arnaumora/TFG-Plataforma-Instrumentacion-Avionica/LATEX/Annexes/Files/00_Portada.tex

\newgeometry{left=3cm, right=0.5cm, top=2cm, bottom=2cm, headheight=0pt, headsep=0pt}

\pagestyle{empty}

\begin{spacing}{1.0}

% Logo UPC
\begin{figure}[h]

\end{figure}

% Banner vertical 
\begin{wrapfigure}{r}{0.25\textwidth} 
    \centering
    
\end{wrapfigure}

\phantom{abs}

\vspace{0.8cm}

% Título del TFG

\hfuzz=30pt

\textbf{\scalebox{2.4}{\textcolor{RoyalBlue}{Diseño e implementación de }}}

\vspace{0.3cm}

\textbf{\scalebox{2.4}{\textcolor{RoyalBlue}{una plataforma experimental }}}

\vspace{0.3cm}

\textbf{\scalebox{2.4}{\textcolor{RoyalBlue}{de instrumentación aviónica}}}

\hfuzz=0pt

\vspace{1.8cm}

% Documento
\textbf{\scalebox{1.5}{Documento:}}

\vspace{0.5cm}
\scalebox{1.5}{\textcolor{RoyalBlue}{Apendices y anexos}}

\vspace{1.5cm}

% Autor
\textbf{\scalebox{1.5}{Autor:}}

\vspace{0.5cm}
\scalebox{1.5}{\textcolor{RoyalBlue}{Arnau Mora Perez}}

\vspace{1.5cm}

% Director
\textbf{\scalebox{1.5}{Director/a:}}

\vspace{0.5cm}
\scalebox{1.5}{\textcolor{RoyalBlue}{Juan Mon González}}

\vspace{0.5cm}
\scalebox{1.5}{\textcolor{RoyalBlue}{Javier Gago Barrio}}

\vspace{1.5cm}

% Titulación
\textbf{\scalebox{1.5}{Titulación:}}

\vspace{0.5cm}
\scalebox{1.5}{\textcolor{RoyalBlue}{Grado en Ingeniería en Vehículos Aeroespaciales}}

\vspace{1.5cm}

% Convocatoria
\textbf{\scalebox{1.5}{Convocatoria:}}

\vspace{0.5cm}
\scalebox{1.5}{\textcolor{RoyalBlue}{Primavera, 2026}}

\end{spacing}

\restoregeometry
