arnaumora/TFG-Plataforma-Instrumentacion-Avionica/Presentacio/Spanish/Guion_ES.docx

# Guion de la presentacion

## Diapositiva 1 - Portada (~30 s)

Buenos dias. Soy Arnau Mora Perez y presento mi Trabajo de Fin de Grado, titulado 'Diseno e implementacion de una plataforma experimental de instrumentacion avionica', dirigido por Juan Mon y Javier Gago. El objetivo es construir una plataforma educativa y de bajo coste que recorra toda la cadena de instrumentacion de vuelo, desde el sensor hasta la pantalla.

## Diapositiva 2 - Indice (~20 s)

El recorrido sera el siguiente: motivacion y objetivo, arquitectura, los tres subsistemas (hardware, firmware y software), la telemetria, la validacion frente a los requisitos, y las conclusiones.

## Diapositiva 3 - Motivacion (~1 min)

La motivacion son las tres ideas de la diapositiva. Primera: la instrumentacion real es cara y cerrada. Los sistemas comerciales son propietarios y, aunque el ecosistema de drones (Betaflight, iNav) tiene firmware muy maduro, son millones de lineas de codigo y sus pantallas no siguen la normativa aeronautica. Segunda: hay un hueco didactico. En el aula se usan simuladores de vuelo sin hardware real; falta un puente, una plataforma fisica y abierta que muestre como funciona de verdad la instrumentacion. Y tercera: hoy es viable a bajo coste. Los sensores MEMS y los microcontroladores actuales permiten replicar toda la cadena por menos de 100 euros. Esa es la motivacion.

## Diapositiva 4 - Objetivo (~45 s)

El objetivo es disenar e implementar esta plataforma completa: capturar las magnitudes de vuelo con sensores, transmitirlas de forma inalambrica con un formato aeronautico, y representarlas en un Primary Flight Display conforme a la disposicion Basic-T. Todo por debajo de 100 euros de materiales y con software abierto.

## Diapositiva 5 - Requisitos (~1 min)

Aunque la plataforma no requiere certificacion, los requisitos se han derivado de normas aeronauticas reales para que sean medibles. Hay requisitos funcionales, de rendimiento, de coste y normativos. Los de rendimiento clave: latencia extremo a extremo por debajo de 200 ms, refresco del PFD de al menos 30 FPS, actitud dentro de 3 grados y posicionamiento GNSS mejor que 2,5 m. Sobre estos numeros se hara la validacion al final.

## Diapositiva 6 - Arquitectura (~1 min)

El sistema se divide en tres bloques. Un nodo transmisor con todos los sensores y un ESP32-S3, que adquiere y fusiona las medidas. Un enlace de radio, con un transceptor NRF24 en cada nodo, que transporta la telemetria. Y un nodo receptor con un ESP32-C3 que entrega los datos al PC por USB, donde Processing dibuja el PFD. La informacion fluye en un solo sentido: del sensor a la pantalla.

## Diapositiva 7 - Decisiones de diseno (~1 min 15 s)

Antes de entrar en el hardware, justifico tres decisiones de arquitectura. Primero, por que dos nodos y no uno: porque refleja la arquitectura real de una aeronave, da movilidad al nodo de sensores frente al PC fijo, y anade un enlace inalambrico con valor docente. Segundo, el enlace: se descartaron el cable, WiFi-UDP y Bluetooth, y se eligio un transceptor RF a 2,4 GHz por baja latencia, alcance suficiente y bajo coste. Y tercero, la telemetria usa la capa logica de ARINC 429, el bus de datos mas extendido en aviacion, por trazabilidad con la practica real y por valor docente. Un detalle que cierra el diseno: el payload de 32 bytes de la radio equivale exactamente a 8 palabras ARINC de 32 bits, asi que no hace falta fragmentar.

## Diapositiva 8 - Hardware: la PCB (~1 min)

El nodo transmisor se ha disenado como PCB propia de dos capas en KiCad, fabricada por JLCPCB. Integra el ESP32-S3, la IMU MPU-9250 con magnetometro, el barometro BMP280, el GNSS NEO-6M, el sensor de distancia VL53L1X, un radar y el modulo de radio NRF24 con amplificador. La alimentacion entra por USB-C: un regulador LDO da el rail de 3,3 V, y el rail de 5 V del propio USB alimenta los modulos que lo requieren.

## Diapositiva 9 - La placa fabricada (~45 s)

Aqui esta el hardware real. A la izquierda, el nodo transmisor ya fabricado y montado; a la derecha, el nodo receptor con el ESP32-C3. La placa funciono a la primera tras el bring-up: verificacion de continuidad contra el netlist con la placa sin alimentar, y medida de los railes de 5 y 3,3 voltios, que quedaron dentro de tolerancias.

## Diapositiva 10 - Seleccion del filtro de fusion (~1 min 15 s)

Para estimar la orientacion hay que fusionar acelerometro, giroscopio y magnetometro. He comparado las opciones: el filtro complementario es muy barato pero no corrige la deriva del giroscopio; Madgwick da una precision similar pero sin ajuste independiente del transitorio; EKF y UKF tienen mas coste de computo del necesario aqui; y el filtro de particulas, aunque preciso, es inviable en tiempo real sobre un ESP32. Se eligio Mahony porque compensa activamente la deriva del giroscopio con su termino integral PI, tiene un coste de computo bajo apto para el ESP32, y permite ajustar la respuesta con dos parametros. Varios estudios sobre ESP32 avalan esta eleccion.

## Diapositiva 11 - Firmware: fusion sensorial (~1 min 15 s)

En la implementacion del Mahony, los parametros son Kp = 3,0 y Ki = 1,0, con la fusion funcionando a 100 Hz. Para evitar el retardo de convergencia al arrancar, el cuaternion se inicializa de forma analitica a partir del acelerometro y el magnetometro, en lugar de partir de cero. Asi, desde el primer instante la actitud es valida y el termino integral solo tiene que seguir la deriva lenta del giroscopio.

## Diapositiva 12 - Telemetria ARINC 429 (~1 min 15 s)

La telemetria viaja codificada en palabras ARINC 429 de 32 bits, con sus etiquetas, codificacion BNR, bit de paridad y campo de estado. Como una sola palabra no basta para todos los parametros, el paquete se organiza asi: la actitud y el rumbo ocupan tres slots fijos a 20 Hz, y un planificador de tipo EDF, por plazo mas proximo, reparte los cinco slots restantes: barometro, velocidad vertical, radar y distancia a 10 Hz, y GPS y estado a 5 Hz. Cada paquete son 8 palabras de 32 bits, justo los 32 bytes del payload de la radio, que va a 250 kbps. El alcance, del orden de 100 m en interior, se justifica por margen de diseno; lo retomo en la validacion.

## Diapositiva 13 - El PFD Basic-T (~1 min)

La visualizacion sigue la disposicion Basic-T, conforme al patron que recoge la AC 25-11B: horizonte artificial en el centro, velocidad a la izquierda, altitud a la derecha y rumbo debajo, con la velocidad vertical y la proximidad integradas. Esta distribucion aprovecha el barrido visual natural del piloto. Esta hecho en Processing y refresca a 60 FPS, por encima del minimo de 30.

## Diapositiva 14 - Navegacion: mapa (~45 s)

En una pantalla aparte, conmutable por teclado, hay una vista de mapa que dibuja la posicion GNSS sobre teselas topograficas offline del ICGC. Se mantiene separada del Basic-T para no romper la disposicion normativa. La descarga de teselas en linea queda como trabajo futuro.

## Diapositiva 15 - Validacion: cumplimiento (~1 min 15 s)

Esta es la tabla de cumplimiento, la misma que consta en la memoria. Cada requisito de rendimiento se contrasta con el resultado medido o acotado. La latencia extremo a extremo, acotada analiticamente, sale en torno a los 85 ms en el peor caso, frente a los 200 de limite. El refresco del PFD, 60 FPS, el doble del minimo. La actitud, dentro de 1,8 grados en estatico. El GNSS, con un CEP50 de 1 metro, mejor que los 2,5 exigidos. Y el alcance del enlace, del orden de 100 m por margen de diseno, muy por encima del uso real en el laboratorio. Todos los requisitos se cumplen, y los funcionales, RF01 a RF09, quedan cubiertos con el sistema integrado.

## Diapositiva 16 - Validacion: cifras de merito (~1 min)

Aqui estan las cifras de merito juntas, y quiero ser explicito con la naturaleza de cada una. La actitud, 1,8 grados de error maximo, y el GNSS, 1 metro de CEP50, son medidas en estatico. La latencia, unos 85 ms, es una cota analitica de peor caso: la suma de los retardos de transporte de la cadena. Y el alcance, del orden de 100 m, procede del margen de diseno de la hoja de datos, no de una medida de campo. Distinguir lo medido de lo acotado forma parte del rigor de la validacion.

## Diapositiva 17 - Conclusiones (~1 min)

Como conclusiones: se ha construido una plataforma completa y funcional que recorre toda la cadena, del sensor al PFD, siguiendo criterios aeronauticos reales, por debajo de 100 euros y con software abierto. Cumple todos los requisitos de rendimiento planteados, y como herramienta docente permite estudiar fusion sensorial, codificacion aeronautica y enlaces inalambricos sobre hardware real.

## Diapositiva 18 - Trabajo futuro (~45 s)

De cara al futuro, cuatro lineas. La descarga en linea de teselas de mapa. La caracterizacion real del enlace, con medidas de alcance y de tasa de perdida de paquetes. Incorporar el radar como fuente de proximidad, una vez estabilizada su lectura. Y, como linea mas ambiciosa, la integracion del sistema en un vehiculo aereo real.

## Diapositiva 19 - Gracias / demo (~30 s + demo)

Con esto termino. Gracias por su atencion. Si lo desean, puedo mostrar el sistema en funcionamiento. Quedo a su disposicion para las preguntas.
