arnaumora/TFG-Plataforma-Instrumentacion-Avionica/Entrega/Budget.pdf

# Diseño e implementación de una plataforma experimental de instrumentación aviónica

## Documento:

## Presupuesto

## Autor:

## Arnau Mora Perez

## Director/a:

## Juan Mon González Javier Gago Barrio

## Titulación:

## Grado en Ingeniería en Vehículos Aeroespaciales

## Convocatoria:

## Primavera, 2026

Intentionally left blank

# Capítulo 1

# Presupuesto

En este documento se detalla el presupuesto del proyecto, el desglose completo del coste de desarrollo de la plataforma experimental de instrumentación aviónica. El coste se desglosa en el coste de los materiales, la amortización de los equipos empleados, el coste de personal y el coste de software. Los costes de los componentes se detallan en la memoria, en el capítulo de diseño de hardware.
Salvo que se indique lo contrario, los precios son orientativos y se basan en el coste de mercado de los componentes y en tarifas de referencia.

## 1.1. Coste de materiales

El coste de los materiales corresponde a los componentes electrónicos del sistema, la placa de circuito impreso (PCB) y los componentes pasivos y conectores. El subtotal de módulos se toma del resumen de componentes de la memoria. La PCB se fabrica mediante el servicio JLCPCB,
i
en una única orden que integra tanto el nodo transmisor como el nodo receptor.
En la Tabla 1.1 se pueden ver los valores de todos los componentes.
iServicio de fabricación de PCB de bajo coste: https://jlcpcb.com/. El coste depende del número de unidades de la tirada y del envío.

1

CAPÍTULO 1. PRESUPUESTO | 2

Tabla 1.1: Coste de materiales

Concepto | Coste
Microcontrolador TX (ESP32-S3 DevKit) | 7 e
Microcontrolador RX (ESP32-C3 Super Mini) | 4 e
IMU + magnetómetro (MPU-9250) | 6 e
Barómetro (BMP280) | 3 e
Receptor GNSS (NEO-6M) | 10 e
Sensor ToF (VL53L1X) | 8 e
Sensor radar (HLK-LD2410C) | 9 e
Transceptor RF, 2 uds (nRF24L01+ PA/LNA) | 8 e
Subtotal módulos | 55 e
PCB (2 capas, JLCPCB, incl. envío) | 25 e
Componentes pasivos y conectores | 12 e
Total materiales | 92 e

El coste total de materiales se mantiene por debajo de los 100 e, cumpliendo la restricción de coste de materiales del proyecto (RC01).

## 1.2. Amortización de equipos

Para el desarrollo se han empleado diversos equipos de laboratorio cuyo coste no se imputa de forma íntegra, sino mediante amortización lineal en proporción a las horas de uso sobre su vida útil. La amortización de cada equipo se calcula como:

A =

V
Tvida

·

huso
hanual

(1.1)

donde V es el valor de adquisición, Tvida la vida útil en años, huso las horas de uso en el proyecto y hanual las horas anuales de trabajo, estimadas en 1.800 h. La Tabla 1.2 recoge la estimación para cada equipo.

Tabla 1.2: Amortización de equipos

Equipo | Valor (e) | Vida útil (años) | Uso (h) | Amort. (e)
Osciloscopio | 400 | 10 | 20 | 0,44
Multímetro | 40 | 10 | 30 | 0,07
Estación de soldadura | 80 | 10 | 15 | 0,07
Ordenador | 1.000 | 6 | 400 | 37,04
Total amortización | | | | 37,62

## 1.3. Coste de personal

El coste de personal corresponde a las horas de ingeniería dedicadas al diseño, el desarrollo, la validación y la redacción del trabajo. La dedicación se estima a partir de los créditos ECTS del TFG: la normativa de la UPC establece una carga de trabajo de 25 h por crédito ECTS,ii lo que para un TFG de 24 ECTS equivale a 600 h. Se aplica una tarifa orientativa de 18 e/h correspondiente a un ingeniero junior.iii
La Tabla 1.3 recoge la estimación.
Tabla 1.3: Coste de personal
Concepto | | Horas | Tarifa | Coste
Ingeniería (diseño, desarrollo, validación y redacción) | 600 | 18 e/h | 10.800 e
Total personal | | | | 10.800 e

## 1.4. Coste de software

Todo el software utilizado en el proyecto es de código abierto o de uso gratuito, en cumplimiento de la restricción RC02. El firmware se desarrolla en el IDE de Arduino, el software de visualiza-ción en Processing, el diseño de la PCB en KiCad y la redacción de la documentación en LaTeX. Ninguna de estas herramientas conlleva coste de licencia, por lo que el coste de software es de 0 e.
iiNormativa del Trabajo de Fin de Grado y de Máster de la UPC: la carga de trabajo equivalente es de 1 ECTS por 25 horas de trabajo del estudiantado.
iiiTarifa orientativa basada en salarios de referencia para ingenieros en España (p. ej. https://es.talent.com/salary). (https://es.talent.com/salary)

El consumo eléctrico asociado al desarrollo es despreciable, aun asi se considera que queda recogido de forma indirecta en la amortización del ordenador, por lo que no se contabiliza de forma separada.

## 1.5. Resumen del presupuesto

La Tabla 1.4 agrupa todos los costes anteriores. Sobre la suma de las partidas se aplica un 10 % correspondiente a costes indirectos y, finalmente, el impuesto sobre el valor añadido (IVA) del 21 %.
Tabla 1.4: Resumen del presupuesto
Concepto | Coste
Materiales | 92 e
Amortización de equipos | 37,62 e
Software | 0 e
Personal | 10.800 e
Subtotal | 10.929,62 e
Costes indirectos (10 %) | 1.092,96 e
Total (sin IVA) | 12.022,58 e
IVA (21 %) | 2.524,74 e
Total (con IVA) | 14.547,32 e

El coste total del proyecto asciende a 14.547,32 e (IVA incluido). Como es habitual en proyectos de esta naturaleza, el coste está dominado por el coste de personal, mientras que el coste de materiales resulta marginal, en parte gracias al uso de hardware de bajo coste y software de código abierto.
