arnaumora/TFG-Plataforma-Instrumentacion-Avionica/Entrega/Compressed/Anexos.pdf

# Diseño e implementación de una plataforma experimental de instrumentación aviónica

# Documento:

# Apendices y anexos

# Autor:

# Arnau Mora Perez

# Director/a:

# Juan Mon González Javier Gago Barrio

# Titulación:

# Grado en Ingeniería en Vehículos Aeroespaciales

# Convocatoria:

# Primavera, 2026

Intentionally left blank

# Índice general

1. ANEXO I. Código Arduino | 1
2. ANEXO II. Código Processing | 51
3. ANEXO III. Figuras de apoyo | 88

I

# Índice de figuras

II

# Índice de tablas

III

# Capítulo 1

# ANEXO I. Código Arduino

1 // FlightInstruments.ino - Sketch principal (transmisor)
2 //
3 // TFG: Diseno e implementacion de una plataforma experimental de 4 // instrumentacion avionica.

5
6 #include <Wire.h>
7 #include "Config.h"
8 #include "SensorData.h"

9
10 // Estructuras de datos 11 RawIMU rawIMU;
12 FlightData flightData;
13 BaroData baroData;
14 GPSData gpsData;
15 RadarData radarData;
16 ToFData tofData;

17
18 // Timers para scheduling cooperativo. Cada subsistema corre a su 19 // frecuencia natural sin bloquear a los demas. El loop principal 20 // solo dispara la tarea que toca segun el reloj.
21 unsigned long lastSensorRead | = 0;
22 unsigned long lastBaroRead | = 0;
23 unsigned long lastSerialPrint = 0;
24 unsigned long lastTelemetrySend = 0;

25
26 bool radioAvailable = false;

27
28 // Contadores de transmision, definidos en Telemetry.ino 29 extern uint32_t txCount;

1

CAPÍTULO 1. ANEXO I. CÓDIGO ARDUINO | 2

30 extern uint32_t txFailCount;

32 void setup() {
Serial.begin(115200);
delay(2000);

Serial.println(" Flight Instruments");
Serial.println(" ESP32-S3 + MPU-9250 + BMP280 + VL53L1X"); Serial.println(" + NEO-6M + LD2410C + NRF24L01+PA+LNA"); Serial.println(" Filtro: Mahony MARG (9 ejes)");

neopixelWrite(PIN_LED_RGB, 30, 0, 0); // rojo = booting

// XSHUT del ToF en alto para que el sensor arranque pinMode(TOF_SHUT_PIN, OUTPUT);
digitalWrite(TOF_SHUT_PIN, HIGH);
delay(10);

// Interrupciones (no usadas, solo se dejan los pines configurados) pinMode(TOF_IRQ_PIN, INPUT);
pinMode(RADAR_IRQ_PIN, INPUT);
pinMode(MPU_IRQ_PIN, INPUT);

// Bus I2C compartido
Wire.begin(PIN_SDA, PIN_SCL);
Wire.setClock(I2C_CLOCK);
Serial.println("I2C OK (400 kHz)");

// IMU. Es el unico sensor critico: si falla se bloquea el arranque if (!initIMU()) {
Serial.println("FATAL: fallo al inicializar el IMU");
while (true) { // parpadeo rojo perpetuo neopixelWrite(PIN_LED_RGB, 30, 0, 0); delay(300); neopixelWrite(PIN_LED_RGB, 0, 0, 0); delay(300);

}

}

// Calibracion del giroscopio
calibrateGyro();

initFusion(flightData);

// Semilla del cuaternion con una muestra accel+mag para que el // filtro Mahony arranque mas cerca de la orientacion real

delay(20);
readIMU(rawIMU);
seedQuaternionFromIMU(rawIMU);

// Sensores no criticos: si alguno falla el sistema sigue, solo // queda marcado con ok=false y la palabra ARINC correspondiente
// se transmite con SSM=NO_DATA
baroData.ok = initBarometer();
if (!baroData.ok) Serial.println("AVISO: barometro offline, sin altitud barometrica");

tofData.ok = initToF();
if (!tofData.ok) Serial.println("AVISO: ToF offline, sin distancia al suelo") ;

initGPS(); // el flag ok se activa en el primer readGPS() valido radarData.ok = initRadar();

radioAvailable = initTelemetry();
if (!radioAvailable) Serial.println("AVISO: radio offline, sigue sin telemetria");

93 #ifdef CALIBRATE_MAG
runMagCalOperational(); // solo la LLAMADA; captura y luego halt 95 #endif

neopixelWrite(PIN_LED_RGB, 0, 30, 0); // verde = listo Serial.println("\nSistema listo. Streaming...\n");

99 }

101 void loop() {
unsigned long nowUs = micros();
unsigned long nowMs = millis();

// Alimentamos buffers de UART cada iteracion (no bloqueante).
// Si se descuida aunque sea un ciclo, la UART se satura y se pierden frames. feedGPS();
feedRadar();

// IMU + fusion a 100 Hz
if (nowUs - lastSensorRead >= SENSOR_INTERVAL_US) { lastSensorRead = nowUs;
readIMU(rawIMU);
updateFusion(rawIMU, flightData);

}

// Barometro a 10 Hz
if (baroData.ok && (nowMs - lastBaroRead >= BARO_INTERVAL_MS)) { lastBaroRead = nowMs;
readBarometer(baroData);

}

// ToF (no bloqueante, solo actualiza si hay muestra nueva) readToF(tofData);

// GPS
readGPS(gpsData);

// Radar (recibe la velocidad GPS para filtrar detecciones estaticas o en movimiento)
float platformSpeed = gpsData.fix ? gpsData.speed_kmh : 0.0f; readRadar(radarData, platformSpeed);

// Telemetria a 20 Hz
if (radioAvailable && (nowMs - lastTelemetrySend >= TELEMETRY_INTERVAL_MS)) { lastTelemetrySend = nowMs;
sendTelemetry(flightData, baroData, gpsData, radarData, tofData);

}

// Debug por serial a 10 Hz. Solo se compila si DEBUG_SERIAL esta // definido (ver Config.h) ya que el transmisor normalmente no esta // conectado por USB, asi se ahorra computacion.
143 #ifdef DEBUG_SERIAL
if (nowMs - lastSerialPrint >= SERIAL_PRINT_INTERVAL) { lastSerialPrint = nowMs;

// Magnitud del campo magnetico para diagnostico float magMag = sqrtf(rawIMU.mx * rawIMU.mx
+ rawIMU.my * rawIMU.my
+ rawIMU.mz * rawIMU.mz);

float lossPct = (txCount > 0) ? (txFailCount * 100.0f / txCount) : 0.0f; Serial.printf(
"P: %.1f R: %.1f H: %.1f |Mag: %.1fuT| Alt: %.1f VS: %.1f | Sat: %d %s"
" | Rdr: %ucm ToF: %umm | TX: %lu L: %.1f % %\n",
flightData.pitch, flightData.roll, flightData.heading, magMag, baroData.altitude_m, baroData.vspeed_mps, gpsData.satellites, gpsData.fix ? "Fix" : "NoFix", radarData.bestDist_cm, tofData.distance_mm, txCount, lossPct

);

}
163 #endif

164 }

168 // Calibracion del magnetometro
169 // Calibracion hard/soft iron con el sistema completo en operacion.

171 #ifdef CALIBRATE_MAG
172 extern float magCalX, magCalY, magCalZ; // ASA de fabrica, definidos en IMU. ino

174 void runMagCalOperational() {
Serial.println("\nCAL MAG: Esperando fix GPS con el sistema en operacion...") ;
unsigned long tStart = millis(), tWarmTx = 0, tWarmPrint = 0;

// Bucle que no termina hasta que el GPS obtenga un Fix válido
while (!gpsData.fix) {
// Reproduce el loop normal para mantener el sistema vivo feedGPS(); feedRadar();
readIMU(rawIMU);
updateFusion(rawIMU, flightData); readBarometer(baroData);
readToF(tofData);
readGPS(gpsData);
readRadar(radarData, gpsData.fix ? gpsData.speed_kmh : 0.0f);

// Comprobamos radioAvailable antes de transmitir
if (radioAvailable && (millis() - tWarmTx >= TELEMETRY_INTERVAL_MS)) { tWarmTx = millis();
sendTelemetry(flightData, baroData, gpsData, radarData, tofData);

}

// Imprimir el estado cada segundo para ver el progreso
if (millis() - tWarmPrint > 1000) {
tWarmPrint = millis();
Serial.print("WARMUP: Esperando GPS... Tiempo transcurrido: "); Serial.print((millis() - tStart) / 1000UL);

Serial.print("s GPS: NoFix"); Serial.print(" Sat: ");
Serial.println(gpsData.satellites);

}

}

Serial.println("\nGPS Fix conseguido. Dando 5 segundos de estabilizacion final...");
delay(5000);

Serial.println("\nCAL MAG: rotar LENTO en los 3 ejes durante 30 s");
for (int i = 5; i > 0; i--) { Serial.print(i); Serial.print("... "); delay (1000); }
Serial.println("\n>>> ROTAR AHORA <<<\n");

float minX=1e6f, minY=1e6f, minZ=1e6f;
float maxX=-1e6f, maxY=-1e6f, maxZ=-1e6f; unsigned long t0 = millis(), tTx = 0, tPrint = 0;
uint32_t n = 0;

while (millis() - t0 < 30000UL) {
// Reproduce el loop normal: radio TX a 20 Hz + todos los sensores activos // Asi la calibracion se hace con los sensores en funcionamiento feedGPS(); feedRadar();
readIMU(rawIMU);
updateFusion(rawIMU, flightData);
readBarometer(baroData);
readToF(tofData);
readGPS(gpsData);
readRadar(radarData, gpsData.fix ? gpsData.speed_kmh : 0.0f);

// Comprobamos radioAvailable antes de transmitir
if (radioAvailable && (millis() - tTx >= TELEMETRY_INTERVAL_MS)) { tTx = millis();
sendTelemetry(flightData, baroData, gpsData, radarData, tofData);

}

// Mag SOLO con ASA (sin offset/scale) Wire.beginTransmission(AK8963_ADDR); Wire.write(0x03); Wire.endTransmission (false);
Wire.requestFrom(AK8963_ADDR, (byte)7);
if (Wire.available() >= 7) {
int16_t xr = Wire.read() | (Wire.read() << 8);
int16_t yr = Wire.read() | (Wire.read() << 8);

241 | int16_t zr = Wire.read() | (Wire.read() << 8);
242 | (void)Wire.read(); // ST2, obligatorio leerlo
243 | float mx = xr * MAG_SCALE * magCalX;
244 | float my = yr * MAG_SCALE * magCalY;
245 | float mz = zr * MAG_SCALE * magCalZ;
246 | if (mx<minX) minX=mx; if (mx>maxX) maxX=mx;
247 | if (my<minY) minY=my; if (my>maxY) maxY=my;
248 | if (mz<minZ) minZ=mz; if (mz>maxZ) maxZ=mz;
249 | n++;
250 | }

251
252 | if (millis() - tPrint > 1000) {
253 | tPrint = millis();
254 | Serial.print("CAL t-"); Serial.print((30000UL - (millis()-t0)) / 1000UL);
255 | Serial.print("s N="); Serial.println(n);
256 | }
257 | }

258
259 | // Offset = centro del elipsoide. escala = correccion soft iron por eje
260 | float offX=(maxX+minX)*0.5f, offY=(maxY+minY)*0.5f, offZ=(maxZ+minZ)*0.5f;
261 | float rX=(maxX-minX)*0.5f, rY=(maxY-minY)*0.5f, rZ=(maxZ-minZ)*0.5f;
262 | float avg=(rX+rY+rZ)/3.0f;
263 | float scX=(rX>0.1f)?avg/rX:1.0f, scY=(rY>0.1f)?avg/rY:1.0f, scZ=(rZ>0.1f)?avg
| /rZ:1.0f;

264
265 | Serial.println("\nCALIBRACION COMPLETADA");
266 | Serial.print("Muestras: "); Serial.println(n);
267 | Serial.print("Magnitud media: "); Serial.print(avg,1);
268 | Serial.println(" uT (esperado ~46 uT, WMM2025 Terrassa)");
269 | Serial.println("\nPEGAR EN Config.h (sustituir las 6 lineas existentes):\n");
270 | Serial.print("#define MAG_OFFSET_X | "); Serial.print(offX,4); Serial.
| println("f");
271 | Serial.print("#define MAG_OFFSET_Y | "); Serial.print(offY,4); Serial.
| println("f");
272 | Serial.print("#define MAG_OFFSET_Z | "); Serial.print(offZ,4); Serial.
| println("f");
273 | Serial.print("#define MAG_SCALE_X | "); Serial.print(scX,4); Serial.
| println("f");
274 | Serial.print("#define MAG_SCALE_Y | "); Serial.print(scY,4); Serial.
| println("f");
275 | Serial.print("#define MAG_SCALE_Z | "); Serial.print(scZ,4); Serial.
| println("f");

276
277 while (true) { // halt: no seguir al loop normal. Reflashear sin

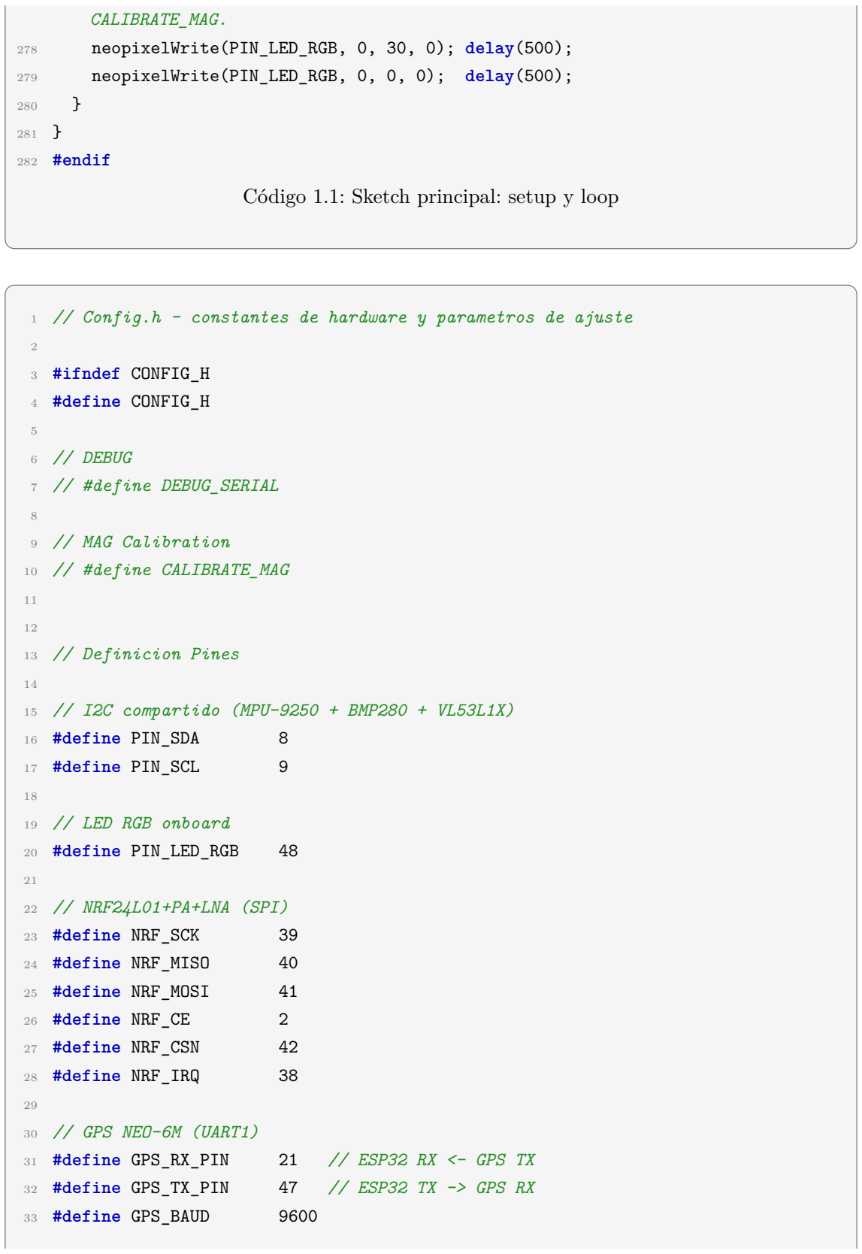
[picture p34: figure]
CALIBRATE_MAG.; neopixelWrite(PIN_LED_RGB, 0, 30, 0); delay(500);; neopixelWrite(PIN_LED_RGB, 0, 0, 0); delay(500);; 281 } 282 #endif; 2 3 #ifndef CONFIG_H 4 #define CONFIG_H; 5 6 // DEBUG 7 // #define DEBUG_SERIAL; 8 9 // MAG Calibration 10 // #define CALIBRATE_MAG; 12 13 // Definicion Pines; 16 #define PIN_SDA; 17 #define PIN_SCL; 18 19 // LED RGB onboard; 20 #define PIN_LED_RGB; 21 22 // NRF24L01+PA+LNA (SPI); 23 #define NRF_SCK; 24 #define NRF_MISO; 25 #define NRF_MOSI; 26 #define NRF_CE; 27 #define NRF_CSN; 28 #define NRF_IRQ; 29 30 // GPS NEO-6M (UART1); 33 #define GPS_BAUD

Código 1.1: Sketch principal: setup y loop

1 // Config.h - constantes de hardware y parametros de ajuste

15 // I2C compartido (MPU-9250 + BMP280 + VL53L1X)

31 #define GPS_RX_PIN | 21 // ESP32 RX <- GPS TX
32 #define GPS_TX_PIN | 47 // ESP32 TX -> GPS RX

34
35 // HLK-LD2410C radar (UART2) 36 #define RADAR_RX_PIN 17 37 #define RADAR_TX_PIN 18
38 #define RADAR_BAUD 256000

39
40 // Interrupciones / control (no usadas en el codigo, pero asignadas) 41 #define TOF_SHUT_PIN 11 // XSHUT del TOF400C
42 #define TOF_IRQ_PIN 10 // INT del TOF400C
43 #define RADAR_IRQ_PIN 16
44 #define MPU_IRQ_PIN 4

45
46 // Direcciones I2C
47 #define MPU9250_ADDR 0x68 // AD0 a GND
48 #define AK8963_ADDR | 0x0C // magnetometro en el MPU-9250
49 #define BMP280_ADDR | 0x76 // SDO a GND
50 #define VL53L1X_ADDR 0x29 // direccion por defecto del TOF400C 51 #define I2C_CLOCK 400000 // 400 kHz (Fast Mode)

52
53 // Rangos del MPU-9250
54 // Factores sacados del datasheet PS-MPU-9250A-01 Rev 1.1
55 #define ACCEL_SCALE | 8192.0 // LSB/g | a +/-4g
56 #define GYRO_SCALE | 65.5 | // LSB/(deg/s) a +/-500deg/s
57 #define MAG_SCALE | 0.15 | // uT/LSB | en 16 bits

58
59 // BMP280
60 #define SEA_LEVEL_HPA | 1013.25f // presion de referencia ISA
61 #define VSPEED_ALPHA | 0.2f | // suavizado EMA de la velocidad vertical

62
63 // VL53L1X / TOF400C
64 #define TOF_TIMING_BUDGET_US 50000 // 50 ms modo Long permite hasta 4 m
65 #define TOF_CONTINUOUS_MS | 50 | // 20 Hz
66 #define TOF_DEAD_ZONE_MM | 40 | // por debajo de aqui la medida no es
fiable

67
68 // HLK-LD2410C

69
70 // Resolucion del gate.
71 #define RADAR_GATE_WIDTH_CM 20

72
73 // Thresholds por gate (downward-facing)
74 #define RADAR_SENS_GATE_0 | 80 // 0.00 - 0.20 m
75 #define RADAR_SENS_GATE_1 | 70 | // 0.20 - 0.40 m
76 #define RADAR_SENS_GATE_2 | 60 | // 0.40 - 0.60 m

77 #define RADAR_SENS_GATE_3 | 50 | // 0.60 - 0.80 m
78 #define RADAR_SENS_GATE_FAR | 35 | // 0.80 - 1.80 m (gates 4-8)

79
80 // Peak-finder (modo enhanced)
81 #define RADAR_NOISE_FLOOR 40

82
83 // Suavizado EMA de la distancia derivada por gate
84 #define RADAR_DIST_ALPHA 0.40f

85
86 #define RADAR_HOVER_SPEED_KMH 2.0f // por debajo de esta velocidad se considera hover
87 #define RADAR_ALERT_ENERGY_MIN 30 // energia minima para disparar alerta

88
89 // Zona de proximidad en funcion de la distancia
90 #define RADAR_ZONE_NONE | 0
91 #define RADAR_ZONE_DANGER | 1 | // 0.00 - 0.60 m (gates 0-2)
92 #define RADAR_ZONE_CAUTION | 2 | // 0.60 - 1.20 m (gates 3-5)
93 #define RADAR_ZONE_CLEAR | 3 | // 1.20 - 1.80 m (gates 6-8)

94
95 // Tasas de muestreo
96 #define SENSOR_RATE_HZ | 100 | // IMU + fusion
97 #define SENSOR_INTERVAL_US (1000000 / SENSOR_RATE_HZ)

98
99 #define BARO_RATE_HZ | 10
100 #define BARO_INTERVAL_MS | (1000 / BARO_RATE_HZ)

101
102 #define RADAR_PRINT_HZ 2
103 #define RADAR_PRINT_INTERVAL (1000 / RADAR_PRINT_HZ)

104
105 #define SERIAL_PRINT_HZ 10
106 #define SERIAL_PRINT_INTERVAL (1000 / SERIAL_PRINT_HZ)

107
108 // Calibracion del giroscopio
109 #define CALIBRATION_SAMPLES | | 500
110 #define CALIBRATION_VARIANCE_THRESHOLD 2.0

111
112 // Mahony
113 #define MAHONY_KP | 3.0f
114 #define MAHONY_KI | 1.0f

115

116
117 // CALIBRACION DEL MAGNETOMETRO (Hard iron / Soft iron)

118
119 // Hard iron offsets (uT)

120 #define MAG_OFFSET_X | 10.6264f
121 #define MAG_OFFSET_Y | -2.6479f
122 #define MAG_OFFSET_Z | -30.1492f

123
124 // Soft iron scales (adimensional)
125 #define MAG_SCALE_X | 1.0157f
126 #define MAG_SCALE_Y | 0.9977f
127 #define MAG_SCALE_Z | 0.9884f

128
129 // CORRECCIONES DE HEADING

130 //
131 // Declinacion magnetica
132 // Diferencia entre el norte magnetico (lo que mide el sensor) y el
133 // norte geografico verdadero. Para obtener el valor real visitar la web 134 // (https://www.ncei.noaa.gov/products/world-magnetic-model)

135
136 #define MAG_DECLINATION_DEG 1.95f

137
138 // Offset entre el "forward" del IMU y el "forward" de la PCB 139 // Si la IMU esta rotada respecto a la placa, el heading
140 // tendra un offset constante respecto al norte real.
141 // Tambien se puede usar para corregir errores constantes 142 // que no provienen de la orientacion de la PCB

143
144 #define HEADING_BODY_OFFSET_DEG -5.0f

145
146 // Calibracion actitud
147 #define PITCH_MOUNT_OFFSET_DEG | 0.6f
148 #define ROLL_MOUNT_OFFSET_DEG | 0.2f

149

150
151 // NRF24L01
152 #define NRF_CHANNEL | 108
153 #define NRF_DATA_RATE | RF24_250KBPS
154 #define NRF_PA_LEVEL | RF24_PA_HIGH
155 #define NRF_RETRY_DELAY | 5
156 #define NRF_RETRY_COUNT | 15

157
158 #define NRF_ADDR_TX | "SENSR"
159 #define NRF_ADDR_RX | "CNTRL"

160
161 #define TELEMETRY_RATE_HZ 20
162 #define TELEMETRY_INTERVAL_MS (1000 / TELEMETRY_RATE_HZ)

163

164 #endif
Código 1.2: Constantes de hardware y parámetros de ajuste

1 // SensorData.h - estructuras de datos compartidas entre los archivos.

2
3 #ifndef SENSORDATA_H
4 #define SENSORDATA_H

5
6 // IMU sin procesar (MPU-9250 + AK8963)
7 struct RawIMU {
8 | float ax, ay, az; // acelerometro (g)
9 | float gx, gy, gz; // giroscopio (deg/s), ya con bias restado
10 | float mx, my, mz; // magnetometro (uT), ya con ASA aplicado

11 };

12
13 // AHRS ya fusionado
14 struct FlightData {
15 | float pitch; | // -90 a +90deg (nariz arriba positivo)
16 | float roll; | // -180 a +180deg (ala derecha abajo positivo)
17 | float heading; | // 0 a 360deg (norte magnetico = 0)
18 | float q0, q1, q2, q3; // cuaternion
19 | unsigned long lastUpdate;

20 };

21
22 // Barometro (BMP280)
23 struct BaroData {
24 | float pressure_hPa;
25 | float temperature_C;
26 | float altitude_m; | // altitud barometrica MSL
27 | float vspeed_mps; | // velocidad vertical filtrada con EMA
28 | bool ok;

29 };

30
31 // GPS (NEO-6M)
32 struct GPSData {
33 | double lat;
34 | double lon;
35 | float altitude_m;
36 | float speed_kmh;
37 | float course_deg;
38 | uint8_t satellites;

39 | bool fix; | // posicion valida
40 | bool ok; | // UART recibiendo datos

41 };

42
43 // Radar (HLK-LD2410C)
44 struct RadarData {
45 | bool | presence;
46 | bool | movingDetected;
47 | uint16_t movingDist_cm;
48 | uint8_t movingEnergy;
49 | bool | stationaryDetected;
50 | uint16_t stationaryDist_cm;
51 | uint8_t stationaryEnergy;
52 | bool | ok;
53 | bool | platformStationary;
54 | uint16_t bestDist_cm;
55 | uint8_t maxEnergy;
56 | uint8_t proximityZone;
57 | bool | movingTargetAlert;

58 };

59
60 // Time-of-Flight (VL53L1X / TOF400C) 61 struct ToFData {
62 | uint16_t distance_mm;
63 | bool | valid;
64 | bool | ok;

65 };

66
67 // Paquete de telemetria ARINC 429 sobre NRF24L01

68 //
69 // El paquete ocupa 32 bytes (8 palabras x 32 bits = payload maximo del 70 // NRF24L01) y se envia a 20 Hz.
71 struct ARINC429Packet {
72 uint32_t words[8];

73 };

74
75 // Slot vacio: una palabra con label 0 y SSM = NO_DATA, asi el receptor
76 // la ignora limpiamente. Lo usa el planificador cuando no hay nada que
77 // mandar en un slot
78 #define A429_EMPTY_WORD | 0x20000000UL // SSM=01 (no data), todo cero

79
80 // Layout del campo discrete de la palabra de status (19 bits utiles)
81 #define A429_STATUS_SATS_MASK | 0x0000F
82 #define A429_STATUS_FIX | 0x00010

83 #define A429_STATUS_IMU_OK | 0x00020
84 #define A429_STATUS_BARO_OK | 0x00040
85 #define A429_STATUS_RADAR_OK | 0x00080
86 #define A429_STATUS_TOF_OK | 0x00100
87 #define A429_STATUS_RADAR_ZONE_SH 9
88 #define A429_STATUS_RADAR_ZONE_MASK 0x00600
89 #define A429_STATUS_RADAR_ALERT | 0x00800
90 #define A429_STATUS_PLAT_MOVING | 0x01000
91 #define A429_STATUS_SEQ_SH | 13
92 #define A429_STATUS_SEQ_MASK | 0x7E000

93
94 // Codificacion de la posicion GNSS en ARINC 429 BNR
95 // Valor de referencia para mejorar la medida
96 #define GPS_LAT_REF_DEG | 41.0 | // referencia de latitud
97 #define GPS_LON_REF_DEG | 1.0 | // referencia de longitud
98 #define A429_LSB_LATLON_DEG (1.0f / 262144.0f) | // ~3.81e-6 deg/LSB (~0.42
m)

99
100 #endif
Código 1.3: Estructuras de datos compartidas

1 // Calibration.ino - calibracion del bias del giroscopio al arranque.

2
3 // Bias del giroscopio
4 float gyroBiasX = 0, gyroBiasY = 0, gyroBiasZ = 0;

5
6 void calibrateGyro() {
7 | Serial.println("CAL: Calibrando gyro NO MOVER EL SENSOR...");
8 | neopixelWrite(PIN_LED_RGB, 30, 15, 0); // ambar mientras se calibra

9
10 | float sumX = 0, sumY = 0, sumZ = 0;
11 | float sumSqX = 0, sumSqY = 0, sumSqZ = 0;

12
13 | for (int i = 0; i < CALIBRATION_SAMPLES; i++) {
14 | float gx = readWord(MPU9250_ADDR, 0x43) / GYRO_SCALE;
15 | float gy = readWord(MPU9250_ADDR, 0x45) / GYRO_SCALE;
16 | float gz = readWord(MPU9250_ADDR, 0x47) / GYRO_SCALE;

17
18 | sumX += gx; sumY += gy; sumZ += gz;
19 | sumSqX += gx * gx;
20 | sumSqY += gy * gy;

sumSqZ += gz * gz;

delay(10);

}

float meanX = sumX / CALIBRATION_SAMPLES; float meanY = sumY / CALIBRATION_SAMPLES;
float meanZ = sumZ / CALIBRATION_SAMPLES;

// Varianza: Var = E[X^2] - E[X]^2
float varX = (sumSqX / CALIBRATION_SAMPLES) - (meanX * meanX); float varY = (sumSqY / CALIBRATION_SAMPLES) - (meanY * meanY); float varZ = (sumSqZ / CALIBRATION_SAMPLES) - (meanZ * meanZ); float maxVariance = max(varX, max(varY, varZ));

Serial.print("CAL: Varianza X="); Serial.print(varX, 4);
Serial.print(" Y="); Serial.print(varY, 4);
Serial.print(" Z="); Serial.print(varZ, 4);
Serial.print(" (umbral="); Serial.print(CALIBRATION_VARIANCE_THRESHOLD, 1); Serial.println(")");

if (maxVariance < CALIBRATION_VARIANCE_THRESHOLD) {
// Sensor en reposo durante toda la captura: la media es un bias fiable gyroBiasX = meanX;
gyroBiasY = meanY;
gyroBiasZ = meanZ;

Serial.print("CAL: [LIVE] Bias X="); Serial.print(gyroBiasX, 4); Serial.print(" Y="); Serial.print(gyroBiasY, 4);
Serial.print(" Z="); Serial.println(gyroBiasZ, 4);
} else {
// Movimiento detectado durante la calibracion. Como fallback se usan // valores tipicos obtenidos previamente en prueba controlada, y el // filtro mahony convergera al valor real mas rapido.
gyroBiasX = -0.2359;
gyroBiasY = 0.3017;
gyroBiasZ = -0.5030;
Serial.println("CAL: AVISO: movimiento detectado, usando bias por defecto") ;

}

Serial.println("CAL: Calibracion del gyro completada.");

62 }
Código 1.4: Calibración del bias del giroscopio

1 // IMU.ino - lectura cruda del MPU-9250 (accel + gyro) y del AK8963 (mag). 2 // La fusion a Euler/quaternion se hace en SensorFusion.ino.

3

4
5 // Ajuste de sensibilidad de fabrica (ASA) del magnetometro 6 float magCalX = 1.0f, magCalY = 1.0f, magCalZ = 1.0f;

7
8 // Helpers I2C
9 void writeRegister(byte addr, byte reg, byte val) {
10 | Wire.beginTransmission(addr);
11 | Wire.write(reg);
12 | Wire.write(val);
13 | Wire.endTransmission();

14 }

15
16 int16_t readWord(byte addr, byte reg) {
17 | Wire.beginTransmission(addr);
18 | Wire.write(reg);
19 | Wire.endTransmission(false);
20 | Wire.requestFrom(addr, (byte)2);
21 | uint8_t msb = Wire.read();
22 | uint8_t lsb = Wire.read();
23 | return (msb << 8) | lsb;

24 }

25
26 // Inicializacion
27 bool initIMU() {
28 | // Sale del modo sleep
29 | writeRegister(MPU9250_ADDR, 0x6B, 0x00);
30 | delay(100);

31
32 | // Comprueba WHO_AM_I - debe ser 0x71
33 | Wire.beginTransmission(MPU9250_ADDR);
34 | Wire.write(0x75);
35 | Wire.endTransmission(false);
36 | Wire.requestFrom(MPU9250_ADDR, (byte)1);
37 | byte whoAmI = Wire.read();

38

if (whoAmI != 0x71) {
Serial.print("IMU ERROR: WHO_AM_I = 0x"); Serial.println(whoAmI, HEX);
return false;

}

writeRegister(MPU9250_ADDR, 0x1C, 0x08); // Accel +/-4g writeRegister(MPU9250_ADDR, 0x1B, 0x08); // Gyro +/-500deg/s writeRegister(MPU9250_ADDR, 0x1A, 0x03); // DLPF ~42 Hz writeRegister(MPU9250_ADDR, 0x37, 0x02); // bypass I2C para poder hablar con el AK8963
delay(100);

// Comprueba la ID del magnetometro (WIA = 0x48) Wire.beginTransmission(AK8963_ADDR); Wire.write(0x00);
Wire.endTransmission(false); Wire.requestFrom(AK8963_ADDR, (byte)1); byte magId = Wire.read();

if (magId != 0x48) {
Serial.print("MAG ERROR: WIA = 0x"); Serial.println(magId, HEX);
return false;

}

// Lee el ASA desde la Fuse ROM del AK8963 para corregir la sensibilidad // de cada eje. Formula del datasheet MS1356-E-02 sec.8.3.11. writeRegister(AK8963_ADDR, 0x0A, 0x00); // power down
delay(10);
writeRegister(AK8963_ADDR, 0x0A, 0x0F); // modo Fuse ROM delay(10);

Wire.beginTransmission(AK8963_ADDR);
72 | Wire.write(0x10); | // registro ASAX
| Wire.endTransmission(false);
| Wire.requestFrom(AK8963_ADDR, (byte)3);
| uint8_t asaX = Wire.read();
| uint8_t asaY = Wire.read();
| uint8_t asaZ = Wire.read();

magCalX = ((float)(asaX - 128) / 256.0f) + 1.0f; magCalY = ((float)(asaY - 128) / 256.0f) + 1.0f;

magCalZ = ((float)(asaZ - 128) / 256.0f) + 1.0f;

Serial.print("MAG ASA: X="); Serial.print(asaX); Serial.print(" Y="); Serial.print(asaY); Serial.print(" Z="); Serial.println(asaZ); Serial.print("MAG Cal: X="); Serial.print(magCalX, 4); Serial.print(" Y="); Serial.print(magCalY, 4);
Serial.print(" Z="); Serial.println(magCalZ, 4);

writeRegister(AK8963_ADDR, 0x0A, 0x00); // power down otra vez para reconfigurar
delay(10);
writeRegister(AK8963_ADDR, 0x0A, 0x16); // 16-bit, continuo a 100 Hz delay(100);

Serial.println("IMU: MPU-9250 + AK8963 OK");

return true;

99 }

101 // Lectura de los 9 ejes
102 void readIMU(RawIMU &imu) {
// Burst de 14 bytes desde 0x3B: accel (6) + temp (2) + gyro (6) Wire.beginTransmission(MPU9250_ADDR);
Wire.write(0x3B);
Wire.endTransmission(false);
Wire.requestFrom(MPU9250_ADDR, (byte)14);

// MPU-9250 es big-endian (MSB primero, LSB despues) uint8_t msb, lsb;
msb = Wire.read(); lsb = Wire.read();
int16_t axRaw = (msb << 8) | lsb;
msb = Wire.read(); lsb = Wire.read();
int16_t ayRaw = (msb << 8) | lsb;
msb = Wire.read(); lsb = Wire.read();
int16_t azRaw = (msb << 8) | lsb;

// La temperatura queda entre accel y gyro. No se usa pero hay que // leerla igual porque va en el mismo paquete
msb = Wire.read(); lsb = Wire.read();
int16_t tempRaw = (msb << 8) | lsb;
(void)tempRaw;

msb = Wire.read(); lsb = Wire.read();

int16_t gxRaw = (msb << 8) | lsb;
msb = Wire.read(); lsb = Wire.read();
int16_t gyRaw = (msb << 8) | lsb;
msb = Wire.read(); lsb = Wire.read();
int16_t gzRaw = (msb << 8) | lsb;

imu.ax = axRaw / ACCEL_SCALE;
imu.ay = ayRaw / ACCEL_SCALE;
imu.az = azRaw / ACCEL_SCALE;

imu.gx = (gxRaw / GYRO_SCALE) - gyroBiasX;
imu.gy = (gyRaw / GYRO_SCALE) - gyroBiasY;
imu.gz = (gzRaw / GYRO_SCALE) - gyroBiasZ;

// AK8963: 7 bytes desde 0x03 (6 de datos + ST2). El ST2 hay que leerlo // siempre para que el mag prepare la siguiente muestra Wire.beginTransmission(AK8963_ADDR);
Wire.write(0x03);
Wire.endTransmission(false); Wire.requestFrom(AK8963_ADDR, (byte)7);

// El AK8963 es little-endian (LSB primero, MSB despues) uint8_t l, h;
l = Wire.read(); h = Wire.read();
int16_t mxRaw = l | (h << 8);
l = Wire.read(); h = Wire.read();
int16_t myRaw = l | (h << 8);
l = Wire.read(); h = Wire.read();
int16_t mzRaw = l | (h << 8);
uint8_t st2 = Wire.read(); // ST2, obligatorio leerlo (void)st2;

157 // Aplicacion correcciones
float mxUT = mxRaw * MAG_SCALE * magCalX;
float myUT = myRaw * MAG_SCALE * magCalY; float mzUT = mzRaw * MAG_SCALE * magCalZ;

imu.mx = (mxUT - MAG_OFFSET_X) * MAG_SCALE_X; imu.my = (myUT - MAG_OFFSET_Y) * MAG_SCALE_Y; imu.mz = (mzUT - MAG_OFFSET_Z) * MAG_SCALE_Z;

165 }
Código 1.5: Driver del MPU-9250 y AK8963

1 // Barometer.ino - driver del BMP280 (presion + temperatura + altitud MSL)

2
3 #include <Adafruit_BMP280.h>

4
5 Adafruit_BMP280 bmp;

6
7 // Estado para calcular la velocidad vertical por diferencias finitas 8 static float prevAltitude = 0.0f;
9 static unsigned long prevBaroTime = 0;

10
11 bool initBarometer() {
12 | if (!bmp.begin(BMP280_ADDR)) {
13 | Serial.println("BARO ERROR: BMP280 no encontrado en 0x76");
14 | Serial.println(" Revisar: VCC=3.3V, SDA=GPIO8, SCL=GPIO9, SDO=GND");
15 | return false;
16 | }

17
18 | // Configuracion para 10 Hz de lectura (BARO_INTERVAL_MS)
19 | // Parametros segun BMP280 datasheet Bosch BST-BMP280-DS001-19 sec.3.5.
20 | bmp.setSampling(
21 | Adafruit_BMP280::MODE_NORMAL,
22 | Adafruit_BMP280::SAMPLING_X2,
23 | Adafruit_BMP280::SAMPLING_X16,
24 | Adafruit_BMP280::FILTER_X16,
25 | Adafruit_BMP280::STANDBY_MS_63
26 | );

27
28 | // Base para el calculo de velocidad vertical
29 | prevAltitude = bmp.readAltitude(SEA_LEVEL_HPA);
30 | prevBaroTime = millis();

31
32 | Serial.println("BARO: BMP280 OK");
33 | Serial.print(" Altitud inicial: ");
34 | Serial.print(prevAltitude, 1);
35 | Serial.println(" m MSL");

36
37 return true;

38 }

39
40 void readBarometer(BaroData &baro) {
41 | baro.pressure_hPa = bmp.readPressure() / 100.0f; // Pa -> hPa
42 | baro.temperature_C = bmp.readTemperature();
43 | baro.altitude_m = bmp.readAltitude(SEA_LEVEL_HPA);

// Velocidad vertical por diferencia finita, suavizada con EMA. // El IIR interno del BMP280 reduce el ruido de presion pero queda // la discretizacion del LSB (~0.16 Pa). Sin el EMA el VSI se ve // saltar en pasos discretos al derivar.
unsigned long now = millis();
float dt = (now - prevBaroTime) / 1000.0f;

if (dt > 0.05f && dt < 2.0f) { // protege contra div/0 y dt anomalos float rawVS = (baro.altitude_m - prevAltitude) / dt; baro.vspeed_mps = baro.vspeed_mps * (1.0f - VSPEED_ALPHA)
+ rawVS * VSPEED_ALPHA;

}

prevAltitude = baro.altitude_m;
prevBaroTime = now;

60 }
Código 1.6: Driver del barómetro BMP280

1 // GPS.ino - driver del NEO-6M (UART1) con TinyGPSPlus

3 #include <TinyGPSPlus.h>

5 TinyGPSPlus gps;
6 HardwareSerial GPS_Serial(1); // UART1

8 void initGPS() {
GPS_Serial.begin(GPS_BAUD, SERIAL_8N1, GPS_RX_PIN, GPS_TX_PIN);

Serial.print("GPS: UART1 en RX=GPIO"); Serial.print(GPS_RX_PIN);
Serial.print(", TX=GPIO");
Serial.print(GPS_TX_PIN);
Serial.print(", Baud=");
Serial.println(GPS_BAUD);

// Chequeo rapido: esta llegando algo por el puerto? unsigned long start = millis();
bool dataReceived = false;
while (millis() - start < 1500) {
if (GPS_Serial.available()) {

dataReceived = true;
break;

}

}

if (dataReceived) {
Serial.println("GPS: NMEA detectada -- OK");
} else {
Serial.println("GPS: AVISO -- aun no llega NMEA (suele necesitar cielo abierto)");

}

34 }

36 // TinyGPSPlus necesita recibir los bytes en cuanto llegan. Esta funcion se 37 // llama cada iteracion del loop para que no se pierda nada en el buffer 38 // de la UART.
39 void feedGPS() {
while (GPS_Serial.available() > 0) {
gps.encode(GPS_Serial.read());

}

43 }

45 void readGPS(GPSData &data) {
feedGPS();

// "ok" = UART recibe datos (aunque no haya fix) data.ok = (gps.charsProcessed() > 10);

// Posicion
if (gps.location.isValid()) {
data.lat = gps.location.lat(); data.lon = gps.location.lng(); data.fix = true;
} else {
data.fix = false;

}

// Solo se actualiza el resto de campos si hay dato valido, asi los // ultimos valores conocidos se mantienen si hay algun problema
if (gps.altitude.isValid()) data.altitude_m = gps.altitude.meters();
63 | if (gps.speed.isValid()) | data.speed_kmh = gps.speed.kmph();
64 | if (gps.course.isValid()) | data.course_deg = gps.course.deg();
if (gps.satellites.isValid()) data.satellites = gps.satellites.value();

66 }
Código 1.7: Driver del GPS NEO-6M

1 // ToF.ino - driver del VL53L1X (TOF400C)

2
3 #include <VL53L1X.h>

4
5 VL53L1X tofSensor;

6
7 bool initToF() {
8 tofSensor.setTimeout(500);

9
10 | if (!tofSensor.init()) {
11 | Serial.println("TOF ERROR: VL53L1X no encontrado");
12 | Serial.println(" Revisar: VCC=3.3V, SDA=GPIO8, SCL=GPIO9, XSHUT en alto");
13 | return false;
14 | }

15
16 | tofSensor.setDistanceMode(VL53L1X::Long); | // hasta 4 m
17 | tofSensor.setMeasurementTimingBudget(TOF_TIMING_BUDGET_US);
18 | tofSensor.startContinuous(TOF_CONTINUOUS_MS);

19
20 | Serial.println("TOF: VL53L1X OK");
21 | return true;

22 }

23
24 // Lectura no bloqueante. Si no hay muestra nueva, no se toca data. 25 void readToF(ToFData &data) {
26 if (!data.ok) return;

27
28 if (!tofSensor.dataReady()) return;

29
30 uint16_t dist = tofSensor.read(false); // false = no bloquear

31
32 | if (tofSensor.timeoutOccurred()) {
33 | data.valid = false;
34 | return;
35 | }

36
37 | data.distance_mm = dist;
38 | data.valid = (dist >= TOF_DEAD_ZONE_MM);

39 }
Código 1.8: Driver del VL53L1X (Time-of-Flight)

1 // Radar.ino - driver del HLK-LD2410C (radar 24 GHz FMCW) en UART2.

3 #include <MyLD2410.h>

5 HardwareSerial RadarSerial(2); // UART2
6 MyLD2410 radar(RadarSerial);

8 // Suavizado EMA de la distancia
9 static float smoothedDist_cm = 0.0f;
10 static bool hasSmoothedDist = false;

12 bool initRadar() {
RadarSerial.begin(RADAR_BAUD, SERIAL_8N1, RADAR_RX_PIN, RADAR_TX_PIN);

Serial.print("RADAR: UART2 en RX=GPIO");
Serial.print(RADAR_RX_PIN);
Serial.print(", TX=GPIO");
Serial.print(RADAR_TX_PIN); Serial.print(", Baud=");
Serial.println(RADAR_BAUD);

if (!radar.begin()) {
Serial.println("RADAR: AVISO -- handshake LD2410C fallo"); Serial.println(" Se reintentara en check() desde el loop principal"); return false;

}

Serial.println("RADAR: LD2410C OK");

// Firmware
if (radar.requestFirmware()) { Serial.print(" Firmware: "); Serial.println(radar.getFirmware());

}

// Configuracion
// Las setters requieren el radar en modo configuracion. enhancedMode() // y resetParameters() lo gestionan ellos solos, pero

// setGateParameters() necesita configMode(true) explicito. if (!radar.configMode(true)) {
Serial.println(" AVISO: no se pudo entrar en modo config");

}

// Resolucion del gate
// Modo fino (20 cm/gate, 8 gates, max 1.8 m). La libreria usa // true = 0.20 m/gate, false = 0.75 m/gate (segun datasheet // LD2410C v1.05 sec.2.2). Para esta aplicacion el rango util // es el aterrizaje, donde 1.8 m es suficiente y la resolucion // fina es prioritaria sobre el alcance.
if (radar.requestResolution()) {
if (radar.getResolution() != RADAR_GATE_WIDTH_CM) { Serial.println(" Resolucion: cambiando a 20 cm/gate"); radar.setResolution(true); // true = 20 cm, false = 75 cm radar.requestReboot();
55 | delay(1500); | // espera al reboot del radar
| radar.begin();
| radar.configMode(true);
| } else {
Serial.print(" Resolucion: "); Serial.print(radar.getResolution()); Serial.println(" cm/gate (max 1.8 m)");

}

}

// Thresholds por gate ajustadas a downward-facing.
// Gates cercanos: thresholds ALTAS para no saturar con clutter del // chasis y vibracion. Gates lejanos: thresholds BAJAS para detectar // el suelo sin perderlo a mas distancia. radar.setGateParameters(0, RADAR_SENS_GATE_0, RADAR_SENS_GATE_0); radar.setGateParameters(1, RADAR_SENS_GATE_1, RADAR_SENS_GATE_1); radar.setGateParameters(2, RADAR_SENS_GATE_2, RADAR_SENS_GATE_2); radar.setGateParameters(3, RADAR_SENS_GATE_3, RADAR_SENS_GATE_3);
for (uint8_t g = 4; g <= 8; g++) {
radar.setGateParameters(g, RADAR_SENS_GATE_FAR, RADAR_SENS_GATE_FAR);

}
Serial.println(" Thresholds por gate: configuradas");
| radar.configMode(false);
| // Modo enhanced
| if (radar.enhancedMode(true)) {
Serial.println(" Modo enhanced: ON (per-gate signals disponibles)");

} else {
Serial.println(" Modo enhanced: OFF (solo basic mode)");

}

return true;

88 }

90 // Procesa los bytes que hayan llegado por UART. Llamar cada iteracion 91 // del loop para no perder paquetes
92 void feedRadar() {
radar.check();

94 }

96 // Lee datos y calcula las senales derivadas
97 // platformSpeed_kmh: velocidad GPS actual, necesaria para decidir si 98 // se puede confiar en la clasificacion movil/estacionario.
99 void readRadar(RadarData &data, float platformSpeed_kmh) { feedRadar();

// ok = el radar envia frames
data.ok = (radar.getFrameCount() > 0);
if (!data.ok) return;

// Datos del algoritmo interno del radar data.presence = (radar.getStatus() != 0);

if (radar.movingTargetDetected()) {
data.movingDetected = true;
data.movingDist_cm = (uint16_t)radar.movingTargetDistance(); data.movingEnergy = radar.movingTargetSignal();
} else {
data.movingDetected = false;
data.movingDist_cm = 0;
data.movingEnergy = 0;

}

if (radar.stationaryTargetDetected()) {
data.stationaryDetected = true;
data.stationaryDist_cm = (uint16_t)radar.stationaryTargetDistance(); data.stationaryEnergy = radar.stationaryTargetSignal();
} else {
data.stationaryDetected = false;
data.stationaryDist_cm = 0;
data.stationaryEnergy = 0;

}

// La clasificacion Doppler solo es fiable con la plataforma parada data.platformStationary = (platformSpeed_kmh < RADAR_HOVER_SPEED_KMH);

// Mejor estimacion de distancia
// Tomamos el target con mayor signal (el reflector dominante).
// Cuando el drone esta parado, lo normal es que el suelo sea
// stationary; cuando se mueve, el suelo aparece como moving por el // Doppler shift. Asi que mirar a ambos cubre los dos casos. uint16_t dist_cm = 0;
uint8_t energy = 0;
139 | bool | valid = false;

if (data.stationaryDetected && data.movingDetected) { // Los dos a la vez: gana el de mas energia
if (data.stationaryEnergy >= data.movingEnergy) { dist_cm = data.stationaryDist_cm;
energy = data.stationaryEnergy;
} else {
dist_cm = data.movingDist_cm; energy = data.movingEnergy;
| }
} else if (data.stationaryDetected) { dist_cm = data.stationaryDist_cm; energy = data.stationaryEnergy; } else if (data.movingDetected) { dist_cm = data.movingDist_cm;
energy = data.movingEnergy;
| }

// Filtro adicional sobre la energia: el algoritmo del chip ya rechaza // mucho ruido, pero a veces declara un target valido con signal bajo // (en torno a 20-30) que es solo eco residual. Con RADAR_NOISE_FLOOR // descartamos esos casos para que la salida sea estable.
valid = (dist_cm > 0) && (energy >= RADAR_NOISE_FLOOR);

if (valid) {
// Suavizado EMA. Reduce el flicker frame-a-frame que aparece // cuando el chip alterna entre dos gates adyacentes
if (!hasSmoothedDist) {
smoothedDist_cm = (float)dist_cm;
hasSmoothedDist = true;
} else {

smoothedDist_cm = smoothedDist_cm * (1.0f - RADAR_DIST_ALPHA) + (float)dist_cm * RADAR_DIST_ALPHA;

}
data.bestDist_cm = (uint16_t)(smoothedDist_cm + 0.5f); data.maxEnergy = energy;
} else {
// Sin target valido: se resetea el filtro para que el siguiente // eco arranque limpio
data.bestDist_cm = 0;
data.maxEnergy = 0;
hasSmoothedDist = false;

}

// Zona de proximidad en base a la distancia con histeresis implicita // por el suavizado EMA
data.proximityZone = RADAR_ZONE_NONE;
if (data.bestDist_cm > 0 && data.maxEnergy >= RADAR_ALERT_ENERGY_MIN) {
188 | if (data.bestDist_cm <= 60) | data.proximityZone = RADAR_ZONE_DANGER;
else if (data.bestDist_cm <= 120) data.proximityZone = RADAR_ZONE_CAUTION;
190 | else | data.proximityZone = RADAR_ZONE_CLEAR;

}

// Target movil en zona de aterrizaje. Solo se evalua con la
// plataforma parada; en movimiento la clasificacion Doppler del
// chip ve el suelo como "movil" y dispararia falsos positivos.
| data.movingTargetAlert = false;
if (data.platformStationary && data.movingDetected) {
if (data.movingDist_cm <= 120 && data.movingEnergy >=
| RADAR_ALERT_ENERGY_MIN) { data.movingTargetAlert = true; }

}

202 }
Código 1.9: Driver del radar HLK-LD2410C

1 // SensorFusion.ino - Filtro MARG de Mahony (9 ejes).

4 // Estado del filtro
5 static float q0 = 1.0f, q1 = 0.0f, q2 = 0.0f, q3 = 0.0f; | //
cuaternion

6 static float integralFBx = 0.0f, integralFBy = 0.0f, integralFBz = 0.0f; // acumulador Ki

8 void initFusion(FlightData &data) {
q0 = 1.0f; q1 = 0.0f; q2 = 0.0f; q3 = 0.0f;
integralFBx = 0.0f; integralFBy = 0.0f; integralFBz = 0.0f;

data.pitch = 0; data.roll = 0; data.heading = 0;
data.q0 = q0; data.q1 = q1; data.q2 = q2; data.q3 = q3; data.lastUpdate = micros();

Serial.println("FUSION: filtro Mahony MARG inicializado"); Serial.print("FUSION: Kp="); Serial.print(MAHONY_KP, 2);
Serial.print(" Ki="); Serial.println(MAHONY_KI, 2); Serial.print("FUSION: declinacion="); Serial.print(MAG_DECLINATION_DEG, 2); Serial.print(" body offset="); Serial.println(HEADING_BODY_OFFSET_DEG, 2);

21 }

23 static float invSqrt(float x) {
return 1.0f / sqrtf(x);

25 }

27 void updateFusion(RawIMU &imu, FlightData &data) { unsigned long now = micros();
float dt = (now - data.lastUpdate) / 1000000.0f;
data.lastUpdate = now;
// Proteccion: dt negativo (overflow) o enorme (sleep) -> se salta un ciclo if (dt <= 0.0f || dt > 0.5f) return;

// Gyro a rad/s
float gx = imu.gx * 0.0174533f;
float gy = imu.gy * 0.0174533f;
float gz = imu.gz * 0.0174533f;

// Remap del magnetometro al frame del MPU (accel/gyro).
// El AK8963 tiene los ejes orientados diferente respecto al accel/gyro // del MPU (los dos chips estan rotados internamente). Remap segun
// PS-MPU-9250A-01 sec.9.1, validado por la libreria de referencia
// de Kris Winer.
float mx = imu.my;
float my = imu.mx;
float mz = -imu.mz;

// Normaliza el accel float ax = imu.ax, ay = imu.ay, az = imu.az;
float recipNorm = invSqrt(ax * ax + ay * ay + az * az);
bool useAccel = (recipNorm < 10.0f); // si la norma es ~0 lo ignoramos if (useAccel) {
ax *= recipNorm;
ay *= recipNorm;
az *= recipNorm;

}

// Normaliza el mag. Si la norma no es logica (desconectado o saturado), // se ignora al mag en este ciclo y el filtro utiliza solo gyro+accel. bool useMag = true;
recipNorm = invSqrt(mx * mx + my * my + mz * mz);
if (recipNorm > 100.0f || recipNorm < 0.001f) {
useMag = false;
} else {
mx *= recipNorm;
my *= recipNorm;
mz *= recipNorm;

}

// Nucleo de Mahony

// Productos precalculados del cuaternion
float q0q0 = q0 * q0, q0q1 = q0 * q1, q0q2 = q0 * q2, q0q3 = q0 * q3; float q1q1 = q1 * q1, q1q2 = q1 * q2, q1q3 = q1 * q3;
float q2q2 = q2 * q2, q2q3 = q2 * q3;
float q3q3 = q3 * q3;

float ex = 0.0f, ey = 0.0f, ez = 0.0f; // error acumulado

// Correccion con el magnetometro
if (useMag) {
// Rota el mag medido al frame Earth
float hx = 2.0f * (mx * (0.5f - q2q2 - q3q3) + my * (q1q2 - q0q3) + mz * ( q1q3 + q0q2));
float hy = 2.0f * (mx * (q1q2 + q0q3) + my * (0.5f - q1q1 - q3q3) + mz * ( q2q3 - q0q1));
float hz = 2.0f * (mx * (q1q3 - q0q2) + my * (q2q3 + q0q1) + mz * (0.5f -q1q1 - q2q2));

// Referencia [bx, 0, bz]: se elimina la componente Y para que el
// heading no influya en el error, solo la inclinacion
float bx = sqrtf(hx * hx + hy * hy);

float bz = hz;

// Mag esperado en body frame: w = q* (x) [0,bx,0,bz] (x) q
float wx = 2.0f * (bx * (0.5f - q2q2 - q3q3) + bz * (q1q3 - q0q2)); float wy = 2.0f * (bx * (q1q2 - q0q3) + bz * (q0q1 + q2q3)); float wz = 2.0f * (bx * (q0q2 + q1q3) + bz * (0.5f - q1q1 - q2q2));

// Error = producto vectorial del mag medido vs esperado
ex += (my * wz - mz * wy);
ey += (mz * wx - mx * wz);
ez += (mx * wy - my * wx);

}

// Correccion con el accel
if (useAccel) {
// Direccion de la gravedad esperada en body frame (segun el cuaternion) float vx = 2.0f * (q1q3 - q0q2);
float vy = 2.0f * (q0q1 + q2q3);
float vz = q0q0 - q1q1 - q2q2 + q3q3;

// Error = producto vectorial gravedad medida vs esperada ex += (ay * vz - az * vy);
ey += (az * vx - ax * vz);
ez += (ax * vy - ay * vx);

}

// Controlador PI
// Ki integra el error y estima online el bias residual del gyro if (MAHONY_KI > 0.0f) {
integralFBx += MAHONY_KI * ex * dt;
integralFBy += MAHONY_KI * ey * dt;
integralFBz += MAHONY_KI * ez * dt; gx += integralFBx;
gy += integralFBy;
gz += integralFBz;

}

// Termino proporcional
gx += MAHONY_KP * ex;
gy += MAHONY_KP * ey;
gz += MAHONY_KP * ez;

// Integracion del cuaternion
// Se guarda el estado completo antes de integrar para no mezclar

// componentes ya actualizados con los que aun no lo estan. float qa = q0, qb = q1, qc = q2, qd = q3;

q0 += (-qb * gx - qc * gy - qd * gz) * (0.5f * dt);
q1 += ( qa * gx + qc * gz - qd * gy) * (0.5f * dt);
q2 += ( qa * gy - qb * gz + qd * gx) * (0.5f * dt);
q3 += ( qa * gz + qb * gy - qc * gx) * (0.5f * dt);

// Renormalizacion, evita que el cuaternion se aleje del manifold unitario recipNorm = invSqrt(q0 * q0 + q1 * q1 + q2 * q2 + q3 * q3);
q0 *= recipNorm; q1 *= recipNorm; q2 *= recipNorm; q3 *= recipNorm;

// Cuaternion -> angulos de Euler (convencion ZYX, frame MPU nativo) float sinPitch = 2.0f * (q0 * q2 - q3 * q1);
sinPitch = constrain(sinPitch, -1.0f, 1.0f); // evita NaN si hay ruido numerico

// Conversion a frame aeronautico NED (X forward, Y right, Z down).
// - Pitch (sobre Y): se niega
// - Roll (sobre X): no cambia
// - Yaw (sobre Z): se niega
data.pitch = -(asinf(sinPitch) * 57.2958f) - PITCH_MOUNT_OFFSET_DEG; data.roll = atan2f(2.0f * (q0 * q1 + q2 * q3),
1.0f - 2.0f * (q1 * q1 + q2 * q2)) * 57.2958f -ROLL_MOUNT_OFFSET_DEG;

float yaw = -(atan2f(2.0f * (q0 * q3 + q1 * q2),
1.0f - 2.0f * (q2 * q2 + q3 * q3)) * 57.2958f);

// Yaw [-180, +180] -> heading [0, 360], con dos correcciones: // 1. MAG_DECLINATION_DEG
// 2. HEADING_BODY_OFFSET_DEG
yaw += MAG_DECLINATION_DEG;
yaw += HEADING_BODY_OFFSET_DEG; if (yaw < 0.0f) yaw += 360.0f;
if (yaw >= 360.0f) yaw -= 360.0f;
data.heading = yaw;

data.q0 = q0; data.q1 = q1; data.q2 = q2; data.q3 = q3;

171 }

174 // Inicializa el cuaternion a partir de una sola muestra de accel + mag 175 // Sin este valor el filtro Mahony arranca con

176 // cuaternion identidad y necesita varios segundos para converger 177 void seedQuaternionFromIMU(RawIMU &imu) {
// Pitch/roll desde el accel asumiendo gravedad pura
float ax = imu.ax, ay = imu.ay, az = imu.az;
float roll = atan2f(ay, az);
float pitch = atan2f(-ax, sqrtf(ay*ay + az*az));

// Mismo remap del magnetometro que en updateFusion() float mx = imu.my;
float my = imu.mx;
float mz = -imu.mz;

// Heading compensado por inclinacion: proyecta el vector magnetico // al plano horizontal antes de extraer el angulo
float cr = cosf(roll), sr = sinf(roll);
float cp = cosf(pitch), sp = sinf(pitch);
float mxh = mx * cp + my * sr * sp + mz * cr * sp;
float myh = my * cr - mz * sr;
float yaw = atan2f(-myh, mxh); // signo segun la convencion NED del filtro

// Conversion Euler ZYX -> cuaternion
float cy = cosf(yaw * 0.5f), sy = sinf(yaw * 0.5f);
float cp2 = cosf(pitch * 0.5f), sp2 = sinf(pitch * 0.5f);
float cr2 = cosf(roll * 0.5f), sr2 = sinf(roll * 0.5f);

q0 = cr2*cp2*cy + sr2*sp2*sy;
q1 = sr2*cp2*cy - cr2*sp2*sy;
q2 = cr2*sp2*cy + sr2*cp2*sy;
q3 = cr2*cp2*sy - sr2*sp2*cy;

205 }
Código 1.10: Filtro Mahony MARG de 9 ejes

1 // Telemetry.ino - transmisor NRF24L01+PA+LNA con payload ARINC 429 y 2 // planificador de tasas por etiqueta.

4 #include <SPI.h>
5 #include <RF24.h>
6 #include <ARINC429.h>

8 RF24 radio(NRF_CE, NRF_CSN);
9 const byte addrTX[6] = NRF_ADDR_TX;

10
11 uint32_t txCount = 0;
12 uint32_t txFailCount = 0;
13 static uint8_t txSeqNumber = 0;

14
15 // Slots del planificador. Los slots 0-2 (pitch, roll, heading) son 16 // fijos y van en cada paquete (20 Hz). Los slots 3-7 multiplexan los 17 // parametros listados aqui segun su periodo nominal
18 enum SchedSlot {
19 | SCH_PRES_ALT = 0,
20 | SCH_VSPEED,
21 | SCH_RADAR_DIST,
22 | SCH_RADIO_ALT,
23 | SCH_GPS_ALT,
24 | SCH_LATITUDE,
25 | SCH_LONGITUDE,
26 | SCH_STATUS,
27 | SCH_COUNT

28 };

29
30 // Periodo nominal en ms entre dos transmisiones del mismo parametro 31 static const uint16_t schedPeriodMs[SCH_COUNT] = {
32 | 100, // PRES_ALT (10 Hz)
33 | 100, // VSPEED | (10 Hz)
34 | 100, // RADAR | (10 Hz)
35 | 100, // RADIO_ALT (10 Hz)
36 | 200, // GPS_ALT | (5 Hz)
37 | 200, // LATITUDE (5 Hz)
38 | 200, // LONGITUDE (5 Hz)
39 | 200, // STATUS | (5 Hz)

40 };

41
42 static unsigned long schedLastSent[SCH_COUNT] = {0};

43
44 bool initTelemetry() {
45 | SPI.begin(NRF_SCK, NRF_MISO, NRF_MOSI, -1);
46 | if (!radio.begin(&SPI)) {
47 | Serial.println("RADIO ERROR: NRF24L01 no detectado");
48 | return false;
49 | }

50
51 | radio.setPALevel(NRF_PA_LEVEL);
52 | radio.setDataRate(NRF_DATA_RATE);
53 | radio.setChannel(NRF_CHANNEL);

54 | radio.setRetries(NRF_RETRY_DELAY, NRF_RETRY_COUNT);
55 | radio.setPayloadSize(sizeof(ARINC429Packet));

56
57 | radio.openWritingPipe(addrTX);
58 | radio.stopListening();

59
60 | Serial.println("RADIO: NRF24L01+PA+LNA OK (payload ARINC 429)");
61 | Serial.print(" Canal: "); Serial.print(radio.getChannel());
62 | Serial.print(" Payload: "); Serial.print(sizeof(ARINC429Packet));
63 | Serial.print("B (8 palabras x 32 bits) Rate: ");
64 | Serial.print(TELEMETRY_RATE_HZ);
65 | Serial.println(" Hz");
66 | Serial.println(" Planificador:");
67 | Serial.println(" | pitch/roll/hdg=20Hz baro/radar/tof=10Hz");
68 | Serial.println(" | gps/status=5Hz");

69
70 return true;

71 }

72
73 // Construye el campo discrete del status word
74 static uint32_t buildStatusDiscrete(GPSData &gps, BaroData &baro, RadarData & radarData, ToFData &tofData, uint8_t seq) {
75 | uint32_t d = 0;
76 | uint8_t sats = (gps.satellites > 15) ? 15 : gps.satellites;
77 | d |= (sats & A429_STATUS_SATS_MASK);
78 | if (gps.fix) | d |= A429_STATUS_FIX;
79 | if (baro.ok) | d |= A429_STATUS_BARO_OK;
80 | if (radarData.ok) | d |= A429_STATUS_RADAR_OK;
81 | if (tofData.ok) | d |= A429_STATUS_TOF_OK;

82
83 d |= ((uint32_t)(radarData.proximityZone & 0x3) << A429_STATUS_RADAR_ZONE_SH) ;
84 | if (radarData.movingTargetAlert) | d |= A429_STATUS_RADAR_ALERT;
85 | if (!radarData.platformStationary) d |= A429_STATUS_PLAT_MOVING;

86
87 | d |= ((uint32_t)(seq & 0x3F) << A429_STATUS_SEQ_SH);
88 | return d;

89 }

90
91 // Construye la palabra ARINC 429 para un parametro multiplexado
92 static uint32_t buildScheduledWord(uint8_t schSlot, FlightData &flight, BaroData &baro, GPSData &gpsData, RadarData &radarData, ToFData &tofData, uint8_t seq) {
93 switch (schSlot) {

case SCH_PRES_ALT: {
uint8_t ssm = baro.ok ? A429_SSM_BNR_NORMAL : A429_SSM_BNR_NO_DATA; float altFt = baro.ok ? baro.altitude_m * 3.28084f : 0.0f;
return ARINC429::buildBNR(A429_LABEL_PRES_ALT, 0, altFt, A429_LSB_PRES_ALT_FT, ssm);

}
case SCH_VSPEED: {
uint8_t ssm = baro.ok ? A429_SSM_BNR_NORMAL : A429_SSM_BNR_NO_DATA; float vsFpm = baro.ok ? baro.vspeed_mps * 196.85f : 0.0f;
return ARINC429::buildBNR(A429_LABEL_VERT_SPEED, 0, vsFpm, A429_LSB_VSPEED_FPM, ssm);

}
case SCH_RADAR_DIST: {
uint8_t ssm = (radarData.ok && radarData.bestDist_cm > 0) ? A429_SSM_BNR_NORMAL : A429_SSM_BNR_NO_DATA;
float dist_m = radarData.bestDist_cm / 100.0f;
return ARINC429::buildBNR(A429_LABEL_RADAR_DIST, 0, dist_m, A429_LSB_RADAR_DIST_M, ssm);

}
case SCH_RADIO_ALT: {
uint8_t ssm = (tofData.ok && tofData.valid) ? A429_SSM_BNR_NORMAL : A429_SSM_BNR_NO_DATA;
float ft = tofData.distance_mm * 0.00328084f; // mm -> ft
return ARINC429::buildBNR(A429_LABEL_RADIO_ALT, 0, ft, A429_LSB_RADIO_ALT_FT, ssm);

}
case SCH_GPS_ALT: {
uint8_t ssm = gpsData.fix ? A429_SSM_BNR_NORMAL : A429_SSM_BNR_NO_DATA; float ft = gpsData.fix ? gpsData.altitude_m * 3.28084f : 0.0f;
return ARINC429::buildBNR(A429_LABEL_GPS_ALT, 0, ft, A429_LSB_GPS_ALT_FT, ssm);

}
case SCH_LATITUDE: {
uint8_t ssm = gpsData.fix ? A429_SSM_BNR_NORMAL : A429_SSM_BNR_NO_DATA; // Se transmite el desplazamiento respecto a la referencia local con
// LSB fino para tener resolucion metrica (ver SensorData.h)
float latOff = gpsData.fix ? (float)(gpsData.lat - GPS_LAT_REF_DEG) : 0.0 f;
return ARINC429::buildBNR(A429_LABEL_LATITUDE, 0, latOff, A429_LSB_LATLON_DEG, ssm);

}
case SCH_LONGITUDE: {
uint8_t ssm = gpsData.fix ? A429_SSM_BNR_NORMAL : A429_SSM_BNR_NO_DATA; float lonOff = gpsData.fix ? (float)(gpsData.lon - GPS_LON_REF_DEG) : 0.0

f;
return ARINC429::buildBNR(A429_LABEL_LONGITUDE, 0, lonOff, A429_LSB_LATLON_DEG, ssm);

}
case SCH_STATUS: {
uint32_t bits = buildStatusDiscrete(gpsData, baro, radarData, tofData, seq);
return ARINC429::buildDiscrete(A429_LABEL_STATUS, 0, bits, A429_SSM_BNR_NORMAL);

}
default:
return A429_EMPTY_WORD;

}

138 }

140 // Empaqueta el estado actual y lo transmite.
141 bool sendTelemetry(FlightData &flight, BaroData &baro, GPSData &gpsData, RadarData &radarData, ToFData &tofData) {
ARINC429Packet pkt;
unsigned long now = millis();

// Slots fijos 0-2: actitud a 20 Hz (cada paquete los lleva)
// Convertimos heading a rango [-180, +180] para que la codificacion // BNR signed sea simetrica.
float hdg = flight.heading;
if (hdg > 180.0f) hdg -= 360.0f;
pkt.words[0] = ARINC429::buildBNR(A429_LABEL_PITCH, 0, flight.pitch, A429_LSB_ANGLE_DEG, A429_SSM_BNR_NORMAL);
pkt.words[1] = ARINC429::buildBNR(A429_LABEL_ROLL, 0, flight.roll, A429_LSB_ANGLE_DEG, A429_SSM_BNR_NORMAL);
pkt.words[2] = ARINC429::buildBNR(A429_LABEL_HDG_MAG, 0, hdg, A429_LSB_ANGLE_DEG, A429_SSM_BNR_NORMAL);

// Slots multiplexados 3-7: planificador tipo "earliest deadline first". // Para cada parametro se calcula cuanto tarde llega respecto a su
// periodo nominal, en cada slot se elige el mas atrasado de entre
// los que ya tocaba enviar
long lateness[SCH_COUNT];
bool ready[SCH_COUNT];

for (uint8_t i = 0; i < SCH_COUNT; i++) {
long elapsed = (long)(now - schedLastSent[i]); lateness[i] = elapsed - schedPeriodMs[i]; ready[i] = (lateness[i] >= 0);

}

for (uint8_t slot = 3; slot < 8; slot++) { int8_t bestIdx = -1;
long bestLate = -1;
for (uint8_t i = 0; i < SCH_COUNT; i++) { if (ready[i] && lateness[i] > bestLate) { bestLate = lateness[i];
bestIdx = (int8_t)i;

}

}

if (bestIdx < 0) {
// SI ningun parametro tocaba todavia se rellena con palabra vacia // (label 0, SSM=NO_DATA) que el receptor ignora
pkt.words[slot] = A429_EMPTY_WORD;
} else {
// El status word se construye con el txSeqNumber actual
// El incremento se hace justo despues, solo cuando el slot elegido es el // status, asi el receptor detecta status words perdidos por el salto de // secuencia. El orden build-antes-de-incremento es lo que mantiene la // numeracion: el paquete lleva N, el siguiente status llevara N+1. pkt.words[slot] = buildScheduledWord((uint8_t)bestIdx, flight, baro, gpsData, radarData, tofData, txSeqNumber);
schedLastSent[bestIdx] = now;
ready[bestIdx] = false;
if (bestIdx == SCH_STATUS) txSeqNumber++;

}

}

bool success = radio.write(&pkt, sizeof(pkt)); txCount++;
if (!success) txFailCount++;
return success;

198 }
Código 1.11: Transmisor NRF24L01 con payload ARINC 429

1 // ARINC429.h - codificacion/decodificacion de palabras ARINC 429. 2 //
3 // Implementa la capa de palabra (formato, etiquetas, BNR, SSM, 4 // paridad) del estandar ARINC 429 / Mark 33 DITS. La capa fisica

5 // diferencial bipolar NO sera implementada. Las palabras son de
6 // 32 bits y se pueden enviar por el transporte que se quiera (NRF24, 7 // UART, SPI, transceiver real como HI-3593...).
8 //
9 // Formato de palabra (32 bits):
10 // bits 0-7 label (etiqueta, 8 bits, octal)
11 // bits 8-9 SDI (Source/Destination Identifier) 12 // bits 10-28 data (19 bits utiles)
13 // bits 29-30 SSM | (Sign/Status Matrix)
14 // bit 31 | parity (paridad impar)

15 //
16 // Uso basico:
17 // #include <ARINC429.h>

18 //
19 // uint32_t w = ARINC429::buildBNR(A429_LABEL_PITCH, 0, 30.0f,
20 // | A429_LSB_ANGLE_DEG,
21 // | A429_SSM_BNR_NORMAL);
22 // ...
23 // uint8_t label, ssm;
24 // bool valid;
25 // float pitch = ARINC429::parseBNR(w, A429_LSB_ANGLE_DEG,
26 // | label, ssm, valid);

27 //
28 // Referencias:
29 // ARINC Specification 429 Part 1-17 -- Functional Description, 30 // Electrical Interface, Label Assignments and Word Formats 31 // AIM "ARINC 429 Tutorial" v2.2, 2019 (BNR, SSM, parity)
32 // ARINC 429 Part 1, Attachment 2 -- tabla de parametros con sus 33 // escalas, ranges y tasas de refresco

34
35 #ifndef ARINC429_H
36 #define ARINC429_H

37
38 #include <Arduino.h>

39
40 // Etiquetas estandar (en octal). Lista parcial -- las que usa el TFG.
41 // La spec completa esta en ARINC 429 Part 1, Attachment 2.
42 #define A429_LABEL_PITCH | 0324 // Pitch Angle | - BNR +/-180 deg
43 #define A429_LABEL_ROLL | 0325 // Roll Angle | - BNR +/-180 deg
44 #define A429_LABEL_HDG_MAG | 0320 // Magnetic Heading - BNR +/-180 deg
45 #define A429_LABEL_PRES_ALT | 0204 // Pressure Altitude - BNR ft
46 #define A429_LABEL_VERT_SPEED | 0365 // Vertical Speed - BNR ft/min
47 #define A429_LABEL_LATITUDE | 0310 // Present Position Lat - BNR deg
48 #define A429_LABEL_LONGITUDE | 0311 // Present Position Lon - BNR deg

49 #define A429_LABEL_GPS_ALT | 0076 // GPS Altitude (MSL) - BNR ft
50 #define A429_LABEL_RADIO_ALT | 0164 // Radio Altitude - BNR ft
51 #define A429_LABEL_RADAR_DIST | 0166 // No estandar (libre). Distancia radar.
52 #define A429_LABEL_STATUS | 0270 // No estandar. Status discrete custom.

53
54 // SSM para BNR (bits 29-30)
55 #define A429_SSM_BNR_FAILURE | 0x0 // Failure Warning
56 #define A429_SSM_BNR_NO_DATA | 0x1 // No Computed Data
57 #define A429_SSM_BNR_TEST | 0x2 // Functional Test
58 #define A429_SSM_BNR_NORMAL | 0x3 // Normal Operation

59
60 // Escalas BNR (unidades por LSB).
61 // Calculadas como rango_completo / 2^18 para 18 bits utiles + 1 de signo.
62 #define A429_LSB_ANGLE_DEG | (180.0f / 262144.0f) // 6.866e-4 deg/LSB
63 #define A429_LSB_PRES_ALT_FT | 0.5f | // +/- 131072 ft
64 #define A429_LSB_GPS_ALT_FT | 0.5f | // igual que pres alt
65 #define A429_LSB_VSPEED_FPM | 0.125f | // +/- 32768 fpm
66 #define A429_LSB_RADIO_ALT_FT | 0.0625f | // +/- 16384 ft
67 #define A429_LSB_RADAR_DIST_M | 0.01f | // +/- 2621 m

68
69 // Palabra "vacia": label = 0, SSM = NO_DATA. Sirve como relleno de 70 // slots cuando el transmisor no tiene nada que mandar. El receptor la 71 // reconoce por label = 0 y la descarta.
72 #define A429_EMPTY_WORD | 0x20000000UL

73
74 // Constructor / parser de palabras ARINC 429
75 class ARINC429 {
76 public:
77 | // Construye una palabra BNR de 32 bits con paridad impar.
78 | static uint32_t buildBNR(uint8_t label, uint8_t sdi,
79 | float value, float lsb, uint8_t ssm);

80
81 | // Construye una palabra discrete (sin escala, 19 bits crudos).
82 | static uint32_t buildDiscrete(uint8_t label, uint8_t sdi,
83 | uint32_t data19, uint8_t ssm);

84
85 | // Decodifica una palabra BNR. valid = paridad OK y SSM = NORMAL.
86 | static float parseBNR(uint32_t word, float lsb,
87 | uint8_t &label_out, uint8_t &ssm_out, bool &valid);

88
89 | // Decodifica una palabra discrete.
90 | static uint32_t parseDiscrete(uint32_t word,
91 | uint8_t &label_out, uint8_t &ssm_out,
92 | bool &valid);

93
94 | // Comprueba paridad impar (32 bits).
95 | static bool checkParity(uint32_t word);

96
97 private:
98 | static uint32_t pack(uint8_t label, uint8_t sdi,
99 | uint32_t data19, uint8_t ssm);
100 | static uint8_t oddParityBit(uint32_t w);

101 };

102
103 #endif
Código 1.12: Biblioteca ARINC 429 (código propio): cabecera

1 // ARINC429.cpp - implementacion del builder/parser ARINC 429.

2
3 #include "ARINC429.h"

4
5 // Trunca un float al rango representable por un entero de 19 bits con 6 // signo (-2^18 .. 2^18 - 1) y devuelve la representacion en
7 // complemento a dos sobre 19 bits. Si esta fuera de rango se satura. 8 static uint32_t toData19Signed(long scaled) {
9 | if (scaled > 262143) scaled = 262143; // 2^18 - 1
10 | if (scaled < -262144) scaled = -262144; // -2^18
11 | return ((uint32_t)scaled) & 0x7FFFF; | // mascara 19 bits

12 }

13
14 uint32_t ARINC429::pack(uint8_t label, uint8_t sdi,
15 | uint32_t data19, uint8_t ssm) {
16 | uint32_t w = 0;
17 | w |= (uint32_t)label; | // bits 0-7
18 | w |= (uint32_t)(sdi & 0x03) << 8; | // bits 8-9
19 | w |= (uint32_t)(data19 & 0x7FFFF) << 10; // bits 10-28
20 | w |= (uint32_t)(ssm & 0x03) << 29; | // bits 29-30
21 | return w;

22 }

23
24 // Paridad impar sobre los 32 bits via XOR-fold + lookup en mascara 25 // 0x6996. El lookup (0x6996 >> nibble) & 1 devuelve 1
26 // si el popcount del valor original (antes del fold) es IMPAR. Asi
27 // que para un dato cuyos bits de paridad acumulada (despues del fold) 28 // dan 0 (popcount par), hay que devolver 1 para que el total sea impar.

29 uint8_t ARINC429::oddParityBit(uint32_t w) {
30 | uint32_t x = w;
31 | x ^= x >> 16;
32 | x ^= x >> 8;
33 | x ^= x >> 4;
34 | x &= 0xF;
35 | uint8_t inputIsOdd = (0x6996 >> x) & 1;
36 | // Si el dato ya tiene popcount impar, parity=0 deja el total impar.
37 | // Si el dato tiene popcount par, parity=1 lo hace impar.
38 | return (inputIsOdd == 1) ? 0 : 1;

39 }

40
41 uint32_t ARINC429::buildBNR(uint8_t label, uint8_t sdi,
42 | float value, float lsb, uint8_t ssm) {
43 | // Escala a LSBs y redondea al entero mas cercano
44 | long scaled = lroundf(value / lsb);
45 | uint32_t data19 = toData19Signed(scaled);

46
47 | uint32_t w = pack(label, sdi, data19, ssm);
48 | uint8_t parity = oddParityBit(w);
49 | return w | ((uint32_t)parity << 31);

50 }

51
52 uint32_t ARINC429::buildDiscrete(uint8_t label, uint8_t sdi,
53 | uint32_t data19, uint8_t ssm) {
54 | uint32_t w = pack(label, sdi, data19 & 0x7FFFF, ssm);
55 | uint8_t parity = oddParityBit(w);
56 | return w | ((uint32_t)parity << 31);

57 }

58
59 bool ARINC429::checkParity(uint32_t word) {
60 | // La palabra ya incluye su bit de paridad. Si la paridad es correcta,
61 | // el numero total de unos en los 32 bits sera impar (paridad impar).
62 | // El truco 0x6996 con xor-fold devuelve 1 si el popcount es IMPAR,
63 | // que es exactamente lo que queremos verificar.
64 | uint32_t x = word;
65 | x ^= x >> 16;
66 | x ^= x >> 8;
67 | x ^= x >> 4;
68 | x &= 0xF;
69 | uint8_t totalIsOdd = (0x6996 >> x) & 1;
70 | return totalIsOdd == 1;

71 }

72

73 float ARINC429::parseBNR(uint32_t word, float lsb,
74 | | uint8_t &label_out, uint8_t &ssm_out, bool &valid) {
75 | label_out = (uint8_t)(word & 0xFF);
76 | ssm_out = (uint8_t)((word >> 29) & 0x03);
77 | valid | = checkParity(word) && (ssm_out == A429_SSM_BNR_NORMAL);

78
79 | // Extrae los 19 bits del campo de datos como entero con signo
80 | uint32_t data19 = (word >> 10) & 0x7FFFF;
81 | // Sign-extend a 32 bits: si el bit 18 esta a 1 el numero es negativo
82 | int32_t signed19;
83 | if (data19 & 0x40000) {
84 | signed19 = (int32_t)(data19 | 0xFFF80000); // rellena con 1s
85 | } else {
86 | signed19 = (int32_t)data19;
87 | }
88 | return signed19 * lsb;

89 }

90
91 uint32_t ARINC429::parseDiscrete(uint32_t word,
92 | | uint8_t &label_out, uint8_t &ssm_out,
93 | | bool &valid) {
94 | label_out = (uint8_t)(word & 0xFF);
95 | ssm_out = (uint8_t)((word >> 29) & 0x03);
96 | valid | = checkParity(word) && (ssm_out == A429_SSM_BNR_NORMAL);
97 | return (word >> 10) & 0x7FFFF;

98 }
Código 1.13: Biblioteca ARINC 429 (código propio): implementación

1 // FlightInstruments_Receiver.ino - Receptor de telemetria y puente WiFi

2
3 #include <SPI.h>
4 #include <nRF24L01.h>
5 #include <RF24.h>
6 #include <ARINC429.h>
7 #include "SensorData.h"
8 #include <WiFi.h>
9 #include <WiFiUdp.h>

10
11 // SPI del NRF24L01 sobre el ESP32-C3 Super Mini 12 #define NRF_SCK 4
13 #define NRF_MISO 5

14 #define NRF_MOSI 6
15 #define CE_PIN | 3
16 #define CSN_PIN | 7

17
18 // Radio. El canal y data rate tienen que coincidir con el transmisor 19 #define NRF_CHANNEL 108
20 #define NRF_DATA_RATE RF24_250KBPS
21 #define NRF_PA_LEVEL RF24_PA_HIGH
22 const byte addressRX[6] = "SENSR";

23
24 // Punto de acceso WiFi del receptor, para uso en android
25 // El movil con la apk se conecta a esta red y escucha el UDP broadcast 26 const char *ssid = "FlightData_Network";
27 const char *password = "12345678";
28 WiFiUDP udp;
29 const int udpPort = 12345;
30 IPAddress broadcastIP(192, 168, 4, 255);

31
32 #define PRINT_RATE_HZ 20
33 #define PRINT_INTERVAL_MS (1000 / PRINT_RATE_HZ)

34
35 // Estado decodificado de la telemetria. Funciona como cache de
36 // hold-last-good: cada label refresca su campo cuando llega una palabra 37 struct DecodedState {
38 | float | pitch_deg;
39 | float | roll_deg;
40 | float | heading_deg;
41 | float | pres_alt_ft;
42 | float | vspeed_fpm;
43 | double lat_deg;
44 | double lon_deg;
45 | float | gps_alt_ft;
46 | float | radio_alt_ft;
47 | float | radar_dist_m;
48 | uint8_t satellites;
49 | uint8_t status_flags; | // byte de sensores OK que va en $TEL
50 | uint8_t radar_status; | // byte empaquetado: zona + alerta + plataforma
51 | uint8_t last_seq;

52 };

53
54 DecodedState st = {0};

55
56 // Bits del byte de status que va en el campo 10 del paquete $TEL. 57 #define STATUS_IMU_OK 0x01

58 #define STATUS_BARO_OK | 0x02
59 #define STATUS_GPS_FIX | 0x04
60 #define STATUS_RADIO_OK 0x08 61 #define STATUS_RADAR_OK 0x10 62 #define STATUS_TOF_OK 0x20

63
64 RF24 radio(CE_PIN, CSN_PIN); 65 ARINC429Packet rxPkt;

66
67 uint32_t rxCount = 0;
68 uint32_t lostCount = 0;
69 uint32_t statusRxCount = 0; // Se mantiene la inicialización aquí 70 int32_t lastSeqRx = -1;
71 unsigned long lastRxTime = 0;
72 unsigned long lastPrintTime = 0;
73 unsigned long lastStatsTime = 0;

74
75 void setup() {
76 | Serial.begin(115200);
77 | delay(2000);

78
79 Serial.println("Flight Instruments Receiver & WiFi Bridge");

80
81 | // WiFi en modo AP (Access Point)
82 | WiFi.softAP(ssid, password);
83 | udp.begin(udpPort);
84 | Serial.print("WiFi AP OK. IP: ");
85 | Serial.println(WiFi.softAPIP());

86
87 | // NRF24L01: si falla aqui no hay nada que recibir, asi que se bloquea
88 | // el arranque
89 | SPI.begin(NRF_SCK, NRF_MISO, NRF_MOSI, -1);
90 | if (!radio.begin(&SPI)) {
91 | Serial.println("Error NRF24L01");
92 | while (true) { delay(1000); }
93 | }

94
95 | radio.setPALevel(NRF_PA_LEVEL);
96 | radio.setDataRate(NRF_DATA_RATE);
97 | radio.setChannel(NRF_CHANNEL);
98 | radio.setPayloadSize(sizeof(ARINC429Packet));
99 | radio.openReadingPipe(1, addressRX);
100 | radio.startListening();

101

Serial.println("Escuchando telemetria...");

103 }

105 // Decodifica una palabra ARINC 429 y actualiza el campo correspondiente 106 // de DecodedState
107 static void processWord(uint32_t word) {
uint8_t label = (uint8_t)(word & 0xFF);
uint8_t ssm = (uint8_t)((word >> 29) & 0x03);

// Palabras vacias (label 0) y palabras corruptas se descartan if (label == 0) return;
if (!ARINC429::checkParity(word)) return;

bool dataOk = (ssm == A429_SSM_BNR_NORMAL);
uint8_t lblOut, ssmOut;
bool valid;

switch (label) {
case A429_LABEL_PITCH:
if (dataOk) st.pitch_deg = ARINC429::parseBNR(word, A429_LSB_ANGLE_DEG, lblOut, ssmOut, valid);
break;
case A429_LABEL_ROLL:
if (dataOk) st.roll_deg = ARINC429::parseBNR(word, A429_LSB_ANGLE_DEG, lblOut, ssmOut, valid);
break;
case A429_LABEL_HDG_MAG:
if (dataOk) {
// Heading codificado como signed [-180, +180]; el display espera [0, 360]
float h = ARINC429::parseBNR(word, A429_LSB_ANGLE_DEG, lblOut, ssmOut, valid);
if (h < 0.0f) h += 360.0f;
st.heading_deg = h;

}
break;
case A429_LABEL_PRES_ALT:
if (dataOk) st.pres_alt_ft = ARINC429::parseBNR(word, A429_LSB_PRES_ALT_FT, lblOut, ssmOut, valid);
break;
case A429_LABEL_VERT_SPEED:
if (dataOk) st.vspeed_fpm = ARINC429::parseBNR(word, A429_LSB_VSPEED_FPM, lblOut, ssmOut, valid);
break;

140 | case A429_LABEL_LATITUDE:
141 | if (dataOk) st.lat_deg = GPS_LAT_REF_DEG + ARINC429::parseBNR(word,
A429_LSB_LATLON_DEG, lblOut, ssmOut, valid);
142 | break;
143 | case A429_LABEL_LONGITUDE:
144 | if (dataOk) st.lon_deg = GPS_LON_REF_DEG + ARINC429::parseBNR(word,
A429_LSB_LATLON_DEG, lblOut, ssmOut, valid);
145 | break;
146 | case A429_LABEL_GPS_ALT:
147 | if (dataOk) st.gps_alt_ft = ARINC429::parseBNR(word, A429_LSB_GPS_ALT_FT,
lblOut, ssmOut, valid);
148 | break;
149 | case A429_LABEL_RADIO_ALT:
150 | // Reset explicito a 0 si no hay datos nuevos
151 | if (dataOk) st.radio_alt_ft = ARINC429::parseBNR(word,
A429_LSB_RADIO_ALT_FT, lblOut, ssmOut, valid);
152 | else | st.radio_alt_ft = 0;
153 | break;
154 | case A429_LABEL_RADAR_DIST:
155 | if (dataOk) st.radar_dist_m = ARINC429::parseBNR(word,
A429_LSB_RADAR_DIST_M, lblOut, ssmOut, valid);
156 | else | st.radar_dist_m = 0;
157 | break;
158 | case A429_LABEL_STATUS: {
159 | // Discrete: 19 bits utiles con flags, contador de satelites,
160 | // zona del radar, alerta y numero de secuencia.
161 | uint32_t bits = ARINC429::parseDiscrete(word, lblOut, ssmOut, valid);
162 | if (!valid) break;

163
164 statusRxCount++; // Incremento tras parseo válido

165
166 st.satellites = (uint8_t)(bits & A429_STATUS_SATS_MASK);

167
168 | // Traduce los bits del status word ARINC al layout del byte de
169 | // status del $TEL. IMU y RADIO se ponen incondicionalmente
170 | uint8_t flags = STATUS_IMU_OK | STATUS_RADIO_OK;
171 | if (bits & A429_STATUS_FIX) | flags |= STATUS_GPS_FIX;
172 | if (bits & A429_STATUS_BARO_OK) flags |= STATUS_BARO_OK;
173 | if (bits & A429_STATUS_RADAR_OK) flags |= STATUS_RADAR_OK;
174 | if (bits & A429_STATUS_TOF_OK) flags |= STATUS_TOF_OK;
175 | st.status_flags = flags;

176
177 | // Empaqueta zona del radar (bits 0-1), alerta de target movil
178 | // (bit 2) y plataforma en movimiento (bit 3) en un solo byte

// para el campo 14 del $TEL.
uint8_t a = (uint8_t)((bits & A429_STATUS_RADAR_ZONE_MASK) >> A429_STATUS_RADAR_ZONE_SH);
if (bits & A429_STATUS_RADAR_ALERT) a |= 0x04;
if (bits & A429_STATUS_PLAT_MOVING) a |= 0x08;
st.radar_status = a;

// Deteccion de perdidas por gap en el numero de secuencia. uint8_t curSeq = (uint8_t)((bits >> A429_STATUS_SEQ_SH) & 0x3F); if (lastSeqRx >= 0) {
uint8_t expected = (uint8_t)((lastSeqRx + 1) & 0x3F);
if (curSeq != expected) {
uint8_t gap = (uint8_t)((curSeq - expected) & 0x3F); if (gap < 32) lostCount += gap;

}

}
lastSeqRx = curSeq;
break;

}

}

198 }

200 void loop() {
unsigned long now = millis();

// Recepcion: cada paquete entra como 8 palabras ARINC y se procesan // todas, aunque alguna sea EMPTY_WORD
if (radio.available()) {
radio.read(&rxPkt, sizeof(rxPkt));
rxCount++;
lastRxTime = now;

for (uint8_t i = 0; i < 8; i++) { processWord(rxPkt.words[i]);

}

}

// Salida a 20 Hz: serializa el estado actual como sentencia CSV // "$TEL,..." que el display Processing parsea como entrada.
if (now - lastPrintTime >= PRINT_INTERVAL_MS) {
lastPrintTime = now;
if (rxCount > 0) {
// Conversiones de unidades para el display
221 | float alt_m | = st.pres_alt_ft / 3.28084f;

222 | float vs_mps | = st.vspeed_fpm / 196.85f;
float gps_alt_m = st.gps_alt_ft / 3.28084f;

String telPacket = "$TEL," +
| | String(st.pitch_deg, 1) + "," + String(st.roll_deg, 1) + "," + String(st.heading_deg, 1) + "," + String(alt_m, 1) + "," + String(vs_mps, 2) + "," + String(st.lat_deg, 6) + "," + String(st.lon_deg, 6) + "," + String((int)gps_alt_m) + "," + String(st.satellites) + "," + String(st.status_flags) + "," + String((int)(st.radar_dist_m * 100)) + "," + String((int)(st.radio_alt_ft * 304.8)) + ",0," + String(st.radar_status) + "*";

// Doble emision: serial USB para conexion local y UDP broadcast Serial.println(telPacket);

udp.beginPacket(broadcastIP, udpPort);
udp.print(telPacket);
udp.endPacket();

}

}

// Telemetria del enlace a 1 Hz
if (now - lastStatsTime >= 1000) {
static uint32_t prevRxCount = 0;
static uint32_t prevLostCount = 0;

uint32_t rxThisSec = rxCount - prevRxCount;
uint32_t lostThisSec = lostCount - prevLostCount;

// Nueva lógica de cálculo para porcentaje de pérdidas basándose en
| paquetes de status
uint32_t statusTotal = statusRxCount + lostCount;
float lossPercent = (statusTotal > 0) ? (lostCount * 100.0f / statusTotal)
| : 0.0f;

Serial.print("$STATS,");
Serial.print(rxThisSec); Serial.print(",");
Serial.print(lostThisSec); Serial.print(",");

264 | Serial.print(lossPercent, 1); Serial.print(",");
265 | Serial.print(rxCount);
266 | Serial.println("*");

267
268 | prevRxCount = rxCount;
269 | prevLostCount = lostCount;
270 | lastStatsTime = now;

271
272 | // Aviso de enlace caido: 3 s sin recibir nada
273 | if (lastRxTime > 0 && (now - lastRxTime > 3000)) {
274 | Serial.println("$WARN,LINK_LOST*");
275 | }
276 | }

277 }
Código 1.14: Receptor NRF24L01 y puente WiFi UDP (ESP32-C3)

# Capítulo 2

# ANEXO II. Código Processing

1 // Flight Instruments Display - archivo principal del PFD
2 // Lee la telemetria por puerto serie en formato "$TEL,...*" y pinta los 3 // instrumentos en layout Basic-T conforme a la guia FAA AC 25-11B. El 4 // archivo GPSMap.pde anade la vista de mapa, accesible con la tecla M

5
6 import processing.serial.*;

7
8 Serial myPort;

9
10 // Valores que se pintan en pantalla
11 float pitch = 0; | // grados (nariz arriba +)
12 float roll = 0; | // grados (ala derecha abajo +)
13 float heading = 0; | // 0-360 deg, magnetico
14 float slip = 0; | // deflexion de la bola de slip/skid
15 float altitude = 0; | // ft MSL
16 float verticalSpeed = 0; // ft/min
17 float groundSpeed = 0; // knots (desde GPS)

18
19 // Valores objetivo (ultimo paquete recibido) 20 float targetPitch = 0;
21 float targetRoll = 0;
22 float targetHeading = 0;
23 float targetAltitude = 0;
24 float targetVerticalSpeed = 0; 25 float targetGroundSpeed = 0; 26 float targetRadarDist = 0;
27 float targetTofDist = 0;
28 float radarDist = 0;
29 float tofDist = 0;

51

CAPÍTULO 2. ANEXO II. CÓDIGO PROCESSING | 52

30
31 // Referencias que ajusta el piloto
32 float targetHdgBug = 0; // heading bug (deg)
33 float baroSetting = 29.92; // inHg (ajuste Kollsman)

34
35 // Input
36 boolean keyLeft = false, keyRight = false;

37
38 // Flags y timers de UI
39 boolean showHelp = false;
40 long lastDataTime = 0;
41 boolean linkActive = false;

42
43 // Escalado
44 float baseWidth = 1280;
45 float baseHeight = 800;

46
47 // Timing
48 float dt = 1.0 / 60.0;

49
50 void settings() {
51 | size(1280, 800, P2D); // Engine cambiado para mejor render
52 | smooth(8);
53 | pixelDensity(1);

54 }

55
56 void setup() {
57 | surface.setResizable(true);
58 | frameRate(60);

59
60 initGPSMap();

61
62 // Apertura del puerto serie
63 | try {
64 | String portName = "COM6";

65
66 | myPort = new Serial(this, portName, 115200);
67 | myPort.bufferUntil('\n'); // dispara serialEvent() una vez por linea
68 | println("Escuchando telemetria en: " + portName);

69
70 | } catch (Exception e) {
71 | println(e.getMessage());
72 | println("Puertos disponibles:");
73 | for (String p : Serial.list()) {

CAPÍTULO 2. ANEXO II. CÓDIGO PROCESSING | 53

println("-" + p);

}

}

77 }

79 void draw() {
background(30);

dt = 1.0 / frameRate;
if (dt > 0.05) dt = 0.05;

// El enlace se considera perdido tras 2 s sin recibir paquetes if (millis() - lastDataTime > 2000) {
linkActive = false;

}

updateGPSData();

// gpsSpeed se actualiza en updateGPSData() a partir de la traza GPS targetGroundSpeed = gpsSpeed / 1.852; // km/h -> knots

// Heading bug
float hdgBugRate = 45; // deg/s cuando se mantiene la tecla
if (keyLeft) targetHdgBug -= hdgBugRate * dt;
if (keyRight) targetHdgBug += hdgBugRate * dt;
if (targetHdgBug < 0) targetHdgBug += 360;
if (targetHdgBug >= 360) targetHdgBug -= 360;

// Suavizado por interpolacion lineal
// El valor 0.4 un buen balance entre respuesta y suavidad // para la cadencia de 20 Hz del paquete.
if (linkActive) {
float smoothFactor = 0.4;
float diffpitch = targetPitch - pitch;
float diffroll = targetRoll - roll;

if (abs(diffpitch)>0.1){
pitch = lerp(pitch, targetPitch, smoothFactor);

}
if (abs(diffroll)>0.1){
roll = lerp(roll, targetRoll, smoothFactor);

}
altitude = lerp(altitude, targetAltitude, smoothFactor); verticalSpeed = lerp(verticalSpeed,targetVerticalSpeed,smoothFactor);

CAPÍTULO 2. ANEXO II. CÓDIGO PROCESSING | 54

radarDist = targetRadarDist;
tofDist = targetTofDist;
groundSpeed = lerp(groundSpeed, targetGroundSpeed, smoothFactor);

// El heading requiere aritmetica circular para no atravesar el rango // largo al cruzar la discontinuidad 0/360
float diff = targetHeading - heading;
if (diff > 180) diff -= 360;
if (diff < -180) diff += 360;
if (abs(diff) > 0.3) {
heading += diff * smoothFactor;

}
if (heading >= 360) heading -= 360; if (heading < 0) heading += 360;

}

// Escalado del canvas
float scaleFactor = height / baseHeight; pushMatrix();
scale(scaleFactor);

float virtualWidth = width / scaleFactor;
float centeringOffset = (virtualWidth - baseWidth) / 2; translate(centeringOffset, 0);

// Render
if (showMap) {
drawGPSMap();
} else {
float cx = baseWidth / 2;
float cy = baseHeight / 2 - 50;

// Basic-T
drawAttitudeIndicator(cx, cy, 400); drawGroundSpeedIndicator(cx - 250, cy, 80, 400); drawAltimeter(cx + 250, cy, 80, 400, altitude); drawVSI(cx + 330, cy, 50, 400); drawHeadingIndicator(cx, 630, 550, 50); drawProximityIndicator(cx + 345, 630, 110, 60);

drawStatusBar();
if (showHelp) drawHelpOverlay();

}

CAPÍTULO 2. ANEXO II. CÓDIGO PROCESSING | 55

popMatrix();

163 }

165 // Parser del paquete "$TEL,...*"
166 // Formato de 15 campos:
167 // $TEL,pitch,roll,hdg,alt,vspeed,lat,lon,gpsAlt,sats,flags,
168 // | radarDist,tofDist,radarEnergy,radarAlert*
169 void serialEvent(Serial p) {
try {
| String inString = p.readStringUntil('\n');
| if (inString != null) { inString = trim(inString);
| if (inString.startsWith("$TEL,")) {
| // Eliminacion del asterisco terminador if (inString.endsWith("*")) {

inString = inString.substring(0, inString.length() - 1);

}

| String[] data = split(inString, ',');
| if (data.length >= 15) {
// Se actualizan los valores objetivo, no los de display
| targetPitch = float(data[1]); targetRoll = float(data[2]); targetHeading = float(data[3]);
191 | targetAltitude = float(data[4]) * 3.28084; | // m -> ft
targetVerticalSpeed = float(data[5]) * 196.8504; // m/s -> ft/min

// targetGroundSpeed se calcula en draw() a partir de gpsSpeed

| gpsLat = float(data[6]); gpsLon = float(data[7]); gpsSats = int(data[9]); int statusFlags = int(data[10]); gpsFix = (statusFlags & 0x04) != 0;
| targetRadarDist = float(data[11]); targetTofDist = float(data[12]);
| linkActive = true;

CAPÍTULO 2. ANEXO II. CÓDIGO PROCESSING | 56

lastDataTime = millis();

}

}

}
} catch (Exception e) {
// Paquete corrupto: causado por posibles interferencias RF en el // enlace inalambrico o por bytes perdidos en el puerto USB println("Paquete corrupto, ignorado: " + e.getMessage());

}

215 }

217 // Teclado
218 void keyPressed() {
if (key == 'm' || key == 'M') {
showMap = !showMap;

}
// En vista de mapa, las teclas de zoom se gestionan en GPSMap.pde if (showMap) {
handleMapKeys();
return;

}
if (key == 'h' || key == 'H') showHelp = !showHelp;

// Ajuste de la presion de referencia del barometro
if (key == ']') baroSetting = constrain(baroSetting + 0.01, 28.00, 31.50); if (key == '[') baroSetting = constrain(baroSetting - 0.01, 28.00, 31.50);

if (key == CODED) {
if (keyCode == LEFT) keyLeft = true;
if (keyCode == RIGHT) keyRight = true;

}

237 }

239 void keyReleased() {
if (key == CODED) {
if (keyCode == LEFT) keyLeft = false; if (keyCode == RIGHT) keyRight = false;

}

244 }

246 // Barra de estado arriba a la izquierda 247 void drawStatusBar() {
float y = 18;
textSize(13);

CAPÍTULO 2. ANEXO II. CÓDIGO PROCESSING | 57
250 | textAlign(LEFT, BASELINE);

251
252 | if (linkActive) {
253 | fill(100, 255, 100);
254 | text("LIVE TELEMETRY (20Hz)", 15, y);
255 | } else {
256 | fill(255, 50, 50);
257 | text("NO DATA / LINK LOST", 15, y);
258 | }

259
260 | y += 18;
261 | fill(150);
262 | text("P:" + nf(pitch, 0, 1) + "\u00B0 R:" + nf(roll, 0, 1) + "\u00B0 H:" +
nf(heading, 0, 0) + "\u00B0", 15, y);
263 | y += 16;
264 | text("GS:" + int(groundSpeed) + "kt ALT:" + int(altitude) + "ft VS:" + int(
verticalSpeed) + "fpm", 15, y);
265 | y += 16;
266 | fill(130);
267 | text("BUG:" + nf(int(targetHdgBug), 3) + "\u00B0 BARO:" + nf(baroSetting, 2,
2), 15, y);

268 }

269
270 // Panel de ayuda arriba a la derecha 271 void drawHelpOverlay() {
272 | float ox = baseWidth - 260;
273 | float oy = 15;
274 | float lh = 16;

275
276 | float panelH = 130;
277 | fill(0, 160);
278 | noStroke();
279 | rectMode(CORNER);
280 | rect(ox - 10, oy - 5, 255, panelH, 6);

281
282 | fill(220);
283 | textSize(12);
284 | textAlign(LEFT, TOP);
285 | text("[ H ] | Muestra/oculta esta ayuda", ox, oy); oy += lh;
286 | text("[ M ] | Vista de mapa GPS", ox, oy); oy += lh;
287 | text("[ [ / ] ] | Baro -/+", ox, oy); oy += lh;
288 | text("[ \u2190 / \u2192 ] | Heading bug izq/der", ox, oy); oy += lh * 1.5;

289
290 fill(100, 255, 100);

CAPÍTULO 2. ANEXO II. CÓDIGO PROCESSING | 58

text("DATA STREAM", ox, oy); oy += lh;
fill(180);
text("Esperando paquetes NRF24L01...", ox, oy);

294 }
Código 2.1: Código principal del visualizador de vuelo (Flight Display)

1 // Altimetro (altitud MSL en pies)
2 // Cinta vertical analoga a la del ASI con su propia escala y una ventana
3 // Kohlsman (ajuste barometrico) debajo, controlada por las teclas [ y ].
4 // El rango visible esta reducido respecto al estandar aeronautico para
5 // adaptar el instrumento a la operacion en banco de pruebas (que se pueda ver movimiento)

7 void drawAltimeter(float centerX, float centerY, float tapeWidth, float tapeHeight, float altitude) {
float halfH = tapeHeight / 2;
float halfW = tapeWidth / 2;
10 | float rangeVisible = 100; | // ft visibles en la cinta
| float pxPerFt = tapeHeight / rangeVisible;
| // Fondo
| fill(40);
| stroke(80);
| strokeWeight(2);
| rectMode(CENTER);
rect(centerX, centerY, tapeWidth, tapeHeight);

// Marcas: cada 5 ft tick pequeno, cada 25 ft tick grande etiquetado float minAlt = altitude - (rangeVisible / 2) - 10;
float maxAlt = altitude + (rangeVisible / 2) + 10;
| int startTick = ceil(minAlt / 5.0) * 5;

for (int altVal = startTick; altVal <= maxAlt; altVal += 5) {
| float delta = altVal - altitude;
| float y = centerY - (delta * pxPerFt);

if (y < centerY - halfH + 2 || y > centerY + halfH - 2) continue;

| float xLeft = centerX - halfW;
float tickLen = (altVal % 25 == 0) ? 15 : 8;
float weight = (altVal % 25 == 0) ? 2 : 1;

CAPÍTULO 2. ANEXO II. CÓDIGO PROCESSING | 59

boolean showText = (altVal % 25 == 0);

stroke(255);
strokeWeight(weight);
line(xLeft, y, xLeft + tickLen, y);

if (showText) {
fill(255);
textAlign(LEFT, CENTER);
textSize(15);
text(str(altVal), xLeft + tickLen + 4, y - 1);

}

}

// Marca central (flecha apuntando a la izquierda) float boxW = 60;
float boxH = 16;
float boxX = centerX - halfW + 15;

fill(0);
stroke(255);
strokeWeight(2);
beginShape();
vertex(boxX, centerY - boxH); vertex(boxX + boxW, centerY - boxH); vertex(boxX + boxW, centerY + boxH);
vertex(boxX, centerY + boxH);
vertex(boxX, centerY + 6);
62 | vertex(boxX - 6, centerY); | // flecha hacia la izquierda
| vertex(boxX, centerY - 6);
| endShape(CLOSE);
| fill(0, 255, 0);
| textAlign(CENTER, CENTER);
| textSize(18);
text(int(altitude), boxX + boxW / 2, centerY - 1);
| // Etiqueta "ALT"
| fill(180);
| textAlign(CENTER, TOP);
| textSize(11);
text("ALT", centerX, centerY - halfH + 4);

// Ventana Kohlsman: muestra el ajuste barometrico actual en inHg.

CAPÍTULO 2. ANEXO II. CÓDIGO PROCESSING | 60

// Referencia estandar ISA: 29.92 inHg.
float baroY = centerY + halfH + 16;
fill(0);
stroke(80);
strokeWeight(1);
rectMode(CENTER);
rect(centerX, baroY, tapeWidth + 6, 22);

fill(0, 255, 255);
textAlign(CENTER, CENTER);
textSize(12);
text(nf(baroSetting, 2, 2) + " IN", centerX, baroY - 1);

rectMode(CORNER);
textAlign(LEFT);

93 }
Código 2.2: Código del indicador de altitud sobre el nivel del mar (Altimeter MSL)

1 // Indicador de actitud (horizonte artificial)
2 // El cielo y la tierra se pintan como dos rectangulos rotados segun
3 // los angulos pitch/roll del paquete de telemetria, sobre los que se
4 // superponen la escala de pitch y el arco de bank. Por encima se dibuja 5 // un rectangulo con un agujero circular que actua como mascara y solo 6 // deja visible la parte interior del instrumento

8 void drawAttitudeIndicator(float centerX, float centerY, float size) { float radius = size / 2;
float pixelsPerDegree = size / 45;
float pitchOffset = pitch * pixelsPerDegree;

pushMatrix();
translate(centerX, centerY);
rotate(radians(-roll));

// Cielo: gradiente de azul oscuro a azul claro en 8 franjas float coverage = size * 5;
int gradSteps = 8;
float stripH = (size * 3) / gradSteps;

for (int i = 0; i < gradSteps; i++) { float t = (float) i / (gradSteps - 1);

CAPÍTULO 2. ANEXO II. CÓDIGO PROCESSING | 61

fill(lerpColor(color(0, 40, 100), color(0, 140, 230), t));
noStroke();
rect(-coverage, -size * 3 + pitchOffset + i * stripH, coverage * 2, stripH + 1);

}

// Tierra: marron claro a marron oscuro
for (int i = 0; i < gradSteps; i++) {
float t = (float) i / (gradSteps - 1);
fill(lerpColor(color(130, 85, 40), color(45, 25, 8), t)); noStroke();
rect(-coverage, pitchOffset + i * stripH, coverage * 2, stripH + 1);

}

// Linea del horizonte
stroke(255);
strokeWeight(2);
line(-size, pitchOffset, size, pitchOffset);

// Escala de pitch: marcas cada 5deg, numeradas cada 10deg textAlign(CENTER, CENTER);
textSize(14);
int minDeg = floor((pitch - 30) / 5.0) * 5;
int maxDeg = ceil((pitch + 30) / 5.0) * 5;

for (int deg = minDeg; deg <= maxDeg; deg += 5) { if (deg == 0) continue;

float y = pitchOffset - (deg * pixelsPerDegree); float lineLength = (deg % 10 == 0) ? 60 : 30;

stroke(255);
strokeWeight(2);
line(-lineLength, y, lineLength, y);

if (deg % 10 == 0) {
fill(255);
noStroke();
text(abs(deg), -lineLength - 20, y); text(abs(deg), lineLength + 20, y);

}

}

popMatrix();

CAPÍTULO 2. ANEXO II. CÓDIGO PROCESSING | 62

// Arco de bank angle con marcas
float arcRadius = radius - 20;
stroke(255);
strokeWeight(2);
noFill();
arc(centerX, centerY, arcRadius * 2, arcRadius * 2, radians(-150), radians (-30));

int[] majorAngles = {30, 60};
int[] minorAngles = {10, 20, 45};

for (int angle : majorAngles) {
drawBankTick(centerX, centerY, arcRadius, angle, 15); drawBankTick(centerX, centerY, arcRadius, -angle, 15);

}
for (int angle : minorAngles) {
drawBankTick(centerX, centerY, arcRadius, angle, 8); drawBankTick(centerX, centerY, arcRadius, -angle, 8);

}
drawBankTick(centerX, centerY, arcRadius, 0, 15);

// Triangulo de referencia, fijo
fill(255);
noStroke();
float refY = centerY - arcRadius;
triangle(centerX - 8, refY - 12, centerX + 8, refY - 12, centerX, refY);

// Puntero de bank y bola de slip/skid
pushMatrix();
translate(centerX, centerY);
rotate(radians(-roll));

fill(255);
noStroke();
triangle(-8, -arcRadius + 12, 8, -arcRadius + 12, 0, -arcRadius);

// Bola de deslizamiento entre las dos referencias
float brickY = -radius + 40;
stroke(255);
strokeWeight(2);
line(-12, brickY - 6, -12, brickY + 6); line(12, brickY - 6, 12, brickY + 6);

CAPÍTULO 2. ANEXO II. CÓDIGO PROCESSING | 63

fill(255);
noStroke();
rectMode(CENTER);
rect(slip, brickY, 20, 8); rectMode(CORNER);

popMatrix();

// Simbolo del avion, fijo y centrado
stroke(255, 200, 0);
strokeWeight(3);
line(centerX - 80, centerY, centerX - 30, centerY); line(centerX + 30, centerY, centerX + 80, centerY); fill(255, 200, 0);
noStroke();
ellipse(centerX, centerY, 10, 10);

// Mascara circular: rectangulo grande con un agujero redondo // recortado. Todo lo pintado fuera del circulo queda tapado float maskExt = size * 5;
fill(30);
noStroke();
beginShape();
vertex(centerX - maskExt, centerY - maskExt); vertex(centerX + maskExt, centerY - maskExt); vertex(centerX + maskExt, centerY + maskExt);
vertex(centerX - maskExt, centerY + maskExt);
beginContour();
// Paso de 2deg: 180 vertices, resolucion suficiente para que el // contorno del circulo se vea suave sin penalizar el rendimiento
for (float a = 360; a >= 0; a -= 2) {
float angle = radians(a);
vertex(centerX + cos(angle) * radius, centerY + sin(angle) * radius);

}
endContour();
endShape(CLOSE);

// Bezel
stroke(80);
strokeWeight(4);
noFill();
ellipse(centerX, centerY, size, size);

152 }

CAPÍTULO 2. ANEXO II. CÓDIGO PROCESSING | 64

154 void drawBankTick(float cx, float cy, float radius, int angle, float length) {
155 | float screenAngle = radians(-90 - angle);
156 | float x1 = cx + cos(screenAngle) * radius;
157 | float y1 = cy + sin(screenAngle) * radius;
158 | float x2 = cx + cos(screenAngle) * (radius - length);
159 | float y2 = cy + sin(screenAngle) * (radius - length);

160
161 | stroke(255);
162 | strokeWeight(2);
163 | line(x1, y1, x2, y2);

164 }
Código 2.3: Código del indicador de actitud / horizonte artificial (Attitude Indicator)

1 // Vista de mapa GPS - tiles topograficos del ICGC descargados en disco
2 //
3 // Referencias:
4 // ICGC Base Map Service (capa topografica).
5 // | Licencia: CC-BY (Cataluna) / ODbL (resto del mundo).
6 // | https://www.icgc.cat/en/Geoinformation-and-Maps/Base-Map-Service
7 // OpenStreetMap Wiki - "Slippy map tilenames"
8 // FAA HF-STD-001B sec.5.6.3.2 - guia de map displays
9 // FAA AC 25-11B sec.6.2.5 - ubicacion de "other information"

10
11 import java.util.HashMap;
12 import java.io.File;

13
14 // Datos GPS
15 float gpsLat = 0;
16 float gpsLon = 0;
17 float gpsSpeed = 0;
18 int gpsSats = 0;
19 boolean gpsFix = false;

20
21 // Traza
22 // Los puntos son float[2] {lat, lon}. Un null en la lista marca un "hueco"
23 // para que drawMapTrail no una con una linea recta dos posiciones separadas en
| el tiempo
24 ArrayList<float[]> gpsTrail;
25 int maxTrailPoints = 2000;
26 long lastTrailTime = 0;
27 int trailIntervalMs = 500;

CAPÍTULO 2. ANEXO II. CÓDIGO PROCESSING | 65

28 boolean lastFixState = false; // para detectar transicion fix->sin fix

29
30 // Estado del mapa
31 boolean showMap = false;
32 int mapZoom = 15; | // zoom entero Web Mercator
33 final int MAP_ZOOM_MIN = 8;
34 final int MAP_ZOOM_MAX = 17;
35 boolean mapCenterLocked = true; // true = el mapa sigue al avion 36 float mapCenterLat;
37 float mapCenterLon;

38
39 // Vista por defecto cuando aun no hay fix. 40 // Si despues llega, el mapa se recentra solo 41 final float DEFAULT_MAP_LAT = 41.5638;
42 final float DEFAULT_MAP_LON = 2.0222;

43
44 // Cache de tiles
45 HashMap<String, PImage> tileCache;
46 final int CACHE_MAX_SIZE = 300;

47
48 // Colores (paleta para mapa topografico claro)
49 final color MAP_FALLBACK_BG = color(240, 238, 232); 50 final color MAP_FALLBACK_GRID = color(200, 198, 190);
51 final color MAP_TRAIL | = color(220, 30, 30);
52 final color MAP_TRAIL_OLD | = color(220, 150, 150);
53 final color MAP_AIRCRAFT | = color(0, 110, 220);
54 final color MAP_AIRCRAFT_LINE = color(255);
55 final color MAP_WARNING | = color(220, 140, 0);
56 final color MAP_PANEL_BG | = color(255, 220);
57 final color MAP_PANEL_TEXT | = color(30);
58 final color MAP_STRIP_BG | = color(30);
59 final color MAP_STRIP_LABEL = color(180);
60 final color MAP_STRIP_VALUE = color(230);

61
62 // Llamar desde setup()
63 void initGPSMap() {
64 | gpsTrail = new ArrayList<float[]>();
65 | tileCache = new HashMap<String, PImage>();
66 | mapCenterLat = DEFAULT_MAP_LAT;
67 | mapCenterLon = DEFAULT_MAP_LON;
68 | // Los tiles que falten se dibujan como celda gris

69 }

70
71 // Llamar desde draw() antes del render

CAPÍTULO 2. ANEXO II. CÓDIGO PROCESSING | 66

72 void updateGPSData() {
// Deteccion de la transicion fix -> sin fix. Cuando se pierde el fix
// se inserta un null en la traza para que, al recuperar la senal,
// drawMapTrail no una los dos extremos con una recta
if (lastFixState && !gpsFix && gpsTrail.size() > 0) {
// Solo se inserta el marcador si el ultimo punto no es null
if (gpsTrail.get(gpsTrail.size() - 1) != null) { gpsTrail.add(null);

}

}
lastFixState = gpsFix;

// Anade un punto a la traza cada trailIntervalMs solo si hay fix
if (gpsFix && millis() - lastTrailTime > trailIntervalMs) {
// Calculo de la velocidad sobre el suelo (GS) entre el ultimo punto
// valido y la nueva posicion, mediante proyeccion: dx = dLon*cos(lat), dy = dLat.

float[] lastPt = null;
long lastDt = 0;
for (int i = gpsTrail.size() - 1; i >= 0; i--) { if (gpsTrail.get(i) != null) {
lastPt = gpsTrail.get(i);
lastDt = millis() - lastTrailTime;
break;

}

}

if (lastPt != null && lastDt > 0 && lastDt < 3000) {
float dLat = gpsLat - lastPt[0];
float dLon = (gpsLon - lastPt[1]) * cos(radians(gpsLat)); float dist_m = sqrt(dLat * dLat + dLon * dLon) * 111320.0;
float speed_ms = dist_m / (lastDt / 1000.0);
float speed_kmh = speed_ms * 3.6;

// Filtro EMA sobre la velocidad calculada para absorber el jitter // de la posicion GPS.
float alpha = 0.4;
gpsSpeed = gpsSpeed * (1 - alpha) + speed_kmh * alpha;

}

gpsTrail.add(new float[]{gpsLat, gpsLon});
if (gpsTrail.size() > maxTrailPoints) { gpsTrail.remove(0);

CAPÍTULO 2. ANEXO II. CÓDIGO PROCESSING | 67
115 | }
116 | lastTrailTime = millis();
117 | }

118
119 | // Sin fix, el GS decae suavemente hacia cero en lugar de quedarse
120 | // congelado en el ultimo valor calculado
121 | if (!gpsFix) {
122 | gpsSpeed *= 0.9;
123 | if (gpsSpeed < 0.1) gpsSpeed = 0;
124 | }

125
126 | // Auto-centrado del mapa sobre el avion mientras el lock este activo
127 | if (mapCenterLocked && gpsFix) {
128 | mapCenterLat = gpsLat;
129 | mapCenterLon = gpsLon;
130 | }

131 }

132
133 // Proyeccion Web Mercator

134
135 float lonToPixelX(float lon, int z) {
136 return (lon + 180.0) / 360.0 * 256.0 * pow(2, z);

137 }

138
139 float latToPixelY(float lat, int z) {
140 | float latRad = radians(lat);
141 | return (1 - log(tan(latRad) + 1.0 / cos(latRad)) / PI)
142 | / 2.0 * 256.0 * pow(2, z);

143 }

144
145 // Carga de tiles: lectura desde disco, con cache en RAM
146 // Devuelve null para tiles que no existen en disco (drawTiles pinta 147 // una celda gris en esos huecos). El null se cachea igual que un tile 148 // valido, asi no se llama a File.exists() en bucle
149 PImage getTile(int z, int x, int y) {
150 String key = z + "/" + x + "/" + y;

151
152 | if (tileCache.containsKey(key)) {
153 | return tileCache.get(key);
154 | }

155
156 | String relativeBasePath = "../../Maps/data/tiles/";
157 | String tilePath = relativeBasePath + z + "/" + x + "/" + y + ".png";
158 | String fullPath = sketchPath(tilePath);

CAPÍTULO 2. ANEXO II. CÓDIGO PROCESSING | 68

PImage img = null;

// El tile se valida antes de loadImage() para evitar mensajes de
// "can't find file" en la consola cuando la coordenada cae fuera del // set descargado.
File f = new File(fullPath);
if (f.exists()) {
img = loadImage(fullPath);
if (img != null && img.width == 0) img = null;

}

// Cache: cuando se llena, se vacia por completo. if (tileCache.size() > CACHE_MAX_SIZE) { tileCache.clear();

}

tileCache.put(key, img);
return img;

177 }

179 // Dibujo del mapa
180 void drawGPSMap() {
float mapX = 0;
float mapY = 0;
float mapW = baseWidth;
float mapH = baseHeight - 60; // franja inferior para el status float mapCX = mapX + mapW / 2;
float mapCY = mapY + mapH / 2;

// Fondo, se ve por los huecos donde falten tiles fill(MAP_FALLBACK_BG);
noStroke();
rect(mapX, mapY, mapW, mapH);

drawTiles(mapCX, mapCY, mapW, mapH); drawMapTrail(mapCX, mapCY);

if (gpsFix) {
drawAircraftSymbol(mapCX, mapCY);

}

drawCompassRose(mapW - 60, 60); drawScaleBar(mapX + 20, mapH - 20); drawZoomIndicator(mapX + 15, mapY + 20);

CAPÍTULO 2. ANEXO II. CÓDIGO PROCESSING | 69

drawAttribution(mapW, mapH);

if (!gpsFix) {
drawNoFixWarning(mapCX, mapCY);

}

drawMapStatusStrip(mapX, mapH, mapW);

210 }

212 // Pinta la rejilla de tiles alrededor del centro del mapa
213 void drawTiles(float mapCX, float mapCY, float mapW, float mapH) { int z = mapZoom;

float centerPxX = lonToPixelX(mapCenterLon, z);
float centerPxY = latToPixelY(mapCenterLat, z);

int centerTileX = (int)(centerPxX / 256);
int centerTileY = (int)(centerPxY / 256);

int halfX = (int)ceil(mapW / 512.0) + 1; int halfY = (int)ceil(mapH / 512.0) + 1;

int maxTile = (int)pow(2, z);

imageMode(CORNER);
noTint();

for (int dy = -halfY; dy <= halfY; dy++) { for (int dx = -halfX; dx <= halfX; dx++) {
int tx = centerTileX + dx;
int ty = centerTileY + dy;

// Coordenadas fuera del mundo Mercator -> skip
if (tx < 0 || tx >= maxTile || ty < 0 || ty >= maxTile) continue;

float screenX = mapCX + (tx * 256 - centerPxX);
float screenY = mapCY + (ty * 256 - centerPxY);

PImage tile = getTile(z, tx, ty);
if (tile != null) {
image(tile, screenX, screenY, 256, 256);
} else {
fill(MAP_FALLBACK_BG);
stroke(MAP_FALLBACK_GRID);

CAPÍTULO 2. ANEXO II. CÓDIGO PROCESSING | 70

strokeWeight(0.5);
rect(screenX, screenY, 256, 256);

}

}

}

252 }

254 // Traza GPS como polilinea, con fade a rojo hacia el punto mas reciente. 255 // Los puntos null marcan huecos (fix perdido): la linea se corta ahi 256 // y se retoma cuando vuelve a haber datos.
257 void drawMapTrail(float mapCX, float mapCY) {
if (gpsTrail.size() < 2) return;

int z = mapZoom;
float centerPxX = lonToPixelX(mapCenterLon, z); float centerPxY = latToPixelY(mapCenterLat, z); int total = gpsTrail.size();

noFill();
strokeWeight(2.5);

for (int i = 1; i < total; i++) { float[] p0 = gpsTrail.get(i - 1); float[] p1 = gpsTrail.get(i);

if (p0 == null || p1 == null) continue;

float x0 = mapCX + (lonToPixelX(p0[1], z) - centerPxX); float y0 = mapCY + (latToPixelY(p0[0], z) - centerPxY); float x1 = mapCX + (lonToPixelX(p1[1], z) - centerPxX); float y1 = mapCY + (latToPixelY(p1[0], z) - centerPxY);

// age: 0 al principio de la traza, 1 al final
float age = map(i, 0, total - 1, 0, 1); stroke(lerpColor(MAP_TRAIL_OLD, MAP_TRAIL, age)); line(x0, y0, x1, y1);

}

284 }

286 // Triangulo del avion, rotado al heading actual 287 void drawAircraftSymbol(float cx, float cy) { pushMatrix();
translate(cx, cy);
rotate(radians(heading));

CAPÍTULO 2. ANEXO II. CÓDIGO PROCESSING | 71

stroke(MAP_AIRCRAFT, 160);
strokeWeight(2);
line(0, -18, 0, -42);

// Forma del avion
stroke(MAP_AIRCRAFT_LINE); strokeWeight(2);
fill(MAP_AIRCRAFT);
beginShape();
vertex(0, -14);
vertex(-9, 10);
vertex(0, 5);
vertex(9, 10);
endShape(CLOSE);

// Punto central
fill(MAP_AIRCRAFT_LINE);
noStroke();
ellipse(0, 0, 4, 4);

popMatrix();

313 }

315 // Rosa de los vientos arriba a la derecha 316 void drawCompassRose(float x, float y) { float r = 30;

fill(MAP_PANEL_BG);
stroke(80);
strokeWeight(1);
ellipse(x, y, r * 2, r * 2);

textSize(11);
textAlign(CENTER, CENTER);

String[] labels = {"N", "E", "S", "W"}; for (int i = 0; i < 4; i++) {
float angle = i * HALF_PI - HALF_PI;
float tx = x + cos(angle) * (r - 10);
float ty = y + sin(angle) * (r - 10);
fill(i == 0 ? color(200, 30, 30) : color(60)); // N en rojo noStroke();
text(labels[i], tx, ty);

CAPÍTULO 2. ANEXO II. CÓDIGO PROCESSING | 72

}

// Aguja rotando con el heading
pushMatrix();
translate(x, y);
rotate(radians(heading));
stroke(MAP_AIRCRAFT);
strokeWeight(2);
line(0, 5, 0, -r + 8);
fill(MAP_AIRCRAFT);
noStroke();
triangle(0, -r + 5, -4, -r + 12, 4, -r + 12);
popMatrix();

348 }

350 // Barra de escala: dibuja la longitud equivalente en metros segun la
351 // resolucion real (m/px) de Web Mercator a la latitud actual.
352 void drawScaleBar(float x, float y) {
// Formula estandar Mercator: mpp = 40075016.686 * cos(lat) / (256 * 2^z) float mpp = 40075016.686 * cos(radians(mapCenterLat))
/ (256.0 * pow(2, mapZoom));

// Lista de distancias, se elige la que mejor se aproxima
// a ~150 px de longitud en pantalla
float[] niceDistances = {
10, 20, 50, 100, 200, 500, 1000, 2000, 5000, 10000

};

float targetPx = 150;
float bestDist = niceDistances[0];
float bestPx = bestDist / mpp;

for (float d : niceDistances) {
float px = d / mpp;
if (abs(px - targetPx) < abs(bestPx - targetPx)) { bestDist = d;
bestPx = px;

}

}

float barLen = bestDist / mpp;

// Fondo de la caja
fill(MAP_PANEL_BG);

CAPÍTULO 2. ANEXO II. CÓDIGO PROCESSING | 73
379 | noStroke();
380 | rect(x - 8, y - 22, barLen + 16, 32);

381
382 | // Linea con topes a los extremos
383 | stroke(30);
384 | strokeWeight(2);
385 | line(x, y, x + barLen, y);
386 | line(x, y - 5, x, y + 5);
387 | line(x + barLen, y - 5, x + barLen, y + 5);

388
389 | fill(MAP_PANEL_TEXT);
390 | noStroke();
391 | textSize(11);
392 | textAlign(CENTER, BOTTOM);
393 | String label;
394 | if (bestDist >= 1000) {
395 | label = nf(bestDist / 1000, 0, 1) + " km";
396 | } else {
397 | label = int(bestDist) + " m";
398 | }
399 | text(label, x + barLen / 2, y - 6);

400 }

401
402 // Indicador de zoom + recordatorio de teclas, arriba a la izquierda 403 void drawZoomIndicator(float x, float y) {
404 | fill(MAP_PANEL_BG);
405 | noStroke();
406 | rect(x - 5, y - 3, 235, 36);

407
408 | fill(MAP_PANEL_TEXT);
409 | textSize(12);
410 | textAlign(LEFT, TOP);
411 | text("ZOOM: " + mapZoom + " (" + MAP_ZOOM_MIN + "-" + MAP_ZOOM_MAX + ")",
412 | x, y);
413 | text("[+/-] Zoom [C] Centrar [M] PFD", x, y + 16);

414 }

415
416 // Atribucion
417 void drawAttribution(float mapW, float mapH) {
418 | textSize(10);
419 | textAlign(RIGHT, BOTTOM);
420 | String attrib = "\u00A9 ICGC \u00A9 OpenStreetMap contributors";
421 | float tw = textWidth(attrib);

422

CAPÍTULO 2. ANEXO II. CÓDIGO PROCESSING | 74
423 | fill(MAP_PANEL_BG);
424 | noStroke();
425 | rect(mapW - tw - 16, mapH - 20, tw + 12, 16);

426
427 | fill(MAP_PANEL_TEXT);
428 | text(attrib, mapW - 10, mapH - 6);

429 }

430
431 // Overlay parpadeante cuando no hay fix 432 void drawNoFixWarning(float cx, float cy) {
433 | if ((millis() / 500) % 2 == 0) { // 1 Hz
434 | fill(0, 150);
435 | noStroke();
436 | rectMode(CENTER);
437 | rect(cx, cy + 10, 320, 80);
438 | rectMode(CORNER);

439
440 | fill(MAP_WARNING);
441 | textSize(24);
442 | textAlign(CENTER, CENTER);
443 | text("NO GPS FIX", cx, cy);
444 | textSize(14);
445 | fill(255);
446 | text("Esperando satelites...", cx, cy + 30);
447 | }

448 }

449
450 // Franja inferior con datos
451 void drawMapStatusStrip(float x, float y, float w) { 452 float stripH = 60;

453
454 | fill(MAP_STRIP_BG);
455 | noStroke();
456 | rect(x, y, w, stripH);

457
458 textSize(13);

459
460 | float row1Y = y + 18;
461 | textAlign(LEFT, CENTER);

462
463 | fill(MAP_STRIP_LABEL);
464 | text("LAT", x + 15, row1Y);
465 | fill(MAP_STRIP_VALUE);
466 | text(nf(abs(gpsLat), 0, 5) + "\u00B0" + (gpsLat >= 0 ? "N" : "S"),

CAPÍTULO 2. ANEXO II. CÓDIGO PROCESSING | 75
467 | x + 45, row1Y);

468
469 | fill(MAP_STRIP_LABEL);
470 | text("LON", x + 200, row1Y);
471 | fill(MAP_STRIP_VALUE);
472 | text(nf(abs(gpsLon), 0, 5) + "\u00B0" + (gpsLon >= 0 ? "E" : "W"),
473 | x + 235, row1Y);

474
475 | fill(MAP_STRIP_LABEL);
476 | text("SATS", x + 430, row1Y);
477 | fill(gpsSats >= 4 ? MAP_STRIP_VALUE : MAP_WARNING); // <4 no hay solucion 3D
478 | text(str(gpsSats), x + 475, row1Y);

479
480 | // Semaforo de fix a la derecha
481 | fill(gpsFix ? color(50, 220, 50) : color(220, 50, 50));
482 | ellipse(x + w - 25, row1Y, 10, 10);
483 | fill(MAP_STRIP_LABEL);
484 | textAlign(RIGHT, CENTER);
485 | text(gpsFix ? "FIX" : "---", x + w - 35, row1Y);

486
487 | float row2Y = y + 42;
488 | textAlign(LEFT, CENTER);

489
490 | fill(MAP_STRIP_LABEL);
491 | text("HDG", x + 15, row2Y);
492 | fill(MAP_STRIP_VALUE);
493 | text(nf(int(heading), 3) + "\u00B0", x + 50, row2Y);

494
495 | fill(MAP_STRIP_LABEL);
496 | text("GS", x + 130, row2Y);
497 | fill(MAP_STRIP_VALUE);
498 | text(nf(gpsSpeed, 0, 1) + " km/h", x + 155, row2Y);

499
500 | fill(MAP_STRIP_LABEL);
501 | text("ALT", x + 290, row2Y);
502 | fill(MAP_STRIP_VALUE);
503 | text(int(altitude) + " ft", x + 325, row2Y);

504
505 | fill(MAP_STRIP_LABEL);
506 | text("TRK", x + 430, row2Y);
507 | fill(MAP_STRIP_VALUE);
508 | float track = getTrackAngle();
509 | text(nf(int(track), 3) + "\u00B0", x + 465, row2Y);

510

CAPÍTULO 2. ANEXO II. CÓDIGO PROCESSING | 76

// Contador de puntos de traza a la derecha
fill(150);
textAlign(RIGHT, CENTER);
text(gpsTrail.size() + " pts", x + w - 15, row2Y);

515 }

517 // Angulo de track calculado entre los dos ultimos puntos de la traza 518 float getTrackAngle() {
// Localiza los dos ultimos puntos no nulos consecutivos
float[] p1 = null;
float[] p0 = null;
for (int i = gpsTrail.size() - 1; i >= 0; i--) {
float[] pt = gpsTrail.get(i);
if (pt == null) {
// Si hay un hueco entre los dos ultimos, el track no es calculable if (p1 != null) return heading;
continue;

}
if (p1 == null) p1 = pt;
else { p0 = pt; break; }

}
if (p0 == null || p1 == null) return heading;

// Correccion de la longitud por latitud: a alta latitud un grado de // longitud equivale a menos metros que un grado de latitud.
float dLon = (p1[1] - p0[1]) * cos(radians(p1[0]));
float dLat = p1[0] - p0[0];

float track = degrees(atan2(dLon, dLat));
if (track < 0) track += 360;
return track;

542 }

544 // Llamado desde keyPressed() en FlightDisplay.pde cuando showMap == true 545 void handleMapKeys() {
if (key == '+' || key == '=') {
mapZoom = min(MAP_ZOOM_MAX, mapZoom + 1);
tileCache.clear(); // un cambio de zoom invalida los tiles cargados

}
if (key == '-' || key == '_') {
mapZoom = max(MAP_ZOOM_MIN, mapZoom - 1);
tileCache.clear();

}
if (key == 'c' || key == 'C') {

CAPÍTULO 2. ANEXO II. CÓDIGO PROCESSING | 77

mapCenterLocked = true;

}
if (key == 'x' || key == 'X') {
gpsTrail.clear();
println("Traza GPS borrada");

}

561 }
Código 2.4: Código de la representación del mapa y datos GPS (GPS Map)

1 // Indicador de ground speed (GS, knots) desde GPS
2 // Cinta vertical centrada en la velocidad actual. Marcas cada 5 kt,
3 // numeradas cada 10

5 void drawGroundSpeedIndicator(float centerX, float centerY, float tapeWidth, float tapeHeight) {
float halfH = tapeHeight / 2;
float halfW = tapeWidth / 2;
8 | float rangeVisible = 80; | // knots visibles en la cinta
| float pxPerKt = tapeHeight / rangeVisible;
| // Fondo
| fill(40);
| stroke(80);
| strokeWeight(2);
| rectMode(CENTER);
rect(centerX, centerY, tapeWidth, tapeHeight);
| // Marcas
float minSpd = groundSpeed - (rangeVisible / 2) - 10;
float maxSpd = groundSpeed + (rangeVisible / 2) + 10;
| int startTick = ceil(minSpd / 5.0) * 5;

for (int spdVal = startTick; spdVal <= maxSpd; spdVal += 5) {
if (spdVal < 0) continue; // no se dibujan velocidades negativas
| float delta = spdVal - groundSpeed;
| float y = centerY - (delta * pxPerKt);

if (y < centerY - halfH + 2 || y > centerY + halfH - 2) continue;

| float xRight = centerX + halfW;

CAPÍTULO 2. ANEXO II. CÓDIGO PROCESSING | 78
32 | boolean isMajor = (spdVal % 10 == 0);
33 | float tickLen = isMajor ? 12 : 6;
34 | float weight = isMajor ? 2 : 1;

35
36 | stroke(255);
37 | strokeWeight(weight);
38 | line(xRight, y, xRight - tickLen, y);

39
40 | if (isMajor && spdVal > 0) {
41 | fill(255);
42 | textAlign(RIGHT, CENTER);
43 | textSize(15);
44 | text(str(spdVal), xRight - tickLen - 4, y - 1);
45 | }
46 | }

47
48 | // Readout central
49 | // El triangulo en el lado derecho de la caja indica el valor actual
50 | float boxW = 55;
51 | float boxH = 16;
52 | float boxX = centerX + halfW - 5;

53
54 | fill(0);
55 | stroke(255);
56 | strokeWeight(2);
57 | beginShape();
58 | vertex(boxX - boxW, centerY - boxH);
59 | vertex(boxX, centerY - boxH);
60 | vertex(boxX, centerY - 6);
61 | vertex(boxX + 6, centerY);
62 | vertex(boxX, centerY + 6);
63 | vertex(boxX, centerY + boxH);
64 | vertex(boxX - boxW, centerY + boxH);
65 | endShape(CLOSE);

66
67 | fill(0, 255, 0);
68 | textAlign(CENTER, CENTER);
69 | textSize(18);
70 | text(int(groundSpeed), boxX - boxW / 2, centerY - 1);

71
72 | // Etiqueta arriba ("GS") y abajo ("KTS")
73 | fill(180);
74 | textAlign(CENTER, TOP);
75 | textSize(11);

CAPÍTULO 2. ANEXO II. CÓDIGO PROCESSING | 79

text("GS", centerX, centerY - halfH + 4);

fill(180);
textAlign(CENTER, BOTTOM);
textSize(11);
text("KTS", centerX, centerY + halfH - 4);

rectMode(CORNER);
textAlign(LEFT);

85 }
Código 2.5: Código del indicador de velocidad respecto al suelo (Ground Speed Indicator)

1 // Indicador de rumbo con heading bug
2 // Cinta horizontal centrada en el heading actual, con etiquetas cardinales 3 // (N/E/S/W), marcas cada 5deg, 10deg y 30deg, y un bug cyan ajustable por el 4 // piloto con las flechas izquierda/derecha

6 void drawHeadingIndicator(float centerX, float centerY, float tapeWidth, float tapeHeight) {
float halfW = tapeWidth / 2;
8 | float degreesVisible = 60; | // rango total visible en la cinta
float pxPerDeg = tapeWidth / degreesVisible;
| // Fondo
| fill(40);
| stroke(80);
| strokeWeight(2);
| rectMode(CENTER);
rect(centerX, centerY, tapeWidth, tapeHeight);
| // Heading bug
// Diferencia circular entre bug y heading float bugDelta = targetHdgBug - heading;
| if (bugDelta > 180) bugDelta -= 360;
| if (bugDelta < -180) bugDelta += 360;
float bugX = centerX + (bugDelta * pxPerDeg);

// El bug solo se dibuja si cae dentro de la cinta visible
if (bugX > centerX - halfW + 8 && bugX < centerX + halfW - 8) {
| fill(0, 255, 255);
| noStroke();

CAPÍTULO 2. ANEXO II. CÓDIGO PROCESSING | 80
29 | float bugTop = centerY - tapeHeight / 2;

30
31 | // Forma del bug: una pequena "U" invertida
32 | beginShape();
33 | vertex(bugX - 8, bugTop + 1);
34 | vertex(bugX - 8, bugTop + 13);
35 | vertex(bugX - 4, bugTop + 13);
36 | vertex(bugX - 4, bugTop + 5);
37 | vertex(bugX + 4, bugTop + 5);
38 | vertex(bugX + 4, bugTop + 13);
39 | vertex(bugX + 8, bugTop + 13);
40 | vertex(bugX + 8, bugTop + 1);
41 | endShape(CLOSE);
42 | }

43
44 | // Marcas
45 | float minDeg = heading - (degreesVisible / 2) - 5;
46 | float maxDeg = heading + (degreesVisible / 2) + 5;
47 | int startTick = ceil(minDeg / 5.0) * 5;

48
49 | for (int tickVal = startTick; tickVal <= maxDeg; tickVal += 5) {
50 | float delta = tickVal - heading;
51 | float x = centerX + (delta * pxPerDeg);

52
53 if (x < centerX - halfW + 2 || x > centerX + halfW - 2) continue;

54
55 | // Normaliza el valor a [0, 360)
56 | int displayDeg = tickVal % 360;
57 | if (displayDeg < 0) displayDeg += 360;

58
59 | float tickLen;
60 | float weight;
61 | boolean showText = false;
62 | int textSz = 16;

63
64 | // Marcas mayores cada 30deg: cardinales o numero grande
65 | if (displayDeg % 30 == 0) {
66 | tickLen = 25;
67 | weight = 3;
68 | showText = true;
69 | textSz = 20;
70 | } else if (displayDeg % 10 == 0) {
71 | tickLen = 15;
72 | weight = 2;

CAPÍTULO 2. ANEXO II. CÓDIGO PROCESSING | 81

showText = true;
textSz = 16;
} else {
tickLen = 8;
weight = 1;

}

stroke(255);
strokeWeight(weight);
float tickTop = centerY - tapeHeight / 2; line(x, tickTop, x, tickTop + tickLen);

if (showText) {
fill(255);
textAlign(CENTER, TOP);
textSize(textSz);

// Cardinales en las cuatro direcciones principales. El resto de // marcas mayores se etiquetan como numero/10 segun la convencion // aeronautica (090 deg se muestra como "9").
String label;
94 | if (displayDeg == 0) | label = "N";
else if (displayDeg == 90) label = "E"; else if (displayDeg == 180) label = "S"; else if (displayDeg == 270) label = "W"; else label = str(displayDeg / 10);

text(label, x, tickTop + tickLen + 3);

}

}

// Puntero fijo en el centro (triangulo amarillo apuntando hacia abajo)
| fill(255, 200, 0);
| noStroke();
triangle(centerX - 10, centerY - tapeHeight / 2 - 2,
centerX + 10, centerY - tapeHeight / 2 - 2, centerX, centerY - tapeHeight / 2 + 15);

// Readout numerico del heading actual
float boxY = centerY + tapeHeight / 2 + 20;
| fill(0);
| stroke(255);
| strokeWeight(2);
| rectMode(CENTER);

CAPÍTULO 2. ANEXO II. CÓDIGO PROCESSING | 82

rect(centerX, boxY, 64, 26);

fill(0, 255, 0);
textAlign(CENTER, CENTER); textSize(18);
float hdgDisplay = heading % 360;
if (hdgDisplay < 0) hdgDisplay += 360; text(nf(int(hdgDisplay), 3) + "\u00B0", centerX, boxY - 2);

// Valor del bug al lado
fill(0, 255, 255);
textAlign(LEFT, CENTER);
textSize(12);
text("HDG " + nf(int(targetHdgBug), 3), centerX + 40, boxY - 2);

rectMode(CORNER);
textAlign(LEFT);

134 }
Código 2.6: Código del indicador de rumbo (Heading Indicator)

1 // Indicador de proximidad al suelo
2 // Muestra la distancia mas cercana medida por los sensores y un codigo 3 // de color por umbrales. La medida del radar HLK-LD2410C se recibe pero
4 // queda fuera de la decision por falta de calidad en banco, el ToF
5 // VL53L1X es la unica fuente

7 void drawProximityIndicator(float centerX, float centerY, float boxWidth, float boxHeight) {
// Conversion a cm para tratar ambas medidas en la misma unidad
float tofDistCm = tofDist / 10.0;
float radarDistCm = radarDist;

// Seleccion de la distancia activa
// El radar queda excluido: sus medidas son poco fiables actualmente
// La variable se conserva por si en un futuro se reactiva su contribucion float currentDist = Float.MAX_VALUE;
String activeSensor = "NONE";

if (tofDistCm > 0 && tofDistCm < currentDist) {
currentDist = tofDistCm;
activeSensor = "LIDAR";

CAPÍTULO 2. ANEXO II. CÓDIGO PROCESSING | 83

}
// Rama del radar deshabilitada:
// if (radarDistCm > 0 && radarDistCm < currentDist) {
// currentDist = radarDistCm;
// activeSensor = "RADAR";
// }

// Caja de fondo con esquinas redondeadas fill(40);
stroke(80);
strokeWeight(2);
rectMode(CENTER);
rect(centerX, centerY, boxWidth, boxHeight, 8);

// Titulo
fill(180);
textAlign(CENTER, TOP);
textSize(12);
text("PROXIMITY", centerX, centerY - boxHeight / 2 + 4);

// Estados de salida: sin datos, fuera de rango o medida activa float safeDistanceThreshold = 500;

if (currentDist == Float.MAX_VALUE) {
// No hay lectura valida
fill(130);
textAlign(CENTER, CENTER);
textSize(18);
text("NO DATA", centerX, centerY);

} else if (currentDist > safeDistanceThreshold) { // Distancia por encima del umbral de seguridad fill(100, 255, 100);
textAlign(CENTER, CENTER);
textSize(22);
text("SAFE", centerX, centerY);

fill(130);
textSize(10);
text("OUT OF RANGE", centerX, centerY + 18);

} else {
// Medida valida en zona de aterrizaje: color segun umbral color alertColor;

CAPÍTULO 2. ANEXO II. CÓDIGO PROCESSING | 84

if (currentDist <= 50) {
alertColor = color(255, 50, 50); // rojo: < 50 cm
} else if (currentDist <= 150) {
alertColor = color(255, 200, 0); // amarillo: 50 - 150 cm } else {
alertColor = color(50, 255, 50); // verde: > 150 cm

}

fill(alertColor);
textAlign(CENTER, CENTER);
textSize(26);
text(int(currentDist) + " cm", centerX, centerY - 2);

// Etiqueta del sensor activo
fill(180);
textSize(11);
text(activeSensor, centerX, centerY + 20);

}

// Restaurar modos de dibujo por defecto rectMode(CORNER);
textAlign(LEFT);

87 }
Código 2.7: Código del indicador de proximidad (Proximity Indicator)

1 // Indicador de velocidad vertical (VSI)
2 // Fondo de escala reducido respecto al estandar aeronautico para adaptar
3 // el instrumento a la operacion en banco de pruebas

5 void drawVSI(float centerX, float centerY, float tapeWidth, float tapeHeight) { float halfH = tapeHeight / 2;
float halfW = tapeWidth / 2;

// Fondo de escala
float maxVS = 100;
float padding = 10; // Añade 10 píxeles de margen arriba y abajo float pxPerFPM = (halfH - padding) / maxVS;

// Fondo
fill(40);

CAPÍTULO 2. ANEXO II. CÓDIGO PROCESSING | 85

stroke(80);
strokeWeight(2);
rectMode(CENTER);
rect(centerX, centerY, tapeWidth, tapeHeight);

// Linea del cero
stroke(255);
strokeWeight(1.5);
line(centerX - halfW, centerY, centerX + halfW, centerY);

// Marcas cada 25 fpm, mayores cada 50
for (int vs = -100; vs <= 100; vs += 25) {
float y = centerY - (vs * pxPerFPM);
float xLeft = centerX - halfW;

boolean isMajor = (vs % 50 == 0); float tickLen = isMajor ? 10 : 6; float weight = isMajor ? 1.5 : 1;

stroke(255);
strokeWeight(weight);
line(xLeft, y, xLeft + tickLen, y);

// Solo se etiquetan las marcas mayores, excluyendo el cero if (isMajor && vs != 0) {
fill(255);
textAlign(CENTER, CENTER);
textSize(11);
text(str(abs(vs)), centerX + 12, y);

}

}

// Barra de tendencia (rellena desde 0 hasta el valor actual)
float clampedVS = constrain(verticalSpeed, -maxVS, maxVS);
float vsY = centerY - (clampedVS * pxPerFPM);

// Color de la barra en funcion de la magnitud (verde/amarillo/naranja) float absVS = abs(clampedVS);
int barR, barG, barB;
if (absVS < 50) {
barR = 0; barG = 200; barB = 0; } else if (absVS < 75) {
barR = 180; barG = 200; barB = 0; } else {

CAPÍTULO 2. ANEXO II. CÓDIGO PROCESSING | 86

barR = 255; barG = 180; barB = 0;

}

float barX = centerX - halfW + 2; float barW = tapeWidth - 16;

noStroke();
fill(barR, barG, barB, 130);

rectMode(CORNERS);
if (clampedVS > 0) {
rect(barX, vsY, barX + barW, centerY); } else if (clampedVS < 0) {
rect(barX, centerY, barX + barW, vsY);

}
rectMode(CORNER);

// Puntero (triangulo verde apuntando a la cinta desde la izquierda) fill(0, 255, 0);
noStroke();
float triX = centerX - halfW;
triangle(triX, vsY - 4, triX, vsY + 4, triX + 8, vsY);

// Readout numerico arriba del instrumento
float rdY = centerY - halfH - 14;
fill(0);
stroke(80);
strokeWeight(1);
rectMode(CENTER);
rect(centerX, rdY, tapeWidth + 2, 20);

fill(0, 255, 0);
textAlign(CENTER, CENTER);
textSize(12);

// Valor sin redondear a la decena, para ver variaciones pequenas int displayVS = round(verticalSpeed);
String vsText;
if (displayVS > 0) vsText = "+" + displayVS;
else vsText = str(displayVS);
text(vsText, centerX, rdY - 1);

// Etiqueta "VS"
fill(150);

CAPÍTULO 2. ANEXO II. CÓDIGO PROCESSING | 87
105 | textAlign(CENTER, BOTTOM);
106 | textSize(10);
107 | text("VS", centerX, rdY - 12);

108
109 | rectMode(CORNER);
110 | textAlign(LEFT);

111 }
Código 2.8: Código del indicador de velocidad vertical (VSI)

# Capítulo 3

# ANEXO III. Figuras de apoyo

A continuación de muestras las fotos de la comprobación de la actitud de la plataforma.

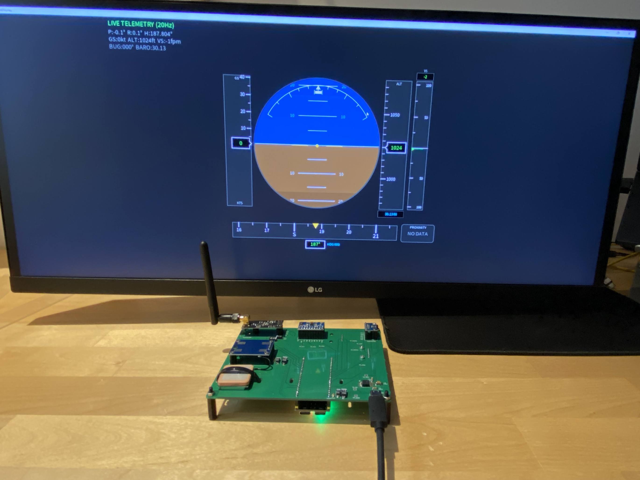
[picture p35: figure]

88

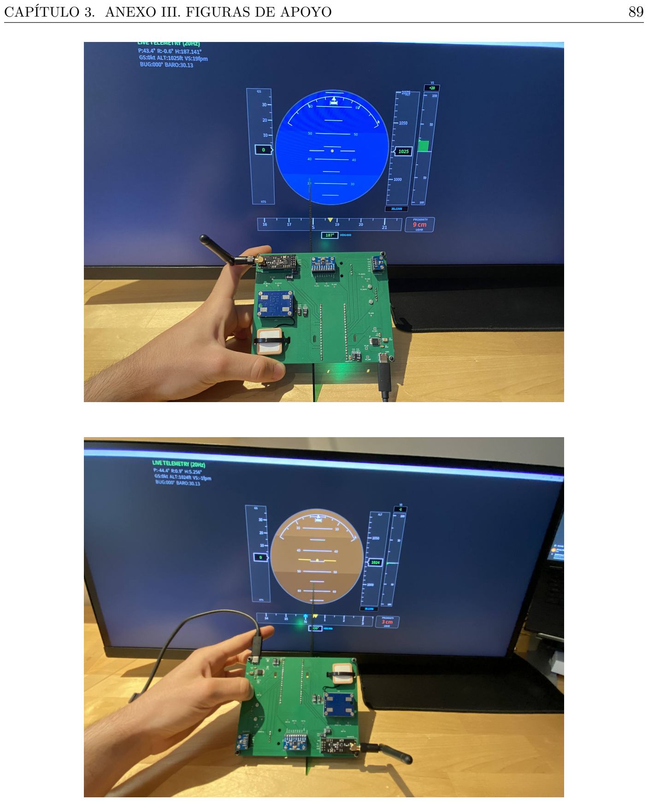
[picture p36: page 94]

CAPÍTULO 3. ANEXO III. FIGURAS DE APOYO | 89

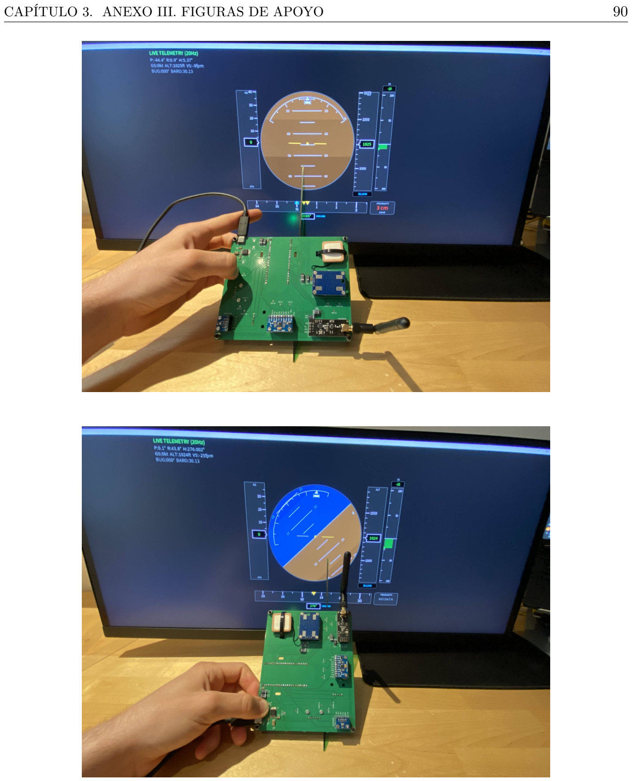
[picture p37: page 95]

CAPÍTULO 3. ANEXO III. FIGURAS DE APOYO | 90

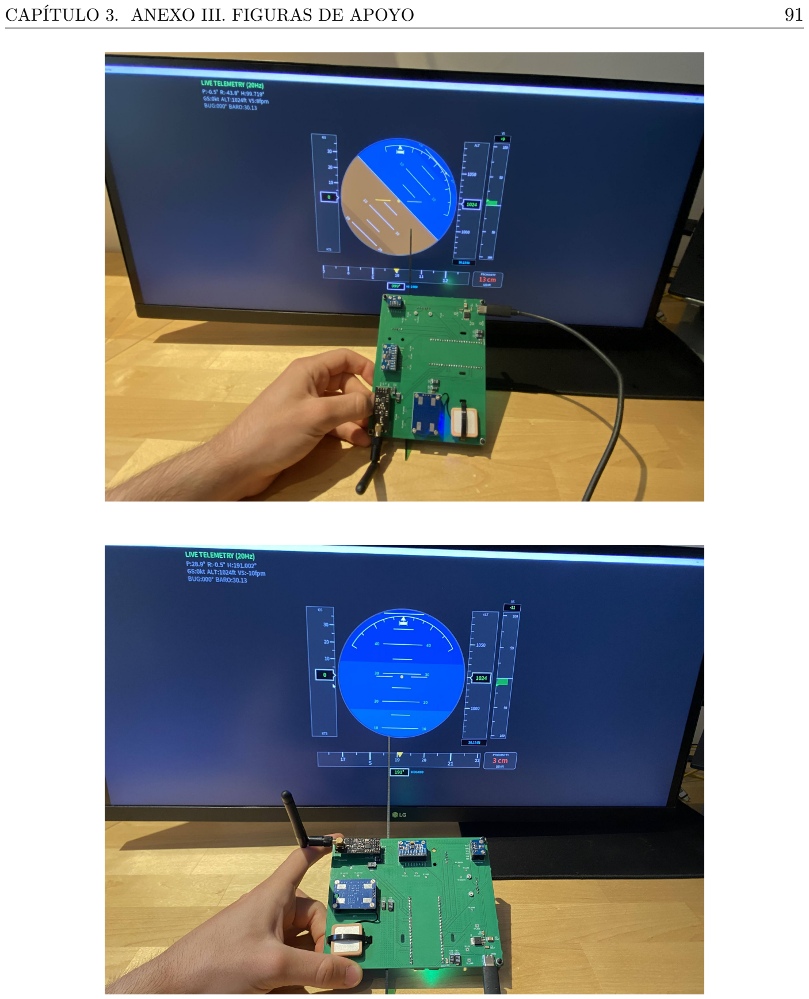
[picture p38: page 96]

CAPÍTULO 3. ANEXO III. FIGURAS DE APOYO | 91

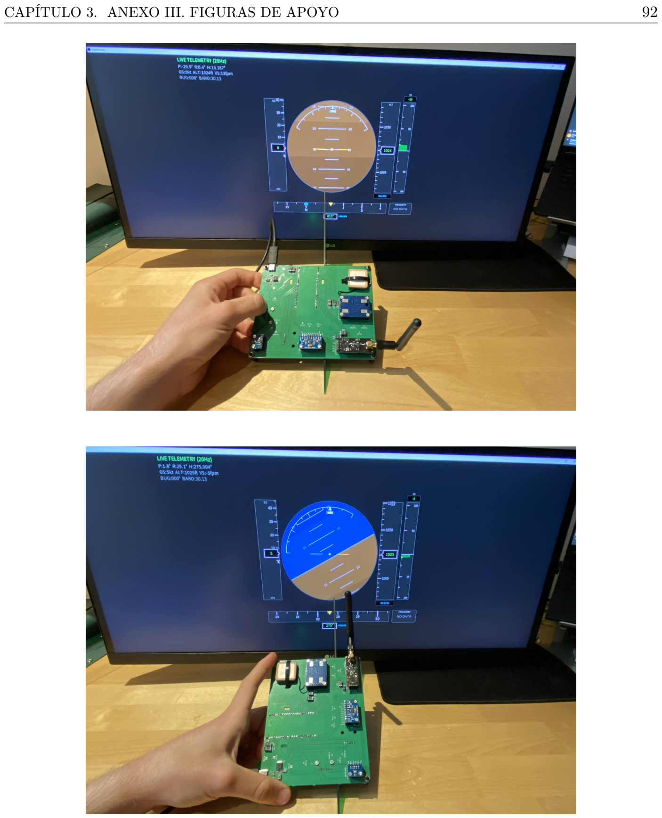
[picture p39: page 97]

CAPÍTULO 3. ANEXO III. FIGURAS DE APOYO | 92

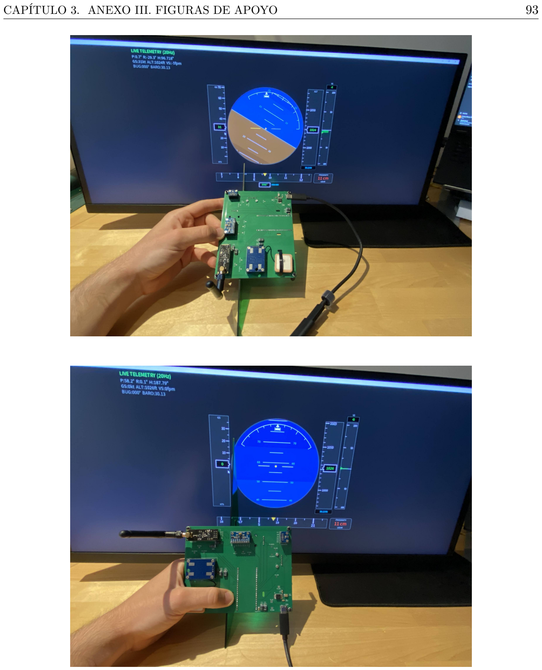
[picture p40: page 98]

CAPÍTULO 3. ANEXO III. FIGURAS DE APOYO | 93

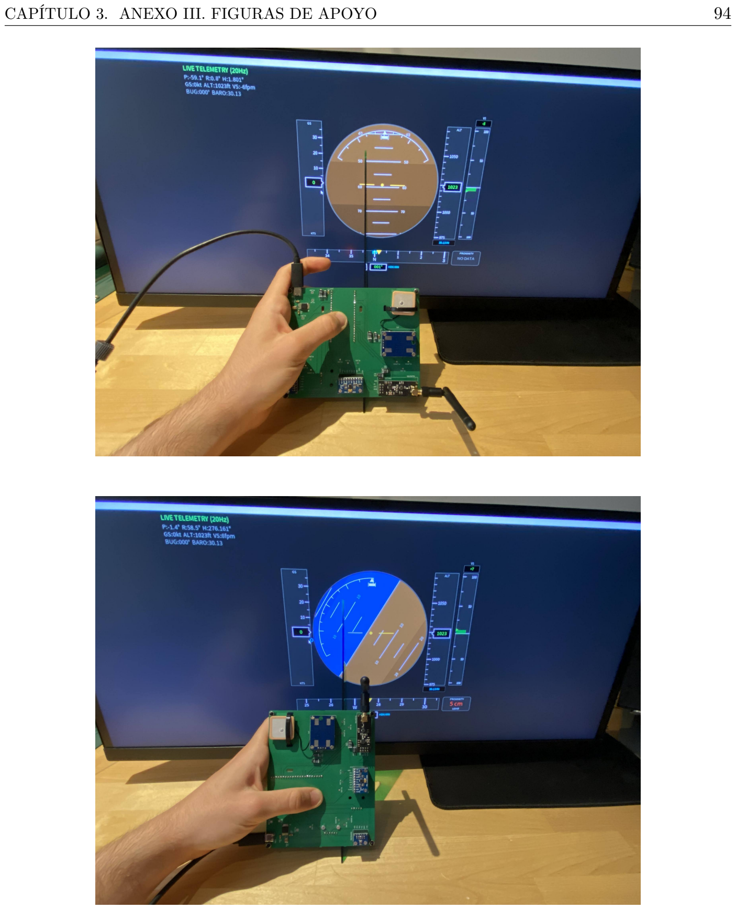
[picture p41: page 99]

CAPÍTULO 3. ANEXO III. FIGURAS DE APOYO | 94

CAPÍTULO 3. ANEXO III. FIGURAS DE APOYO | 95

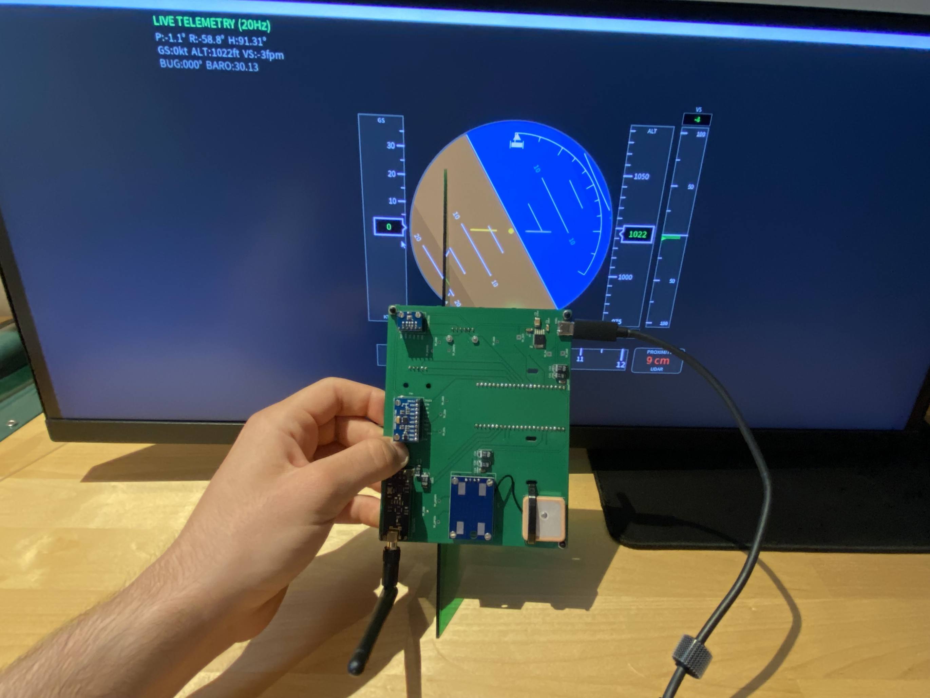
[picture p42: figure]
