arnaumora/TFG-Plataforma-Instrumentacion-Avionica/LATEX/Memoria/Diagramas/cache/main-figure4.pdf

Paquete completo: 8 palabras x 32 bits = 32 bytes, enviado a 20 Hz
