arnaumora/TFG-Plataforma-Instrumentacion-Avionica/LATEX/Annexes/Files/20_ANNEX_2.tex

\chapter{ANEXO II. Código Processing}

% 1. Archivo principal
\begin{mdframed}[style=CodeFrame]
\lstinputlisting[style=Processing, caption={Código principal del visualizador de vuelo (Flight Display)}, label={lst:proc_flightdisplay}]{../../Software/Processing/2-Final_code/FlightDisplay_Desktop/FlightDisplay.pde}
\end{mdframed}

% 2. AltimeterMSL
\begin{mdframed}[style=CodeFrame]
\lstinputlisting[style=Processing, caption={Código del indicador de altitud sobre el nivel del mar (Altimeter MSL)}, label={lst:proc_altimetermsl}]{../../Software/Processing/2-Final_code/FlightDisplay_Desktop/AltimeterMSL.pde}
\end{mdframed}

% 3. AttitudeIndicator
\begin{mdframed}[style=CodeFrame]
\lstinputlisting[style=Processing, caption={Código del indicador de actitud / horizonte artificial (Attitude Indicator)}, label={lst:proc_attitudeindicator}]{../../Software/Processing/2-Final_code/FlightDisplay_Desktop/AttitudeIndicator.pde}
\end{mdframed}

% 4. GPSMap
\begin{mdframed}[style=CodeFrame]
\lstinputlisting[style=Processing, caption={Código de la representación del mapa y datos GPS (GPS Map)}, label={lst:proc_gpsmap}]{../../Software/Processing/2-Final_code/FlightDisplay_Desktop/GPSMap.pde}
\end{mdframed}

% 5. GroundSpeedIndicator
\begin{mdframed}[style=CodeFrame]
\lstinputlisting[style=Processing, caption={Código del indicador de velocidad respecto al suelo (Ground Speed Indicator)}, label={lst:proc_groundspeed}]{../../Software/Processing/2-Final_code/FlightDisplay_Desktop/GroundSpeedIndicator.pde}
\end{mdframed}

% 6. HeadingIndicator
\begin{mdframed}[style=CodeFrame]
\lstinputlisting[style=Processing, caption={Código del indicador de rumbo (Heading Indicator)}, label={lst:proc_headingindicator}]{../../Software/Processing/2-Final_code/FlightDisplay_Desktop/HeadingIndicator.pde}
\end{mdframed}

% 7. ProximityIndicator
\begin{mdframed}[style=CodeFrame]
\lstinputlisting[style=Processing, caption={Código del indicador de proximidad (Proximity Indicator)}, label={lst:proc_proximityindicator}]{../../Software/Processing/2-Final_code/FlightDisplay_Desktop/ProximityIndicator.pde}
\end{mdframed}

% 8. VSI
\begin{mdframed}[style=CodeFrame]
\lstinputlisting[style=Processing, caption={Código del indicador de velocidad vertical (VSI)}, label={lst:proc_vsi}]{../../Software/Processing/2-Final_code/FlightDisplay_Desktop/VSI.pde}
\end{mdframed}
