arnaumora/TFG-Plataforma-Instrumentacion-Avionica/LATEX/Annexes/Files/30_ANNEX_3.tex

\chapter{ANEXO III. Figuras de apoyo}
\label{anx:figuras}
A continuación de muestras las fotos de la comprobación de la actitud de la plataforma.
\begin{figure}[H]
    \centering
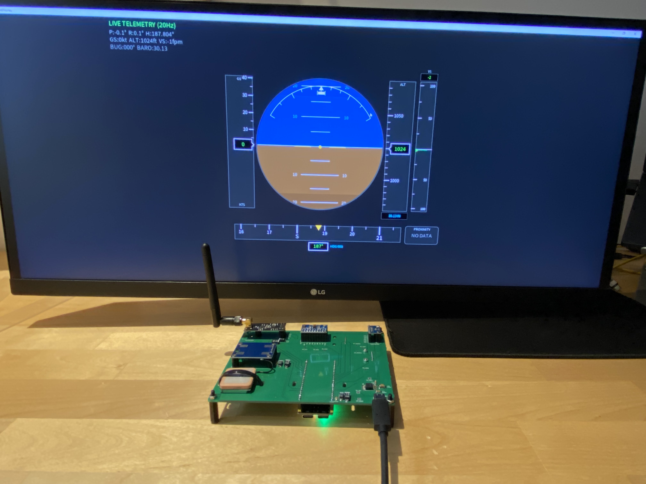
[picture p43: LATEX/Annexes/Figures/IMG_2153.jpeg]
    
\end{figure}

\begin{figure}[H]
    \centering
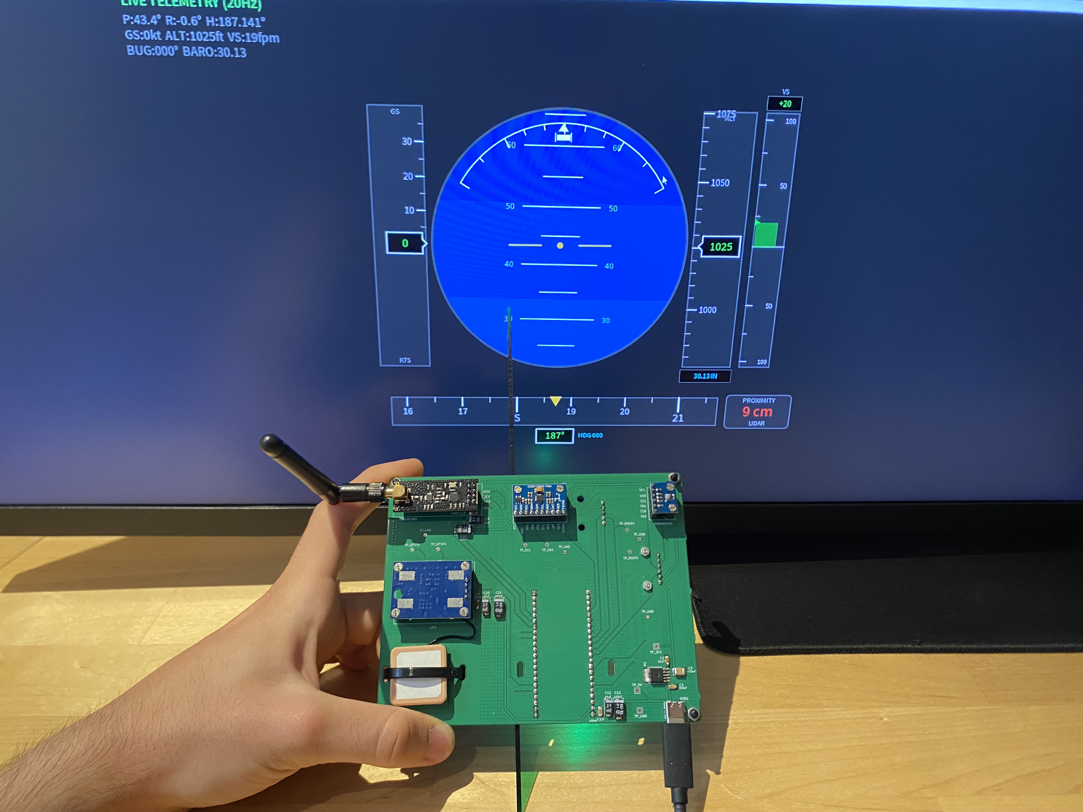
[picture p44: LATEX/Annexes/Figures/IMG_2154.jpeg]
    
\end{figure}

\begin{figure}[H]
    \centering
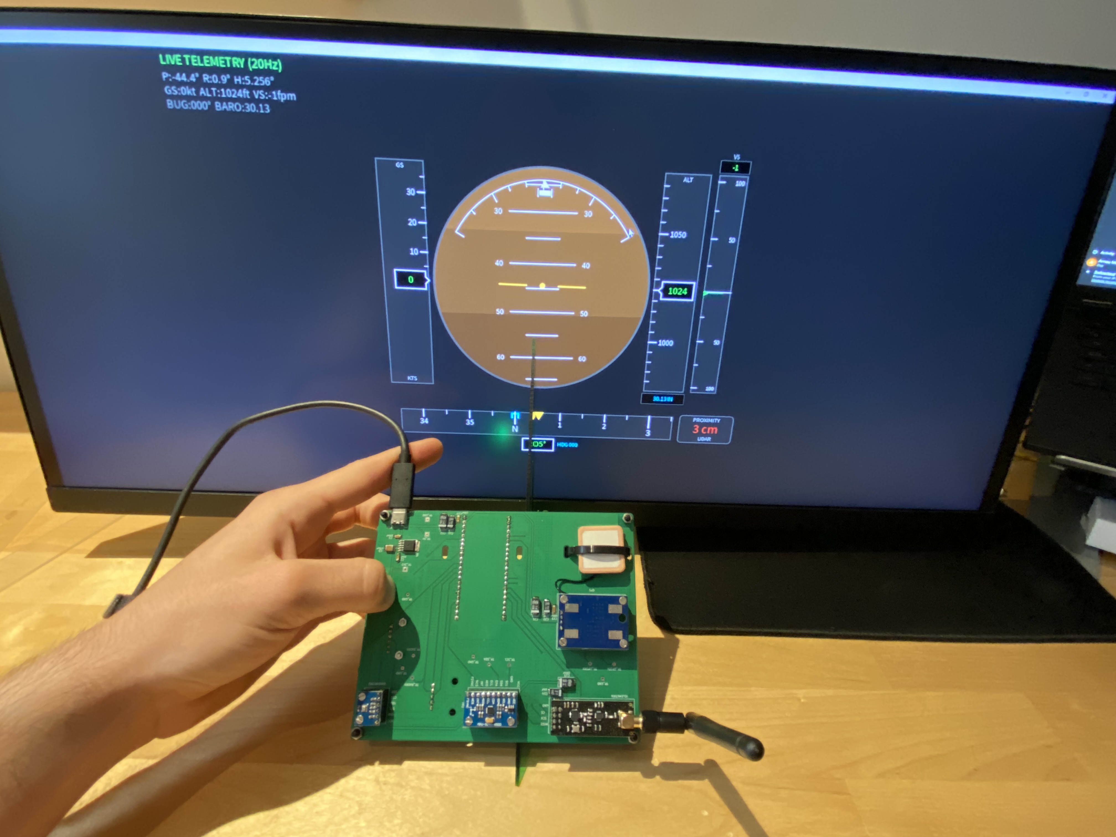
[picture p45: LATEX/Annexes/Figures/IMG_2155.jpeg]
    
\end{figure}

\begin{figure}[H]
    \centering
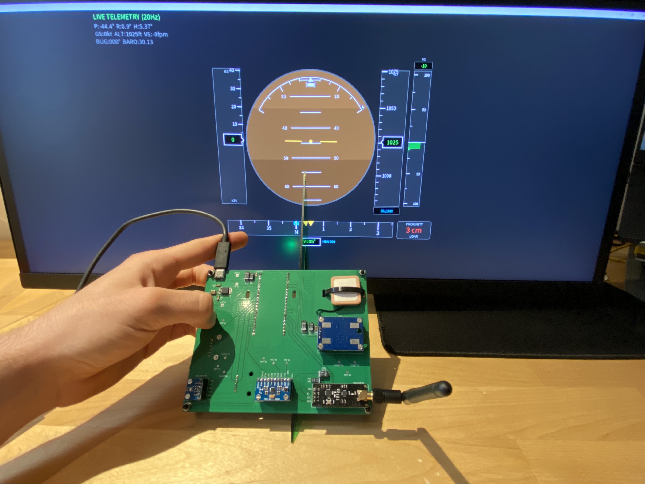
[picture p46: LATEX/Annexes/Figures/IMG_2156.jpeg]
    
\end{figure}

\begin{figure}[H]
    \centering
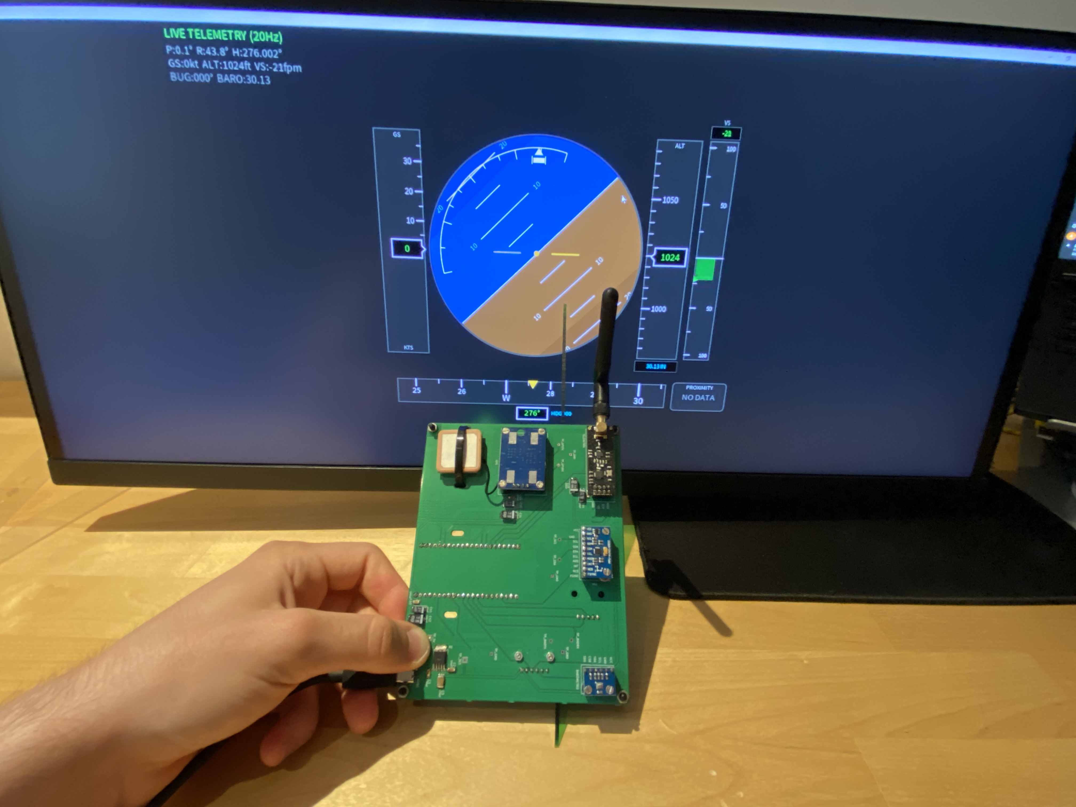
[picture p47: LATEX/Annexes/Figures/IMG_2157.jpeg]
    
\end{figure}

\begin{figure}[H]
    \centering
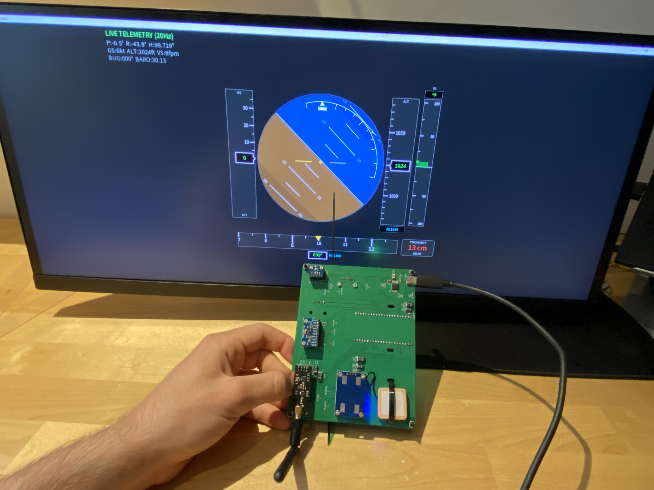
[picture p48: LATEX/Annexes/Figures/IMG_2158.jpeg]
    
\end{figure}

\begin{figure}[H]
    \centering
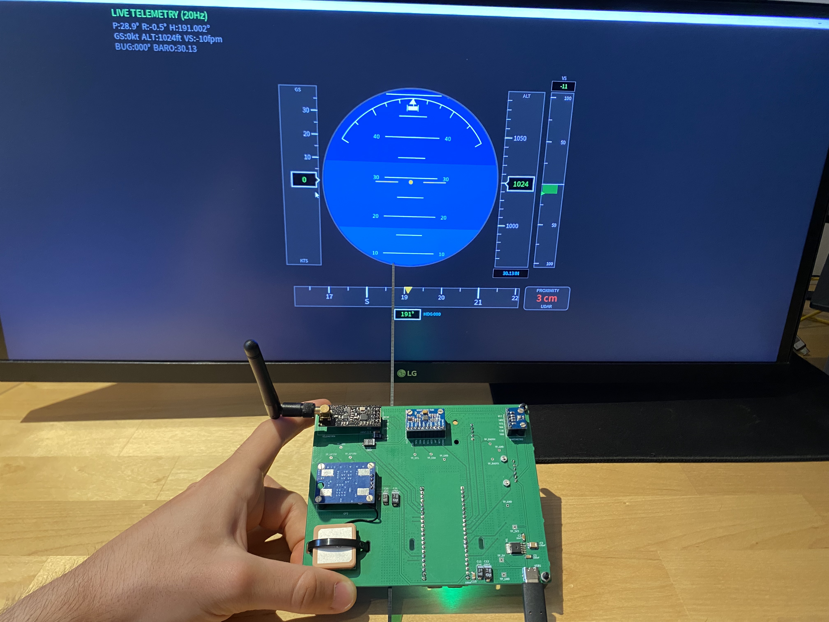
[picture p49: LATEX/Annexes/Figures/IMG_2159.jpeg]
    
\end{figure}

\begin{figure}[H]
    \centering
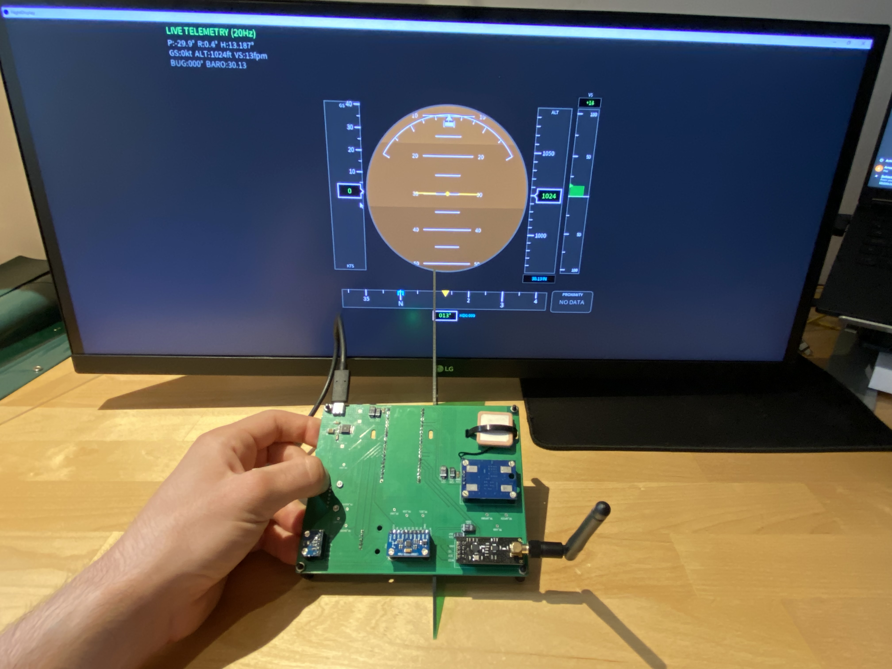
[picture p50: LATEX/Annexes/Figures/IMG_2160.jpeg]
    
\end{figure}

\begin{figure}[H]
    \centering
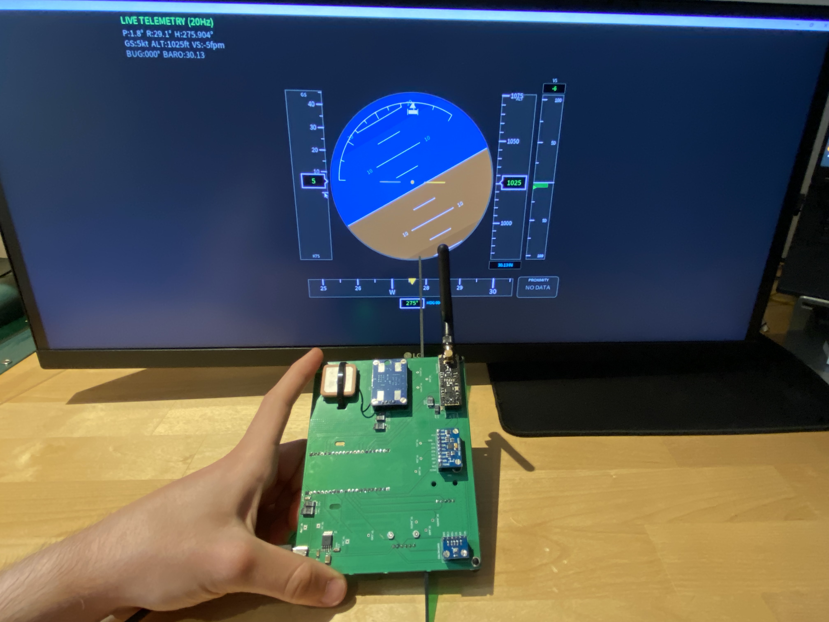
[picture p51: LATEX/Annexes/Figures/IMG_2161.jpeg]
    
\end{figure}

\begin{figure}[H]
    \centering
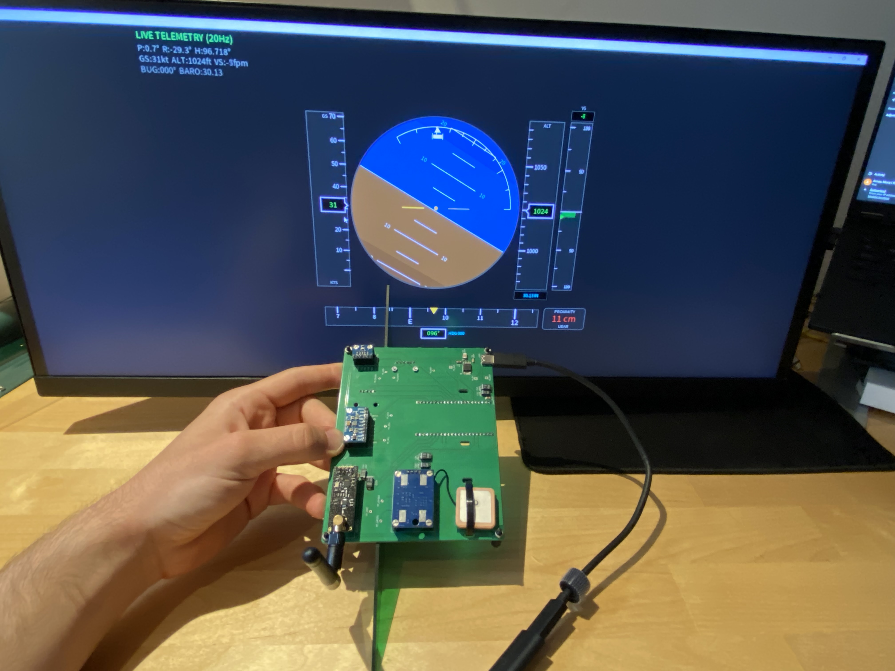
[picture p52: LATEX/Annexes/Figures/IMG_2162.jpeg]
    
\end{figure}

\begin{figure}[H]
    \centering
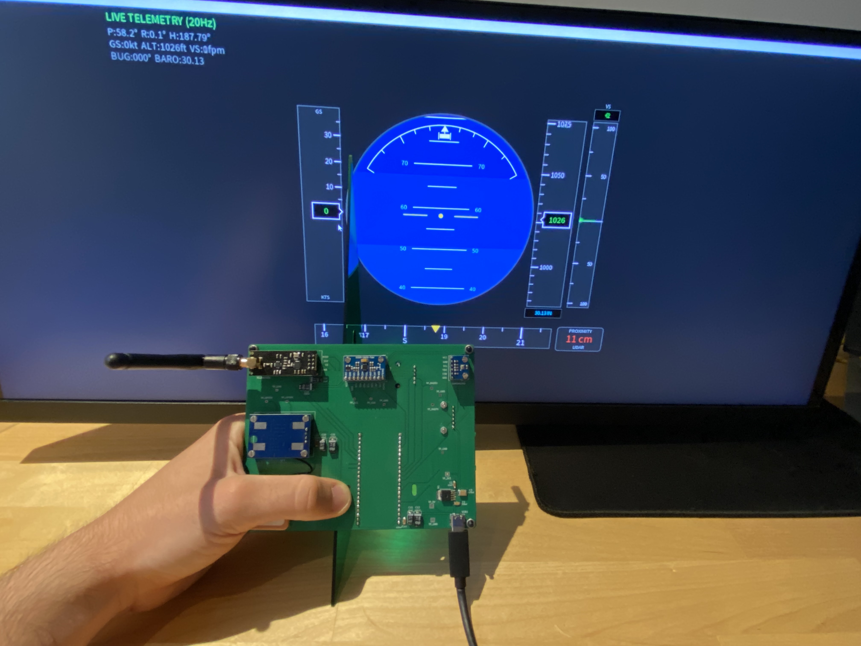
[picture p53: LATEX/Annexes/Figures/IMG_2163.jpeg]
    
\end{figure}

\begin{figure}[H]
    \centering
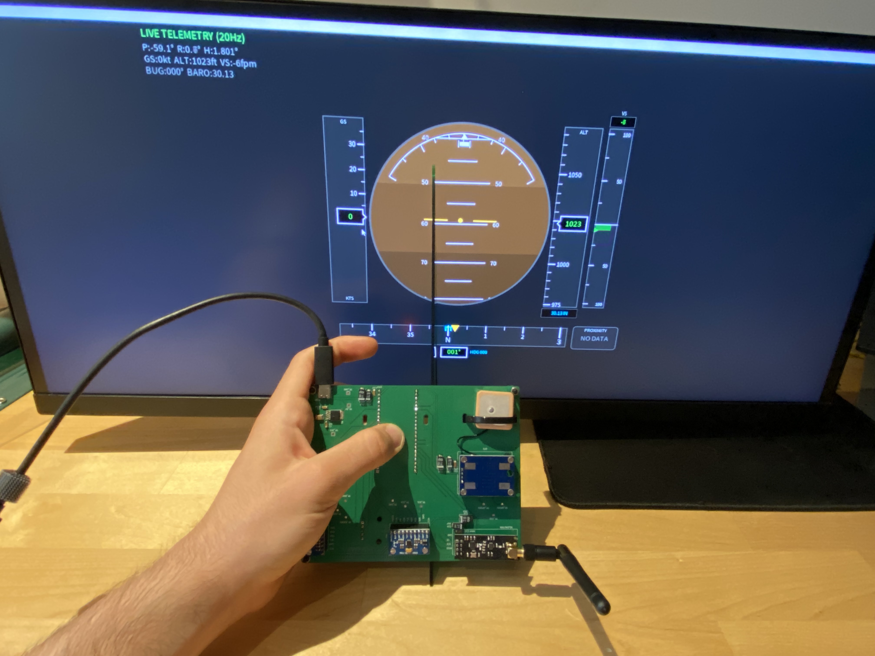
[picture p54: LATEX/Annexes/Figures/IMG_2164.jpeg]
    
\end{figure}

\begin{figure}[H]
    \centering
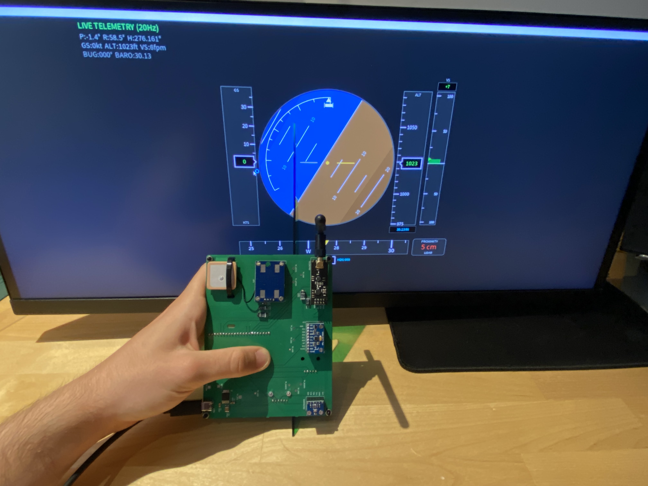
[picture p55: LATEX/Annexes/Figures/IMG_2165.jpeg]
    
\end{figure}

\begin{figure}[H]
    \centering
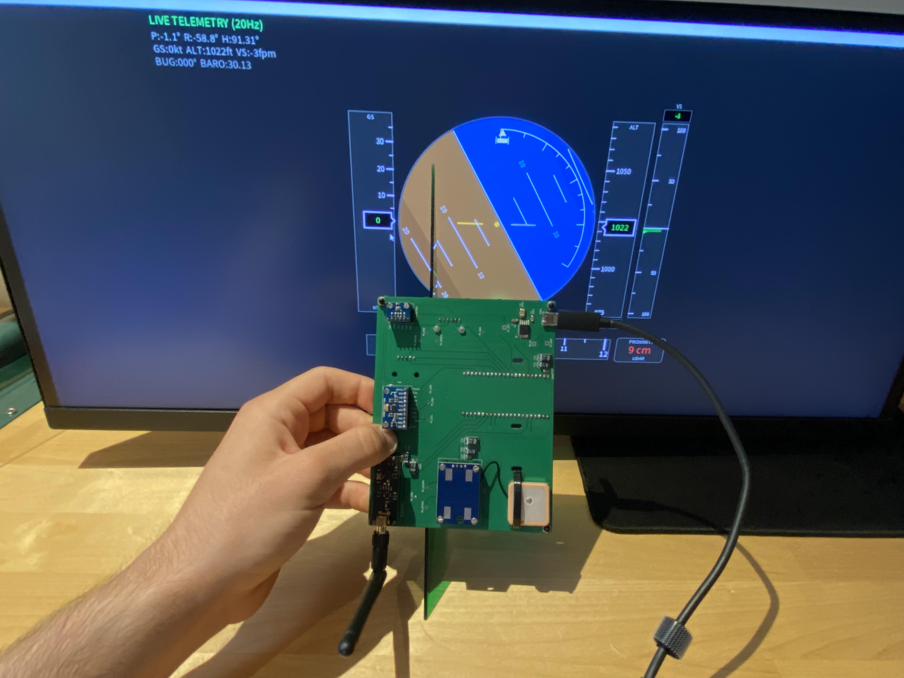
[picture p56: LATEX/Annexes/Figures/IMG_2166.jpeg]
    
\end{figure}
