arnaumora/TFG-Plataforma-Instrumentacion-Avionica/LATEX/Memoria/Files/80_Presupuesto.tex

%!TEX root = ../main.tex

\chapter{Presupuesto}
\label{ch:presupuesto}

Este capítulo ofrece un resumen del coste del desarrollo de la plataforma experimental. Para el desglose total, este se detalla en el documento de Presupuesto entregado de forma independiente.

\section{Resumen económico}
\label{sec:resumen_economico}

El coste se desglosa en las siguientes categorías: materiales, amortización de los equipos de laboratorio
empleados, software y coste de personal. En la \cref{tab:resumen_economico} se recoge el
coste total dividido en categorías. El coste total del proyecto asciende a \SI{14547.32}{\eur} con IVA incluido.

\begin{table}[H]
    \centering
    \caption{Resumen del coste del proyecto}
    \label{tab:resumen_economico}
    \footnotesize
    \begin{tabularx}{\linewidth}{X r}
        \toprule
        \textbf{Concepto} & \textbf{Coste} \\
        \midrule
        Materiales              & \SI{92}{\eur} \\
        Amortización de equipos & \SI{37.62}{\eur} \\
        Software                & \SI{0}{\eur} \\
        Personal                & \SI{10800}{\eur} \\
        \midrule
        Total (con costes indirectos del \SI{10}{\percent} e IVA del \SI{21}{\percent}) & \SI{14547.32}{\eur} \\
        \bottomrule
    \end{tabularx}
\end{table}
