arnaumora/TFG-Plataforma-Instrumentacion-Avionica/LATEX/Project Charter/Files/Abreviatures.tex

\chapter*{Lista de abreviaturas/Glosario }

Si procede.
