arnaumora/TFG-Plataforma-Instrumentacion-Avionica/Presentacio/Catalan/Q&A.docx

# El que has de dominar i preguntes probables del tribunal

### Prioritat maxima

## P1. La dada de GNSS i la figura de la memoria

Aquesta es la pregunta de mes risc. Si algu obre la memoria i veu l'scatter amb 11,45 m al costat d'un peu de figura que diu 1,00 m, t'ho preguntara. Resposta honesta i preparada:

La precisio estatica del GNSS es de l'ordre d'1 metre de CEP50, folgadament dins dels 2,5 metres del full de dades del NEO-6M i del requisit. Hi ha una incoherencia en una de les figures de la memoria: la grafica que va quedar inclosa prove d'un registre que no era una captura estatica neta. La trajectoria que es veu derivant correspon a la convergencia inicial i a moviment durant la presa, no al soroll estatic, i per aixo la seva llegenda dona un CEP inflat. La xifra representativa en estatic es la que consta al text i a la taula de compliment, 1 metre. El correcte hauria estat incloure la grafica estatica depurada.

Claus. Reconeix-ho, no defensis que 11,45 m es el resultat estatic, i recondueix al fet que el requisit (2,5 m) es compleix amb marge. El que demostra maduresa es admetre el descuit de la figura sense que trontolli la conclusio. Tampoc no diguis que el nuvol de 0,46 m es el bo: son nomes 9 fixacions i esta dominat per la quantitzacio. La xifra de consens es 1 m.

El perque tecnic. El NEO-6M sense correccions diferencials dona de l'ordre de 2,5 m CEP; en estatic, amb bona vista de cel i fent mitjana, es baixa a aproximadament 1 m. La reticula que es veu a les grafiques es la quantitzacio de la telemetria (uns 0,42 m per bit), no soroll del receptor.

## P2. Per que Ki = 1,0? Es un valor molt alt per a un Mahony

Tenen rao que es agressiu: a la literatura, Ki sol rondar el 0,1. Resposta:

Es un valor mes alt de l'habitual, triat de forma empirica buscant un punt de funcionament sobreesmorteit en aquest muntatge concret. Funciona be per una rao: el quaternio s'inicialitza de forma analitica des de l'accelerometre i el magnetometre, aixi que el filtre no arrenca lluny de la solucio i el terme integral no ha de corregir un error gran, nomes seguir la deriva lenta del giroscopi. El resultat es valida amb l'error d'actitud d'1,8 graus en estatic, que confirma que el punt d'operacio es estable.

Si insisteixen. Que un Ki alt pot injectar soroll del magnetometre a l'estimacio: reconeix el compromis i digues que en interior el rumb es degrada per distorsio magnetica (cosa que ja documentes), pero que en capcineig i balanceig, que es el que mesura el requisit, el comportament es estable.

### Fonaments d'ARINC 429 (per si demanen detalls)

Resum de suport per no quedar-se en blanc si el tribunal pregunta pel fonament de l'estandard, no nomes per la seva aplicacio.

Que es. ARINC 429 es l'estandard de bus de dades mes estes en l'aviacio civil; defineix com dos equips d'avionica intercanvien informacio digital. Es unidireccional i punt a punt: un transmissor envia a un o mes receptors, que no responen pel mateix canal. Aixo casa amb el sistema, on la informacio nomes va del node de sensors cap a la pantalla. La unitat basica es la paraula de 32 bits, i les velocitats normalitzades son 12,5 kbps (baixa) i 100 kbps (alta). La capa fisica original es senyalitzacio diferencial sobre parell trenat amb tres estats de tensio (HI, NULL, LO).

Estructura de la paraula de 32 bits (el que es reprodueix al codi):

- Label (bits 1-8): identifica quin parametre es (altitud, rumb...), expressat en octal.
- SDI (bits 9-10): identifica origen o desti quan hi ha equips redundants.
- Data (bits 11-29): el camp de dades, amb el valor codificat.
- SSM (bits 30-31): signe i estat de la dada (valida, no disponible, en prova). Es el camp d'estat.
- Parity (bit 32): bit de paritat, normalment senar, per deteccio d'errors.

Codificacio del camp de dades. Dos formats: BNR (binari en complement a dos amb escala, on cada bit val una fraccio del rang i el LSB fixa la resolucio) i BCD (cada digit decimal en 4 bits). En el projecte s'usa BNR, i aixi es on apareix la quantitzacio del GNSS.

Com relacionar-ho amb el projecte (resposta forta):

Del ARINC 429 reutilitzo la capa logica: l'estructura de paraula de 32 bits amb label, SSM, codificacio BNR i bit de paritat. La capa fisica original, la senyalitzacio diferencial sobre parell trenat, no es reproduible aqui perque el transport es per radio a 2,4 GHz. Per aixo el sistema encapsula les paraules ARINC dins del payload del NRF24: 8 paraules de 32 bits son exactament els 32 bytes del payload, aixi que no cal fragmentar.

Nota. El detall del LSB del BNR explica el bug de quantitzacio del GNSS: si el LSB es massa gran per al rang que codifiques, perds precisio en la posicio. Connectar la teoria amb un problema real que vas resoldre reforca molt la resposta.

Referencies: ARINC Specification 429 Part 1-17 (Mark 33 DITS), font normativa primaria ja present a la bibliografia de normes; AIM GmbH, 'ARINC 429 Protocol Tutorial' (PDF gratuit a aim-online.com); Spitzer, C. R. (ed.), 'Digital Avionics Handbook', CRC Press, capitol de busos de dades.

### Preguntes probables (amb resposta breu)

## El radar HLK-LD2410C: el vas implementar pero no el fas servir per a la proximitat. Per que?

El radar esta integrat d'extrem a extrem i transmet a la telemetria, pero la seva sortida es una classificacio per portes de distancia, no una mesura metrica estable. Per aixo la font activa de l'indicador de proximitat es el sensor de temps de vol VL53L1X, que dona un error de menys de 2 cm davant de cinta metrica. El radar queda com a segona font comparativa i amb valor docent. Esta justificat aixi a la memoria, i la seva incorporacio com a font activa figura com a treball futur.

## El rumb l'anomenes magnetic, pero hi apliques la declinacio. No es llavors rumb verdader?

La font fisica es el magnetometre, per aixo s'etiqueta com a magnetic. S'hi aplica la declinacio local com a constant (1,95 graus), de manera que el valor mostrat s'aproxima al rumb verdader. La nomenclatura segueix l'origen del sensor; l'ajust de declinacio es una correccio fixa.

## Com mesures la perdua de paquets?

El que tinc es un indicador de salut de l'enllac a 5 Hz, derivat de la sequencia de la paraula d'estat, no una mesura estadistica rigorosa de taxa de perdua. Permet verificar que l'enllac esta viu. Una caracteritzacio quantitativa de l'enllac es part del treball futur, i aixi figura a la diapositiva de treball futur.

Nota. No ho venguis com una mesura de perdua validada; la memoria es honesta en aixo i tu tambe ho has de ser.

## La latencia de 85 ms, l'has mesurada?

Es una fita analitica del pitjor cas, sumant els retards de transport de cada etapa de la cadena. La latencia tipica es menor. Queda molt per sota del limit de 200 ms del requisit. Ho he indicat aixi tant a la memoria com a la diapositiva de xifres de merit.

## I l'abast de 100 m?

Prove del full de dades del modul amb amplificador i del marge d'enllac, justificat analiticament. L'us real al laboratori es de pocs metres. Una prova d'abast real es treball futur, i aixi figura a la presentacio.

## Per que ARINC 429 i no una simple estructura de dades propia?

Per tres motius: tracabilitat amb una norma aeronautica real, valor docent (l'alumne treballa amb etiquetes, codificacio BNR, paritat i camp d'estat), i perque la norma ja ofereix una paraula estructurada amb els camps necessaris, sense dissenyar un format des de zero. I encaixa: 8 paraules de 32 bits son exactament els 32 bytes del payload de la radio.

Nota. Si pregunten si reprodueixes l'ARINC fisic: 'No, la capa fisica d'ARINC, la senyalitzacio diferencial sobre parell trenat, es impossible aqui perque el transport es per radio. El que reutilitzo es la capa logica.'

## Per que dos microcontroladors i no un de connectat per cable?

Per mobilitat del node de sensors, per reflectir l'arquitectura real d'una aeronau i pel valor docent de l'enllac sense fils. Complint igualment latencia i abast.

## Per que NRF24 i no WiFi o BLE?

WiFi-UDP te mes consum i l'espectre sol estar saturat en entorns academics; Bluetooth Classic te mes latencia i un aparellament complex; BLE esta pensat per a taxa baixa, no per a un flux continu de telemetria estructurada. El transceptor RF a 2,4 GHz dona baixa latencia, abast suficient i baix cost.

## La calibracio del magnetometre, com la vas fer?

Amb captura de minims i maxims en els tres eixos per corregir l'offset de ferro dur. Un detall important: la calibracio s'ha de fer amb tots els periferics actius i la radio transmetent, perque fer-la nomes amb la IMU encesa dona offsets erronis.

## Cost per sota de 100 euros, ho mantens?

Si, el cost de materials per replicar la plataforma queda per sota de 100 euros. El pressupost complet, amb personal i amortitzacio d'equips, es troba al document de pressupost, que avui no presento per indicacio del tutor.

## Aixo necessitaria certificacio per volar?

No, es una plataforma experimental i educativa, sense pretensio de certificacio ni de hardware ni de software. S'han seguit les directrius de les normes (AC 25-11B, HF-STD-001B, SAE AS8034C, 14 CFR 25.1321/1322) amb finalitats academiques, no per certificar.

## Si tinguessis mes temps, que milloraries?

Bona oportunitat per mostrar criteri:

Repetiria la caracteritzacio del GNSS amb una captura estatica llarga i depurada per tancar la dada amb una grafica neta, afegiria mesures reals d'abast i de taxa de perdua de l'enllac, i incorporaria el radar com a font de proximitat. Tambe la descarrega online de mapes.
