arnaumora/TFG-Plataforma-Instrumentacion-Avionica/LATEX/Memoria/Diagramas/cache/main-figure5.pdf

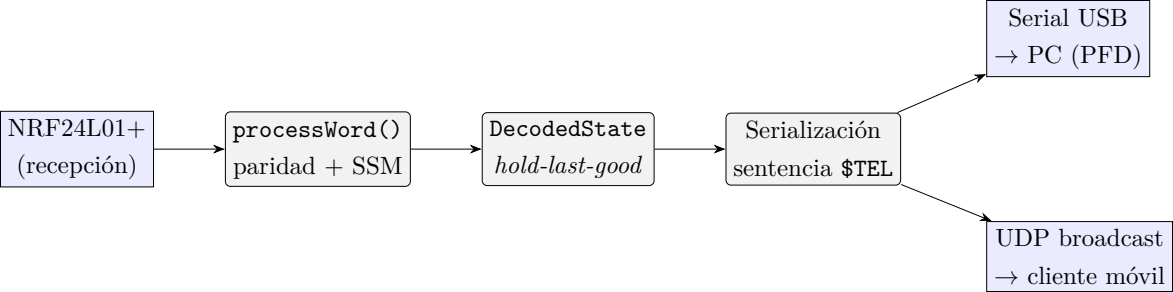
[picture p57: figure]
NRF24L01+ (recepción); processWord() paridad + SSM; DecodedState hold-last-good; Serialización sentencia $TEL; Serial USB → PC (PFD); UDP broadcast → cliente móvil
