arnaumora/TFG-Plataforma-Instrumentacion-Avionica/LATEX/Memoria/Diagramas/cache/main-figure6.pdf

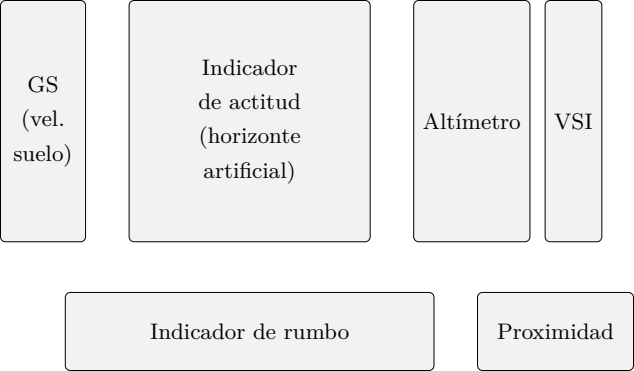
[picture p58: figure]
Indicador de actitud (horizonte artificial); GS (vel. suelo); Altímetro VSI; Indicador de rumbo; Proximidad
