arnaumora/TFG-Plataforma-Instrumentacion-Avionica/PCB/Misc Data/41PB7AASGNL._AC_-1-579741917.jpg

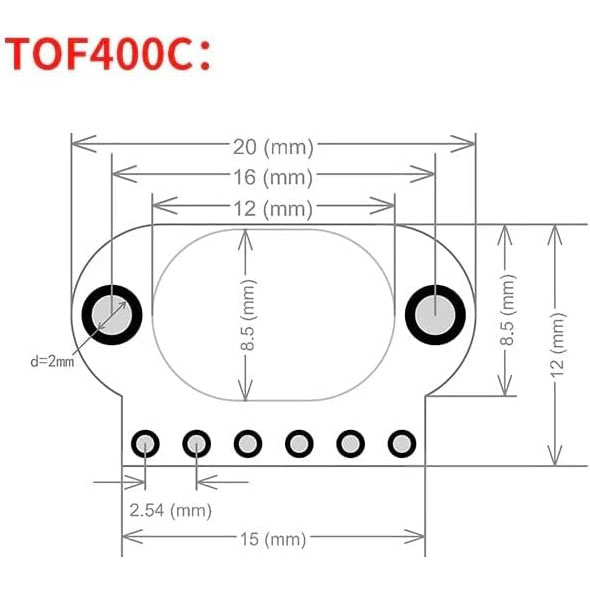
PCB/Misc Data/41PB7AASGNL._AC_-1-579741917.jpg
