arnaumora/TFG-Plataforma-Instrumentacion-Avionica/PCB/Components/3D/ESP32-C3_SUPERMINI.step

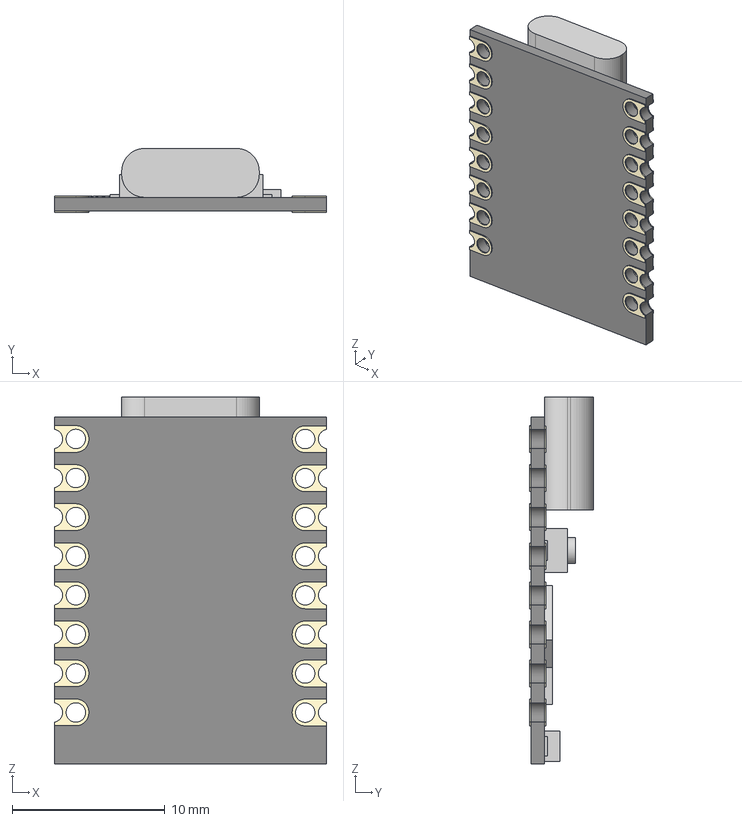
[picture p60: CAD file, 2026-07-01]
PCB/Components/3D/ESP32-C3_SUPERMINI.step
17.8 x 4.20 x 24.0 mm
