arnaumora/TFG-Plataforma-Instrumentacion-Avionica/PCB/Components/3D/GY-GPS6MV2.step

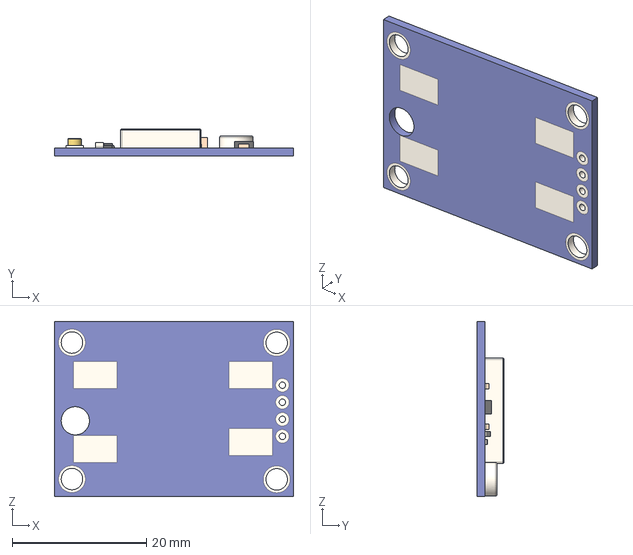
[picture p61: CAD file, 2026-07-01]
PCB/Components/3D/GY-GPS6MV2.step
35.6 x 4.06 x 26.1 mm
