arnaumora/TFG-Plataforma-Instrumentacion-Avionica/PCB/Components/3D/MT3608.STEP

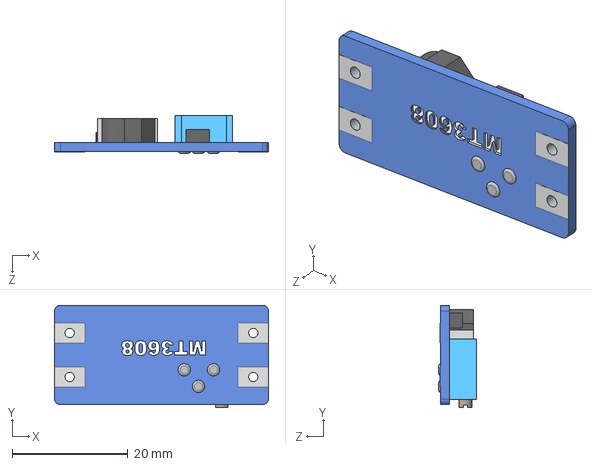
[picture p62: CAD file, 2026-07-01]
PCB/Components/3D/MT3608.STEP
37.0 x 17.7 x 6.50 mm
