arnaumora/TFG-Plataforma-Instrumentacion-Avionica/PCB/Components/3D/TOF400C.STEP

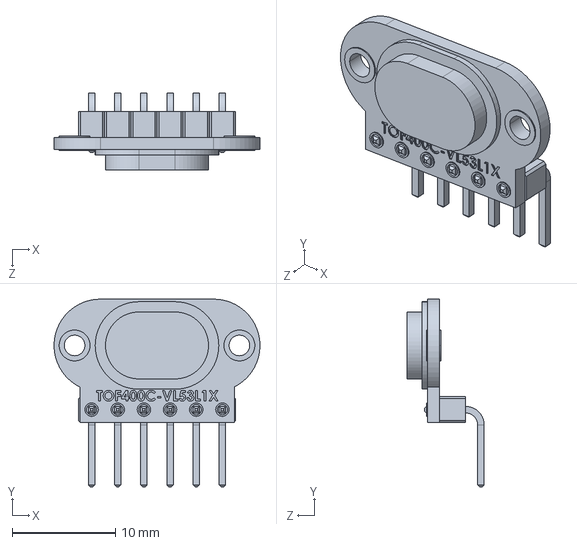
[picture p63: CAD file, 2026-07-01]
PCB/Components/3D/TOF400C.STEP
20.0 x 18.2 x 7.52 mm
