arnaumora/TFG-Plataforma-Instrumentacion-Avionica/PCB/Components/3D/TypeC_port.step

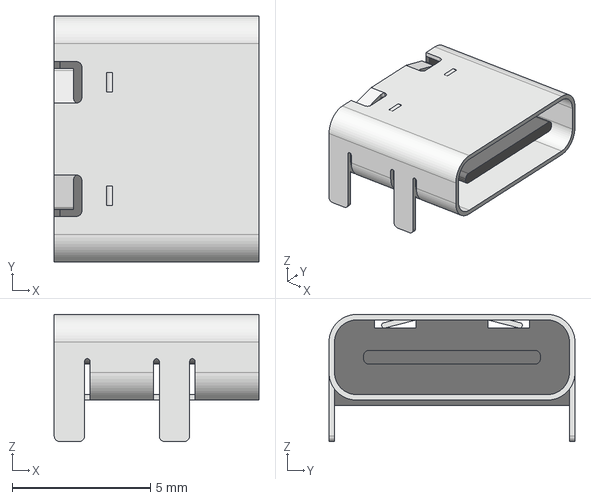
[picture p64: CAD file, 2026-07-01]
PCB/Components/3D/TypeC_port.step
7.40 x 8.90 x 4.60 mm
