arnaumora/TFG-Plataforma-Instrumentacion-Avionica/PCB/Components/3D/TOF400C_2.step

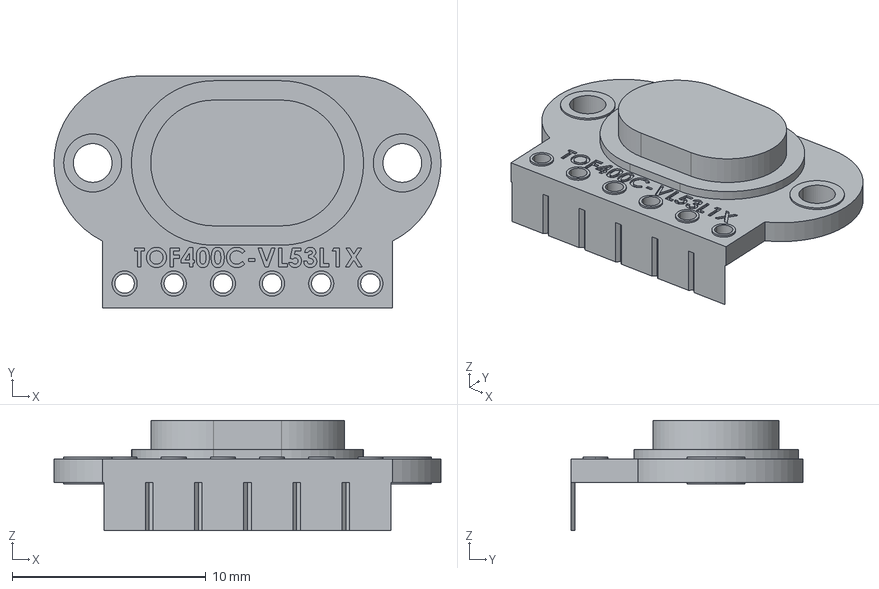
[picture p65: CAD file, 2026-07-01]
PCB/Components/3D/TOF400C_2.step
20.0 x 12.0 x 5.70 mm
TOF400C.0.2 x 2
TOF400C.0.5 x 2
TOF400C.0.0 x 2
TOF400C.0.15 x 2
TOF400C.0.4 x 2
TOF400C.0.9 x 2
TOF400C.0.10 x 2
TOF400C.0.3 x 2
TOF400C.0.1 x 2
TOF400C.0.6 x 2
TOF400C.0.7 x 2
TOF400C.0.8 x 2
TOF400C.0.11 x 2
TOF400C.0.12 x 2
TOF400C.0.13 x 2
TOF400C.0.14 x 2
TOF400C.0.16 x 2
TOF400C.0.17 x 2
TOF400C.0.18 x 2
TOF400C.0.19 x 2
TOF400C.0.20 x 2
TOF400C.0.21 x 2
TOF400C.0.22 x 2
TOF400C.0.23 x 2
TOF400C.0.24 x 2
TOF400C.0.25 x 2
TOF400C.0.26 x 2
TOF400C.0.27 x 2
TOF400C.0.28 x 2
TOF400C.0.29 x 2
TOF400C.0.30 x 2
TOF400C.0.31 x 2
TOF400C.0.32 x 2
TOF400C.0.33 x 2
TOF400C.0.34 x 2
TOF400C.0.35 x 2
TOF400C.0.36 x 2
TOF400C.0.37 x 2
TOF400C.0.38 x 2
TOF400C.0.39 x 2
TOF400C.0.40 x 2
TOF400C.0.41 x 2
TOF400C.0.42 x 2
TOF400C.0.43 x 2
TOF400C.0.44 x 2
TOF400C.0.45 x 2
TOF400C.0.46 x 2
TOF400C.0.47 x 2
TOF400C.0.48 x 2
TOF400C.0.49 x 2
TOF400C.0.50 x 2
TOF400C.0.51 x 2
TOF400C.0.52 x 2
TOF400C.0.53 x 2
TOF400C.0.54 x 2
TOF400C.0.55 x 2
TOF400C.0.56 x 2
TOF400C.0.57 x 2
TOF400C.0.58 x 2
TOF400C.0.59 x 2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
