arnaumora/TFG-Plataforma-Instrumentacion-Avionica/PCB/Components/3D/GY-GPS6MV2_box.step

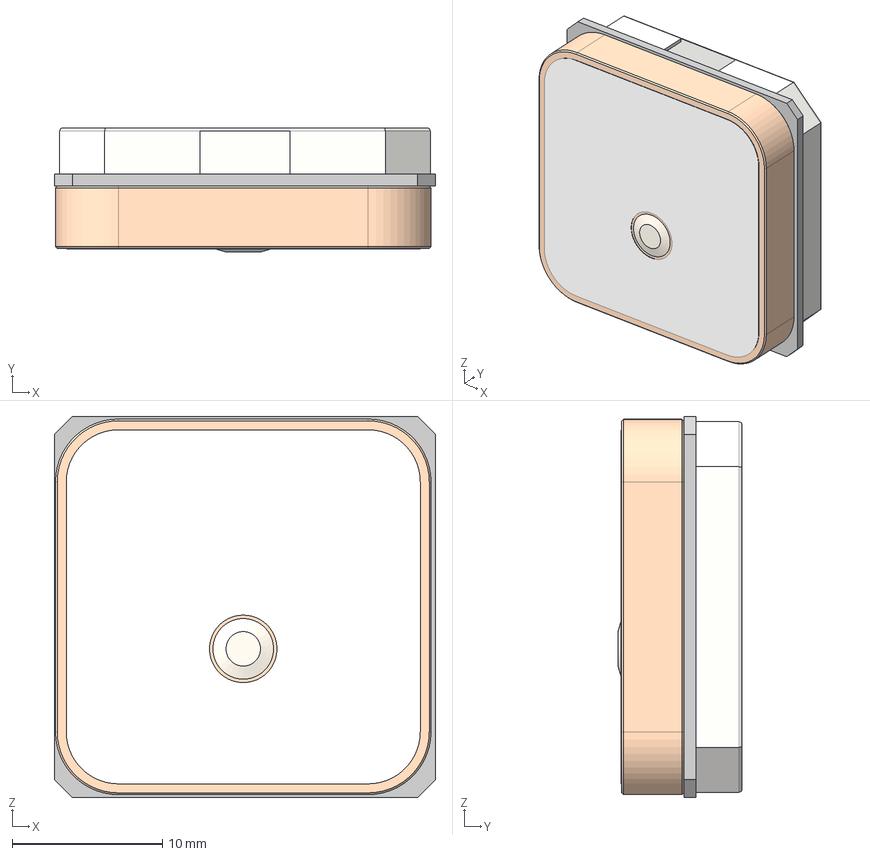
[picture p66: CAD file, 2026-07-01]
PCB/Components/3D/GY-GPS6MV2_box.step
25.4 x 8.27 x 25.4 mm
