arnaumora/TFG-Plataforma-Instrumentacion-Avionica/PCB/Components/3D/to252-5.stp

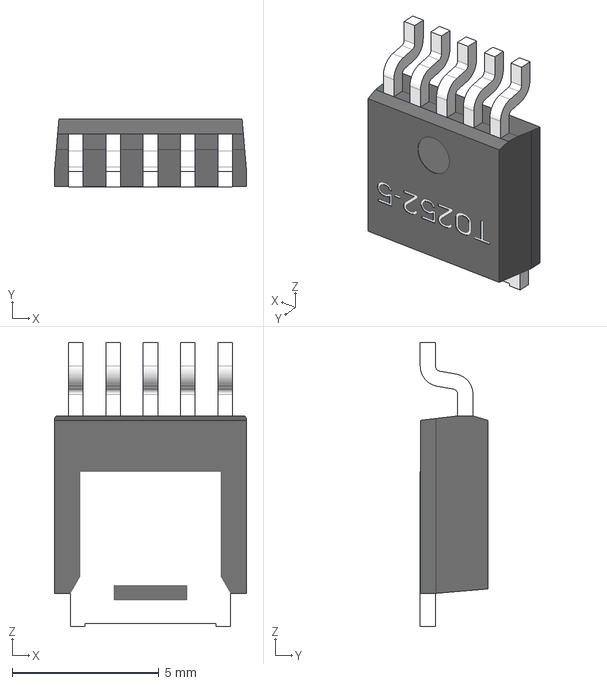
[picture p68: CAD file, 2026-07-01]
PCB/Components/3D/to252-5.stp
6.54 x 2.30 x 9.67 mm
