arnaumora/TFG-Plataforma-Instrumentacion-Avionica/PCB/Components/3D/bmp280.stp

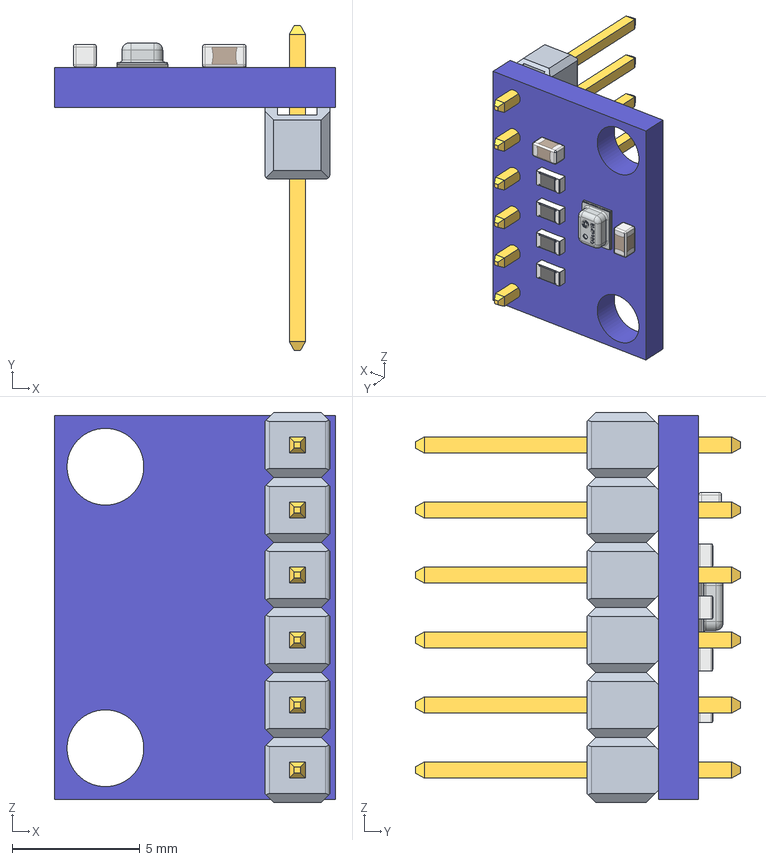
[picture p69: CAD file, 2026-07-01]
PCB/Components/3D/bmp280.stp
11.0 x 12.7 x 15.2 mm
