arnaumora/TFG-Plataforma-Instrumentacion-Avionica/PCB/Components/3D/NJM12856DL3.stp

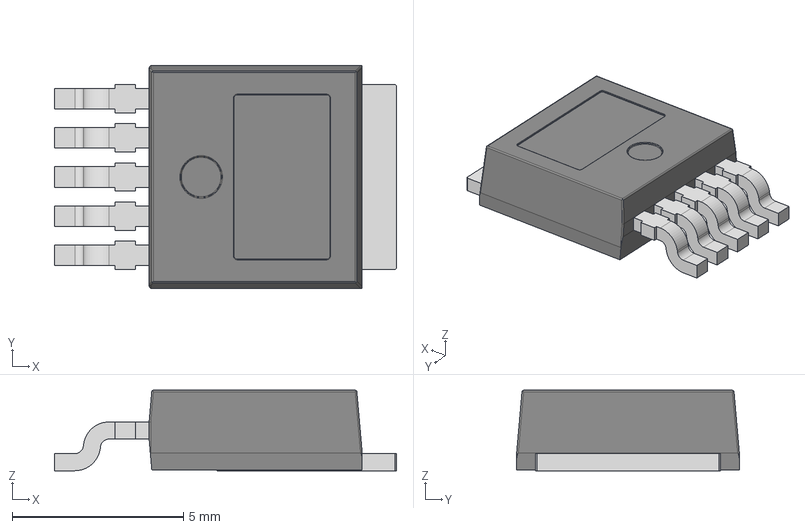
[picture p70: CAD file, 2026-07-01]
PCB/Components/3D/NJM12856DL3.stp
9.98 x 6.50 x 2.35 mm
TO-252_body
TO-252_heatsink_4
TO-252_pin_standart_narrow x 5
