arnaumora/TFG-Plataforma-Instrumentacion-Avionica/Presentacio/Spanish/QA_ES.docx

# Lo que tienes que dominar y preguntas probables del tribunal

### Prioridad maxima

## P1. El dato de GNSS y la figura de la memoria

Esta es la pregunta de mayor riesgo. Si alguien abre la memoria y ve el scatter con 11,45 m al lado de un pie de figura que dice 1,00 m, te lo preguntara. Respuesta honesta y preparada:

La precision estatica del GNSS es del orden de 1 metro de CEP50, holgadamente dentro de los 2,5 metros de la hoja de datos del NEO-6M y del requisito. Hay una incoherencia en una de las figuras de la memoria: la grafica que quedo incluida procede de un registro que no era una captura estatica limpia. La traza que se ve deambulando corresponde a la convergencia inicial y a movimiento durante la toma, no al ruido estatico, y por eso su leyenda da un CEP inflado. La cifra representativa en estatico es la que consta en el texto y en la tabla de cumplimiento, 1 metro. Lo correcto habria sido incluir la grafica estatica depurada.

Claves. Reconocelo, no defiendas que 11,45 m es el resultado estatico, y reconduce al hecho de que el requisito (2,5 m) se cumple con margen. Lo que demuestra madurez es admitir el desliz de la figura sin que se tambalee la conclusion. Tampoco digas que la nube de 0,46 m es la buena: son solo 9 fijaciones y esta dominada por la cuantizacion. La cifra de consenso es 1 m.

El porque tecnico. El NEO-6M sin correcciones diferenciales da del orden de 2,5 m CEP; en estatico, con buena vista de cielo y promediando, se baja a aproximadamente 1 m. La reticula que se ve en las graficas es la cuantizacion de la telemetria (unos 0,42 m por bit), no ruido del receptor.

## P2. Por que Ki = 1,0? Es un valor muy alto para un Mahony

Tienen razon en que es agresivo: en la literatura, Ki suele rondar el 0,1. Respuesta:

Es un valor mas alto de lo habitual, elegido de forma empirica buscando un punto de funcionamiento sobreamortiguado en este montaje concreto. Funciona bien por una razon: el cuaternion se inicializa de forma analitica desde el acelerometro y el magnetometro, asi que el filtro no arranca lejos de la solucion y el termino integral no tiene que corregir un error grande, solo seguir la deriva lenta del giroscopio. El resultado se valida con el error de actitud de 1,8 grados en estatico, que confirma que el punto de operacion es estable.

Si insisten. Que un Ki alto puede inyectar ruido del magnetometro en la estimacion: reconoce el compromiso y di que en interior el rumbo se degrada por distorsion magnetica (cosa que ya documentas), pero que en cabeceo y alabeo, que es lo que mide el requisito, el comportamiento es estable.

### Fundamentos de ARINC 429 (por si piden detalles)

Resumen de apoyo para no quedarse en blanco si el tribunal pregunta por el fundamento del estandar, no solo por su aplicacion.

Que es. ARINC 429 es el estandar de bus de datos mas extendido en la aviacion civil; define como dos equipos de avionica intercambian informacion digital. Es unidireccional y punto a punto: un transmisor envia a uno o mas receptores, que no responden por el mismo canal. Esto encaja con el sistema, donde la informacion solo va del nodo de sensores hacia la pantalla. La unidad basica es la palabra de 32 bits, y las velocidades normalizadas son 12,5 kbps (baja) y 100 kbps (alta). La capa fisica original es senalizacion diferencial sobre par trenzado con tres estados de tension (HI, NULL, LO).

Estructura de la palabra de 32 bits (lo que se reproduce en el codigo):

- Label (bits 1-8): identifica que parametro es (altitud, rumbo...), expresado en octal.
- SDI (bits 9-10): identifica origen o destino cuando hay equipos redundantes.
- Data (bits 11-29): el campo de datos, con el valor codificado.
- SSM (bits 30-31): signo y estado del dato (valido, no disponible, en prueba). Es el campo de estado.
- Parity (bit 32): bit de paridad, normalmente impar, para deteccion de errores.

Codificacion del campo de datos. Dos formatos: BNR (binario en complemento a dos con escala, donde cada bit vale una fraccion del rango y el LSB fija la resolucion) y BCD (cada digito decimal en 4 bits). En el proyecto se usa BNR, y ahi es donde aparece la cuantizacion del GNSS.

Como relacionarlo con el proyecto (respuesta fuerte):

De ARINC 429 reutilizo la capa logica: la estructura de palabra de 32 bits con label, SSM, codificacion BNR y bit de paridad. La capa fisica original, la senalizacion diferencial sobre par trenzado, no es reproducible aqui porque el transporte es por radio a 2,4 GHz. Por eso el sistema encapsula las palabras ARINC dentro del payload del NRF24: 8 palabras de 32 bits son exactamente los 32 bytes del payload, asi que no hace falta fragmentar.

Nota. El detalle del LSB del BNR explica el bug de cuantizacion del GNSS: si el LSB es demasiado grande para el rango que codificas, pierdes precision en la posicion. Conectar la teoria con un problema real que resolviste refuerza mucho la respuesta.

Referencias: ARINC Specification 429 Part 1-17 (Mark 33 DITS), fuente normativa primaria ya presente en la bibliografia de normas; AIM GmbH, 'ARINC 429 Protocol Tutorial' (PDF gratuito en aim-online.com); Spitzer, C. R. (ed.), 'Digital Avionics Handbook', CRC Press, capitulo de buses de datos.

### Preguntas probables (con respuesta breve)

## El radar HLK-LD2410C: lo implementaste pero no lo usas para la proximidad. Por que?

El radar esta integrado de extremo a extremo y transmite en la telemetria, pero su salida es una clasificacion por puertas de distancia, no una medida metrica estable. Por eso la fuente activa del indicador de proximidad es el sensor de tiempo de vuelo VL53L1X, que da un error de menos de 2 cm frente a cinta metrica. El radar queda como segunda fuente comparativa y con valor docente. Esta justificado asi en la memoria, y su incorporacion como fuente activa figura como trabajo futuro.

## El rumbo lo llamas magnetico, pero le aplicas la declinacion. No es entonces rumbo verdadero?

La fuente fisica es el magnetometro, por eso se etiqueta como magnetico. Se le aplica la declinacion local como constante (1,95 grados), de modo que el valor mostrado se aproxima al rumbo verdadero. La nomenclatura sigue el origen del sensor; el ajuste de declinacion es una correccion fija.

## Como mides la perdida de paquetes?

Lo que tengo es un indicador de salud del enlace a 5 Hz, derivado de la secuencia de la palabra de estado, no una medida estadistica rigurosa de tasa de perdida. Permite verificar que el enlace esta vivo. Una caracterizacion cuantitativa del enlace es parte del trabajo futuro, y asi figura en la diapositiva de trabajo futuro.

Nota. No lo vendas como una medida de perdida validada; la memoria es honesta en esto y tu tambien debes serlo.

## La latencia de 85 ms, la has medido?

Es una cota analitica del peor caso, sumando los retardos de transporte de cada etapa de la cadena. La latencia tipica es menor. Queda muy por debajo del limite de 200 ms del requisito. Lo he indicado asi tanto en la memoria como en la diapositiva de cifras de merito.

## Y el alcance de 100 m?

Procede de la hoja de datos del modulo con amplificador y del margen de enlace, justificado analiticamente. El uso real en el laboratorio es de pocos metros. Una prueba de alcance real es trabajo futuro, y asi figura en la presentacion.

## Por que ARINC 429 y no una simple estructura de datos propia?

Por tres motivos: trazabilidad con una norma aeronautica real, valor docente (el alumno trabaja con etiquetas, codificacion BNR, paridad y campo de estado), y porque la norma ya ofrece una palabra estructurada con los campos necesarios, sin disenar un formato desde cero. Y encaja: 8 palabras de 32 bits son exactamente los 32 bytes del payload de la radio.

Nota. Si preguntan si reproduces el ARINC fisico: 'No, la capa fisica de ARINC, la senalizacion diferencial sobre par trenzado, es imposible aqui porque el transporte es por radio. Lo que reutilizo es la capa logica.'

## Por que dos microcontroladores y no uno conectado por cable?

Por movilidad del nodo de sensores, por reflejar la arquitectura real de una aeronave y por el valor docente del enlace inalambrico. Cumpliendo igualmente latencia y alcance.

## Por que NRF24 y no WiFi o BLE?

WiFi-UDP tiene mas consumo y el espectro suele estar saturado en entornos academicos; Bluetooth Classic tiene mas latencia y un emparejamiento complejo; BLE esta pensado para tasa baja, no para un flujo continuo de telemetria estructurada. El transceptor RF a 2,4 GHz da baja latencia, alcance suficiente y bajo coste.

## La calibracion del magnetometro, como la hiciste?

Con captura de minimos y maximos en los tres ejes para corregir el offset de hierro duro. Un detalle importante: la calibracion se debe hacer con todos los perifericos activos y la radio transmitiendo, porque hacerla solo con la IMU encendida da offsets erroneos.

## Coste por debajo de 100 euros, lo mantienes?

Si, el coste de materiales para replicar la plataforma queda por debajo de 100 euros. El presupuesto completo, con personal y amortizacion de equipos, se encuentra en el documento de presupuesto, que hoy no presento por indicacion del tutor.

## Esto necesitaria certificacion para volar?

No, es una plataforma experimental y educativa, sin pretension de certificacion ni de hardware ni de software. Se han seguido las directrices de las normas (AC 25-11B, HF-STD-001B, SAE AS8034C, 14 CFR 25.1321/1322) con fines academicos, no para certificar.

## Si tuvieras mas tiempo, que mejorarias?

Buena oportunidad para mostrar criterio:

Repetiria la caracterizacion del GNSS con una captura estatica larga y depurada para cerrar el dato con una grafica limpia, anadiria medidas reales de alcance y de tasa de perdida del enlace, e incorporaria el radar como fuente de proximidad. Tambien la descarga online de mapas.
