arnaumora/TFG-Plataforma-Instrumentacion-Avionica/LATEX/Memoria/Diagramas/cache/main-figure0.pdf

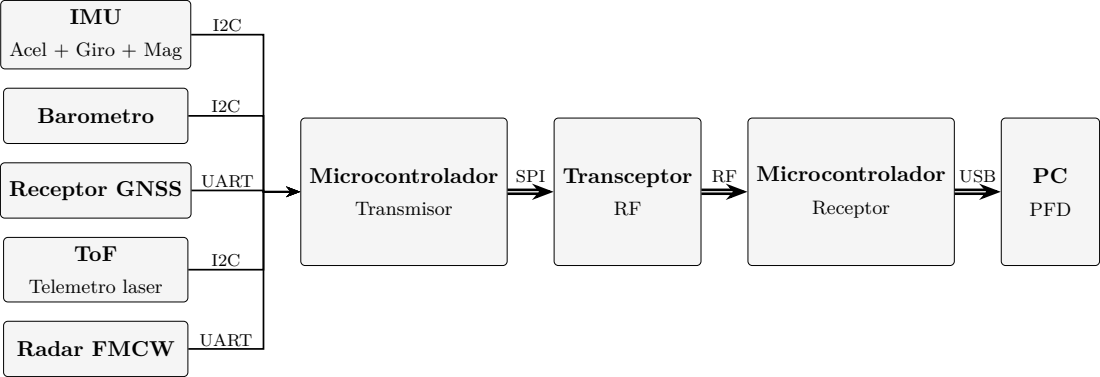
[picture p73: page 1]
Barometro; Receptor GNSS; ToF Telemetro laser; Radar FMCW; Microcontrolador Transmisor; Transceptor RF; Microcontrolador Receptor; PC PFD; UART; SPI; USB

IMU
Acel + Giro + Mag
