arnaumora/TFG-Plataforma-Instrumentacion-Avionica/LATEX/Memoria/Diagramas/cache/main-figure1.pdf

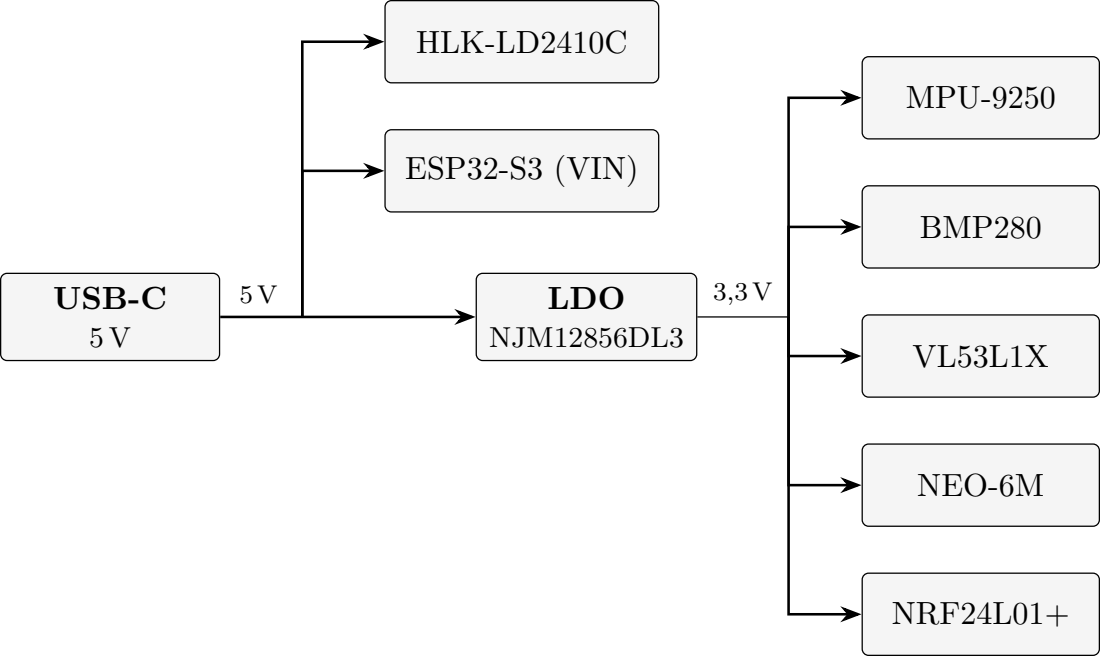
[picture p74: page 1]
USB-C 5 V; LDO NJM12856DL3; ESP32-S3 (VIN); HLK-LD2410C; MPU-9250; BMP280; NEO-6M; NRF24L01+
