arnaumora/TFG-Plataforma-Instrumentacion-Avionica/LATEX/Memoria/Diagramas/cache/main-figure2.pdf

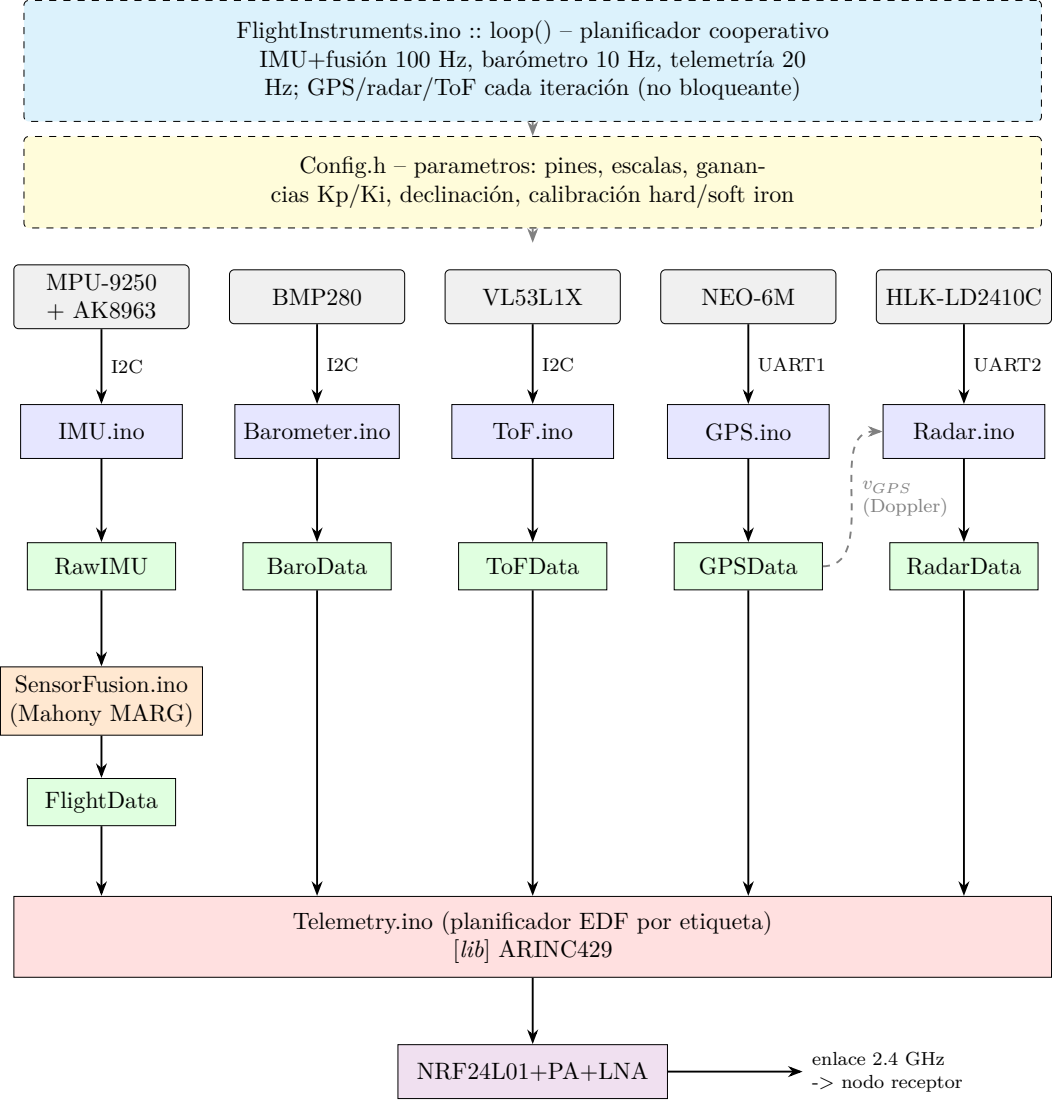
[picture p75: page 1]
MPU-9250; BMP280; NEO-6M; HLK-LD2410C; IMU.ino; Barometer.ino; ToF.ino; GPS.ino; Radar.ino; RawIMU; BaroData; ToFData; GPSData; RadarData; SensorFusion.ino (Mahony MARG); FlightData; [lib] ARINC429; NRF24L01+PA+LNA; UART1; UART2; enlace 2.4 GHz -> nodo receptor; vGP S (Doppler)

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

Config.h – parametros: pines, escalas, ganan-
cias Kp/Ki, declinación, calibración hard/soft iron

Telemetry.ino (planificador EDF por etiqueta)
