arnaumora/TFG-Plataforma-Instrumentacion-Avionica/LATEX/Memoria/Diagramas/cache/main-figure3.pdf

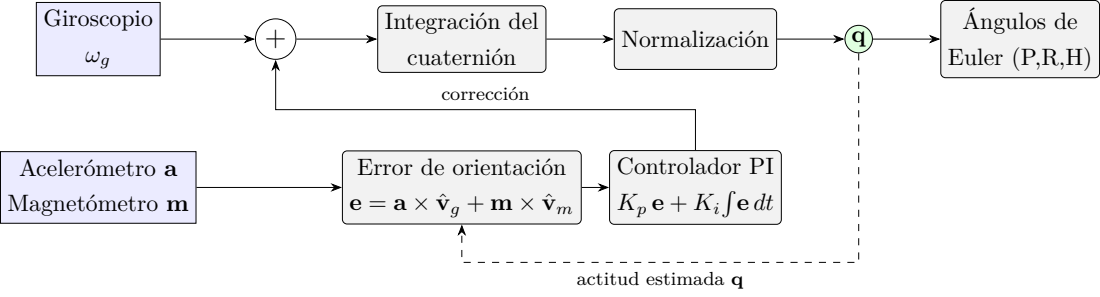
[picture p76: page 1]
Giroscopio; Integración del cuaternión; Normalización; Ángulos de Euler (P,R,H); Acelerómetro a Magnetómetro m; e = a × vˆg; + m × vˆm; Controlador PI; corrección; actitud estimada q

Error de orientación
