arnaumora/TFG-Plataforma-Instrumentacion-Avionica/PCB/PCB/pcb_print(shortedge).pdf

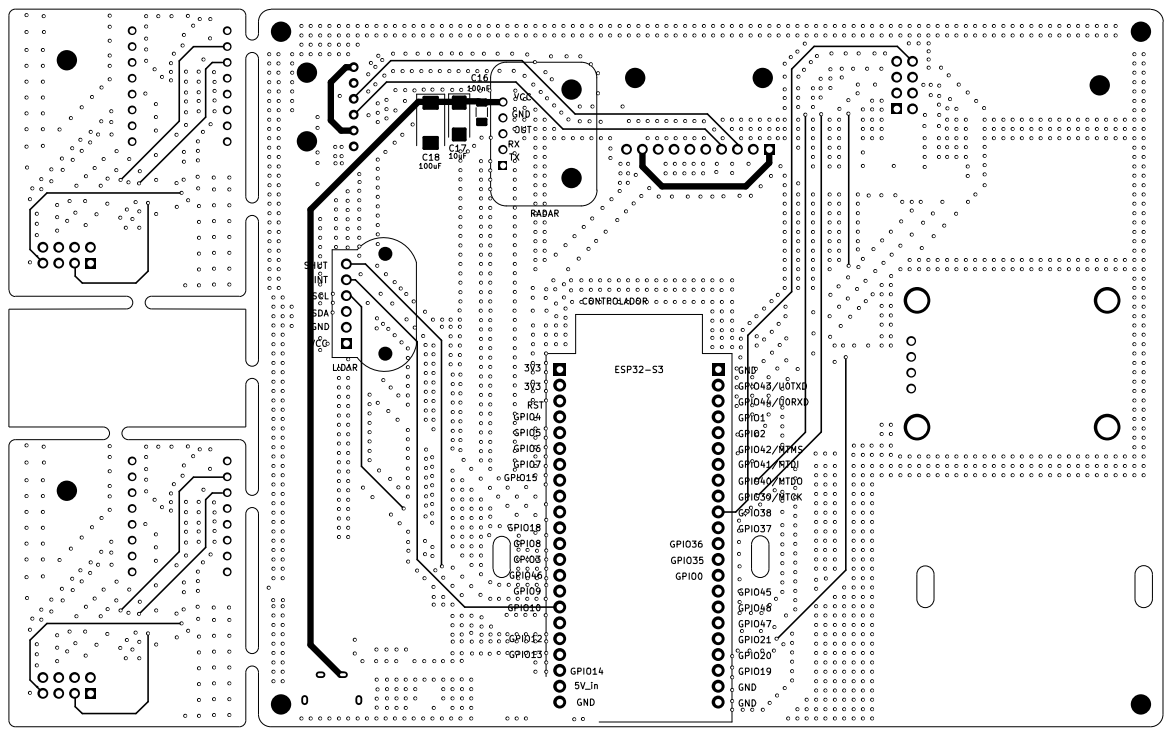
[picture p77: page 1]

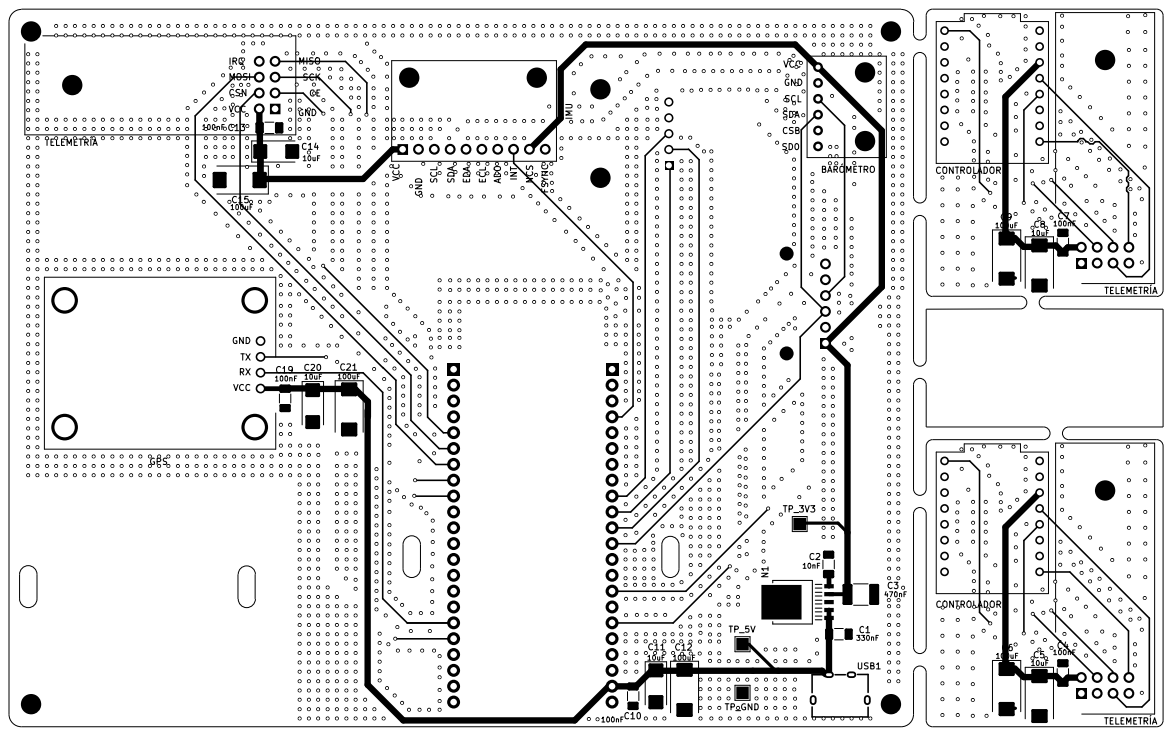
[picture p78: page 2]
