arnaumora/TFG-Plataforma-Instrumentacion-Avionica/LATEX/Memoria/Figures/power_schematic.pdf

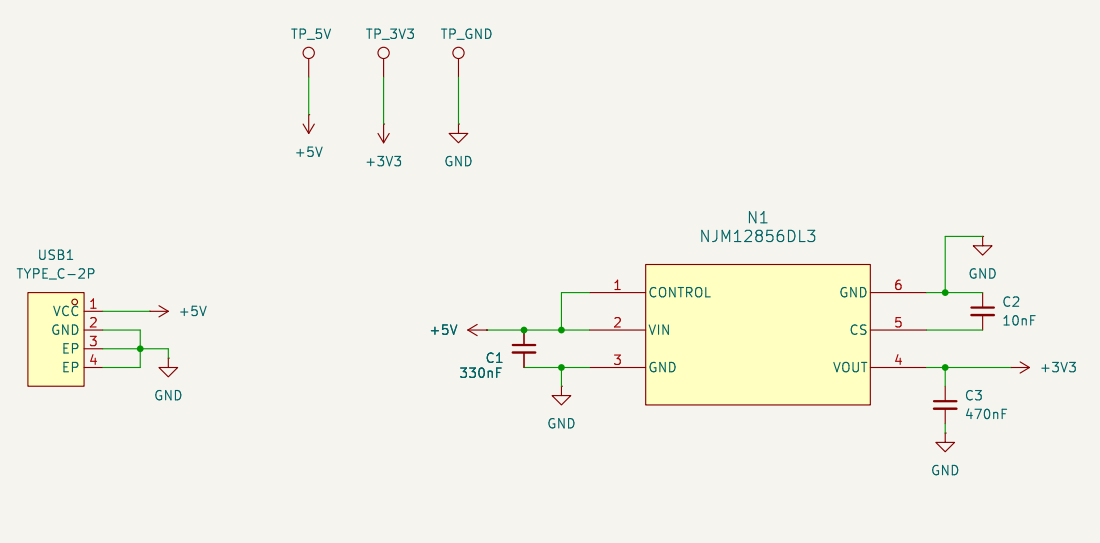
[picture p79: page 1]
