arnaumora/TFG-Plataforma-Instrumentacion-Avionica/LATEX/Memoria/Figures/reciever_schematic.pdf

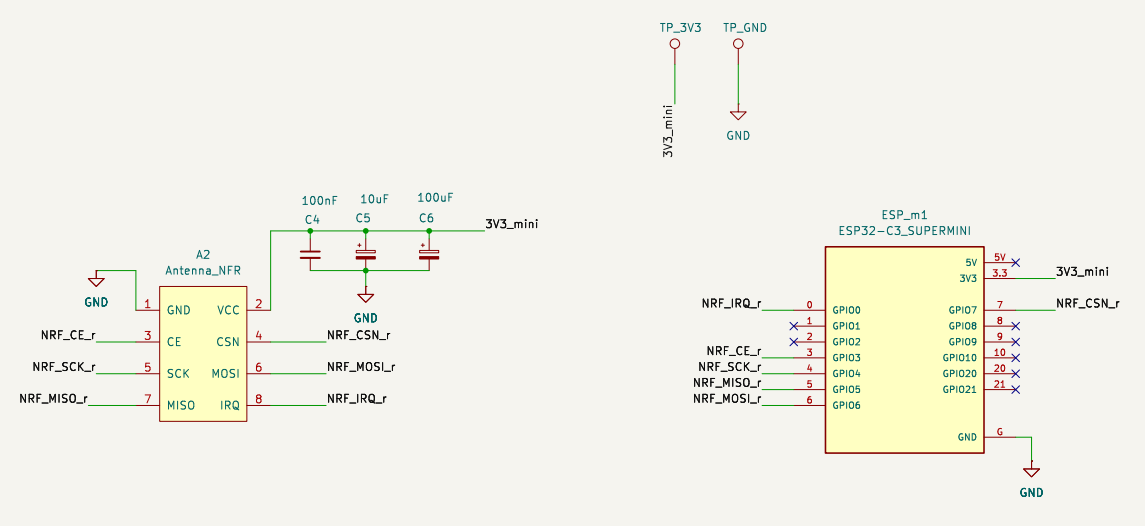
[picture p80: page 1]
