arnaumora/TFG-Plataforma-Instrumentacion-Avionica/LATEX/Memoria/Figures/transmitter_schematic.pdf

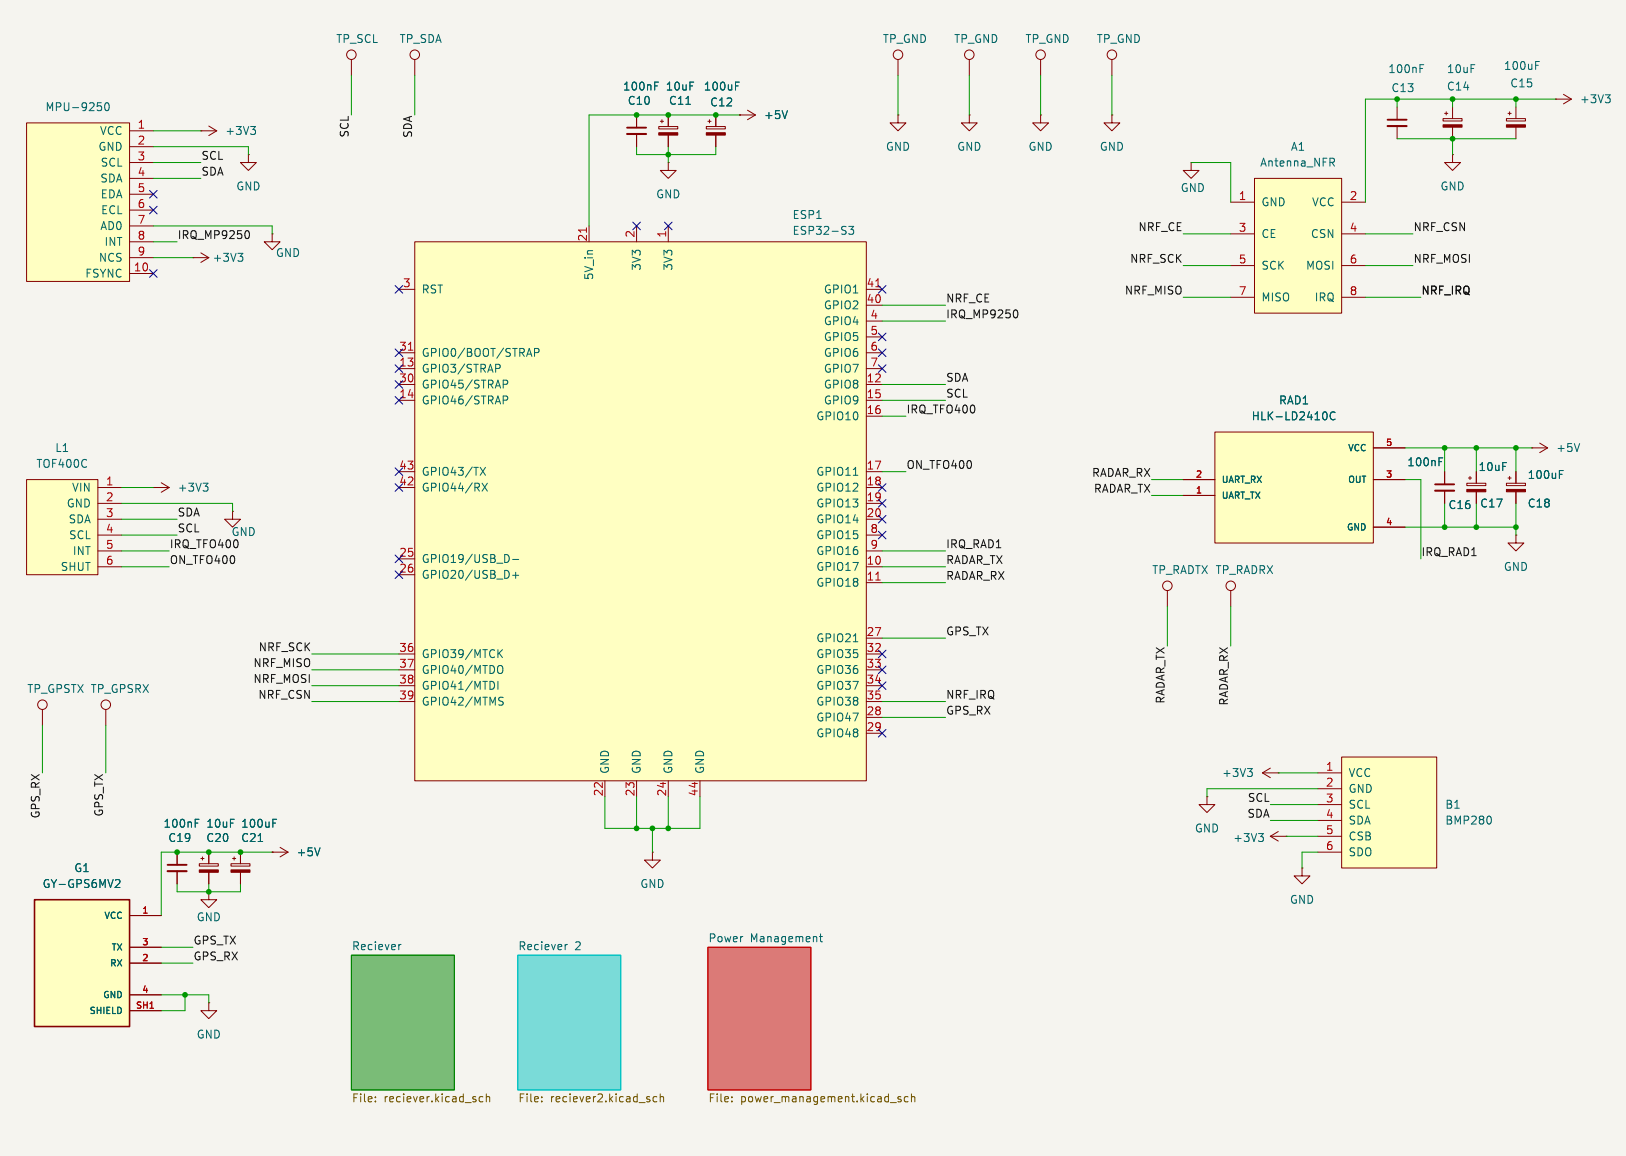
[picture p81: page 1]
