arnaumora/TFG-Plataforma-Instrumentacion-Avionica/PCB/Misc Data/fff515b4de1cf6a9d5e485eadc562f7e.pdf

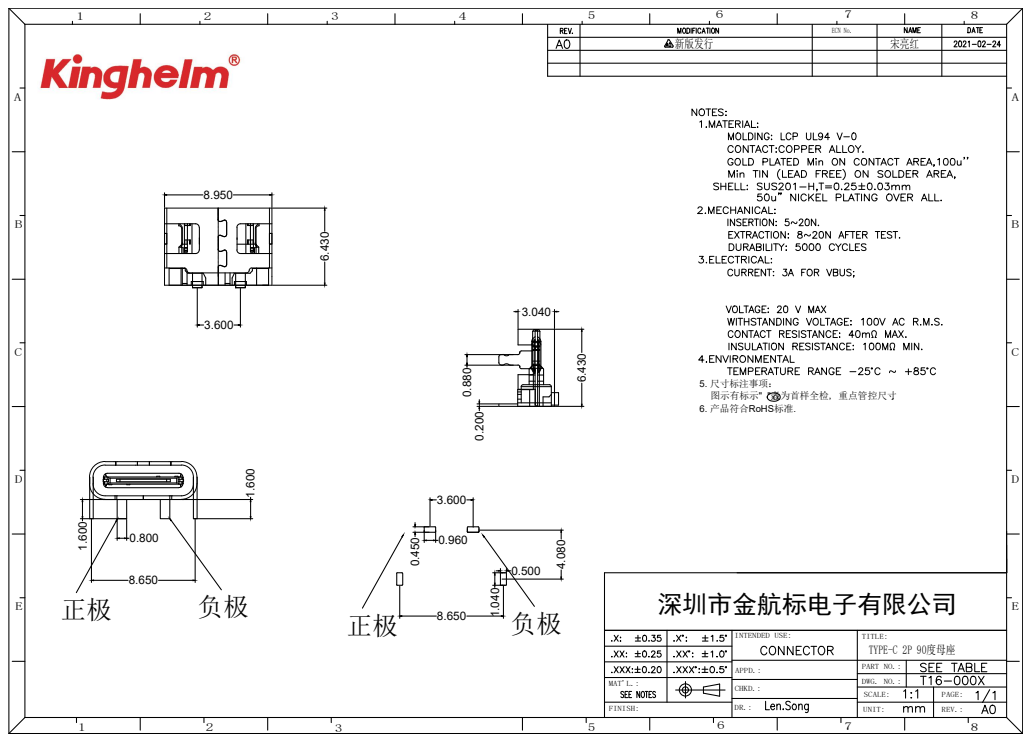
[picture p82: page 1]
PART NO.: FINISH: 5; MAT'L.:; UNIT: 6; 7 CHKD.: APPD.: INTENDED USE:; SCALE: TITLE:; REV.: 8 PAGE:; EDC 5; A ECN No.; DWG. NO.: TYPE-C 2P 90度母座 新版发行; 宋亮红 5. 尺寸标注事项： 图示有标示" "者为首样全检,重点管控尺寸. 6. 产品符合RoHS标准. XX
