arnaumora/TFG-Plataforma-Instrumentacion-Avionica/LATEX/Memoria/Diagramas/cache/main-figure7.pdf

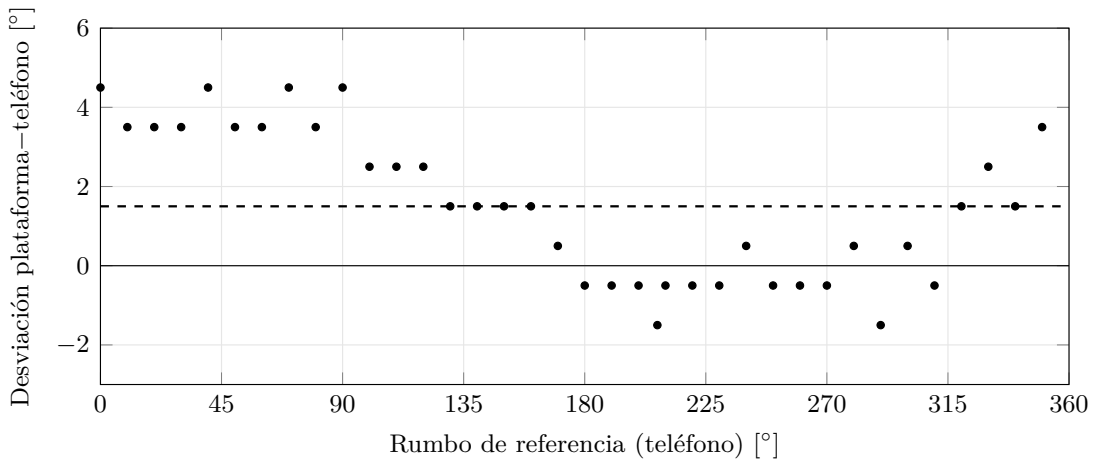
[picture p83: page 1]

Desviación plataforma−teléfono [◦]

Rumbo de referencia (teléfono) [
