arnaumora/TFG-Plataforma-Instrumentacion-Avionica/LATEX/Memoria/Diagramas/cache/main-figure8.pdf

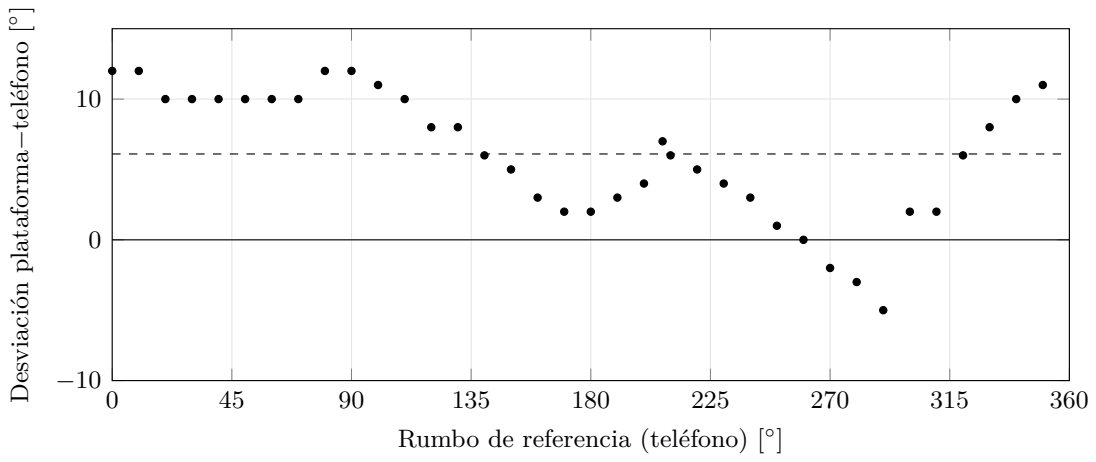
[picture p84: page 1]

Desviación plataforma−teléfono [◦]

Rumbo de referencia (teléfono) [
