arnaumora/TFG-Plataforma-Instrumentacion-Avionica/PCB/PCB/PCB.kicad_pcb

## KiCad design PCB/PCB/PCB.kicad_pcb (2026-07-01)

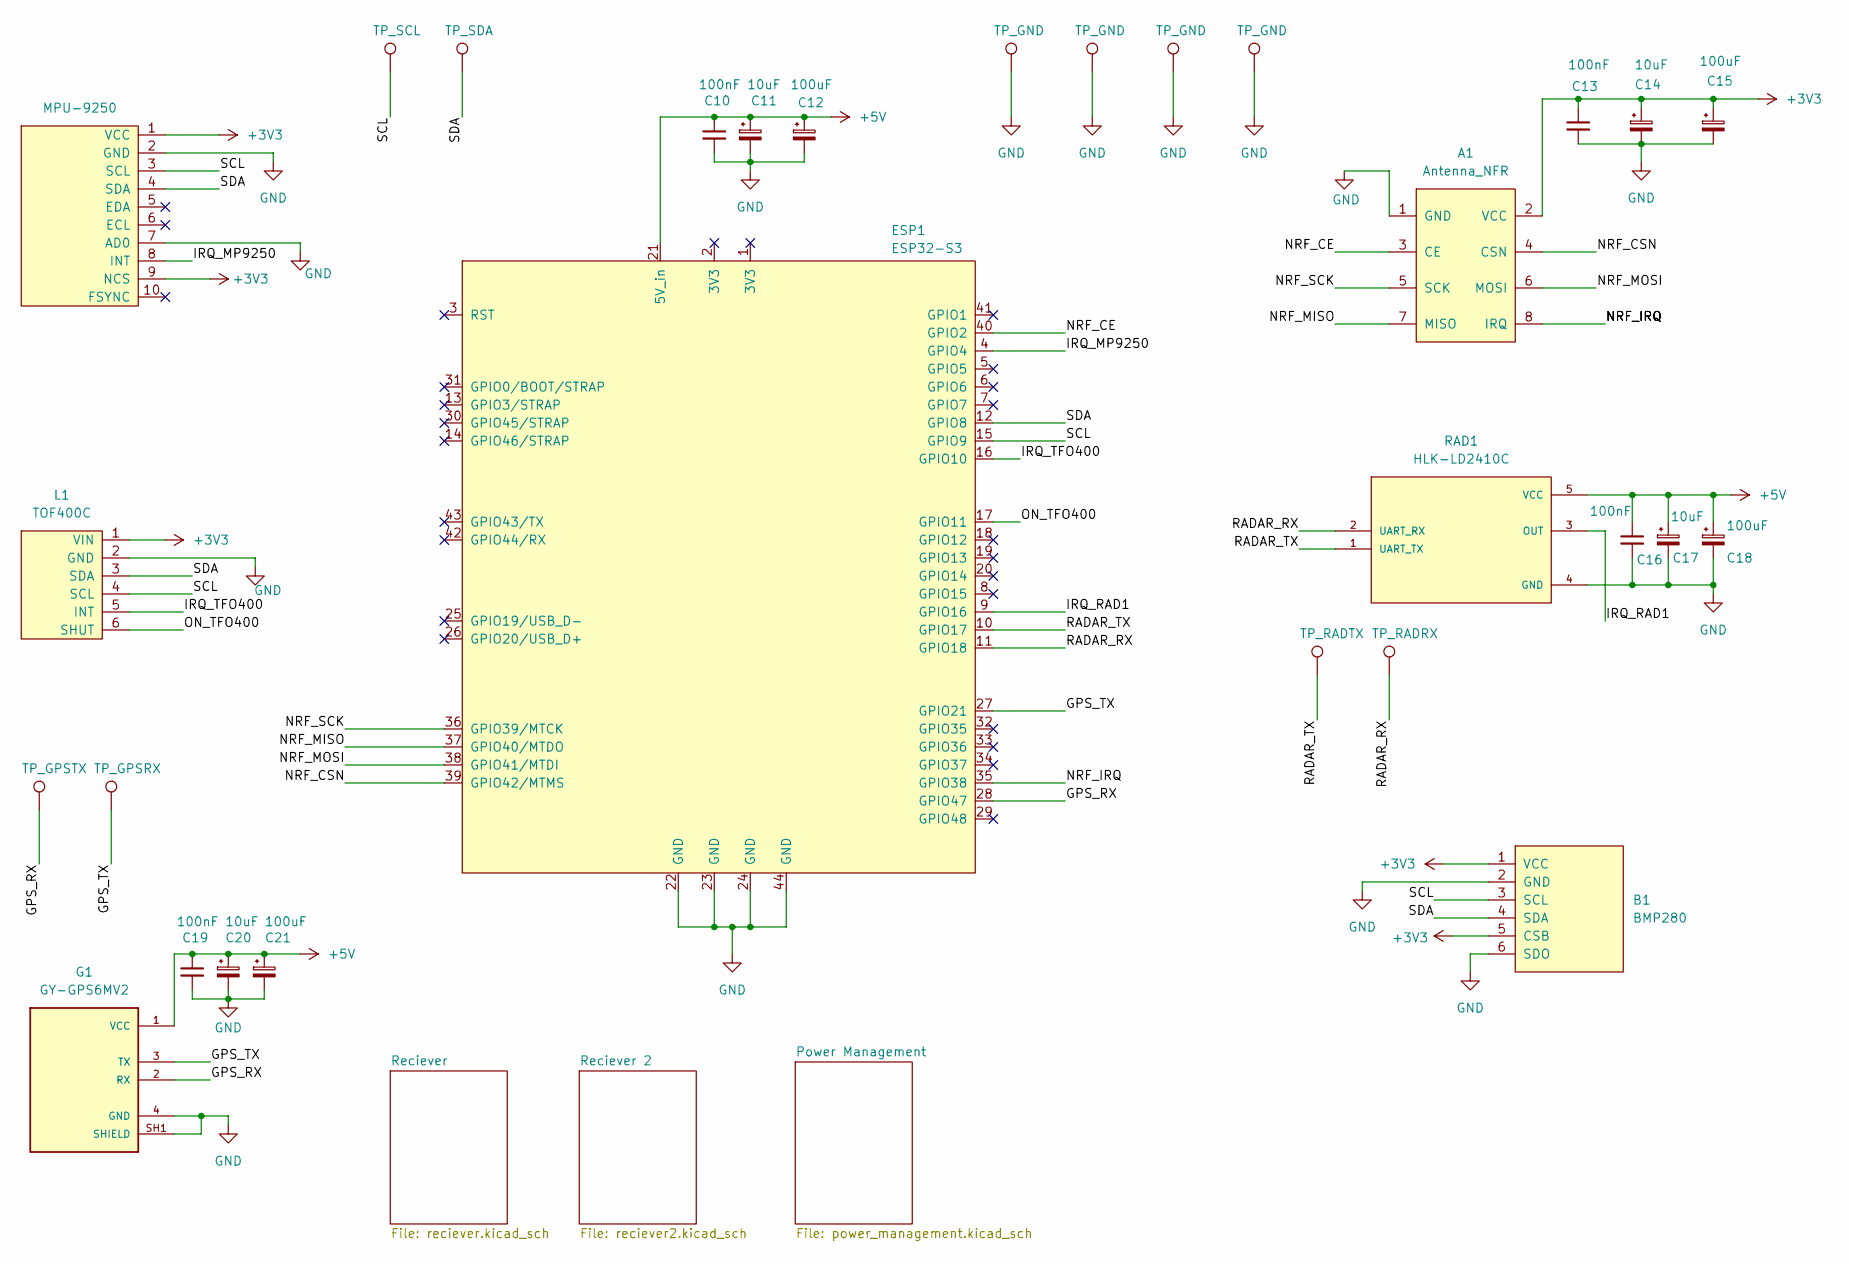
[picture p85: schematic PCB.kicad_sch]

Parts:
A1: Antenna_NFR; NFR24L01_TX
B1: BMP280
C10, C13, C16, C19: 100nF; C_1206_3216Metric_Pad1.33x1.80mm_HandSolder
C11, C14, C17, C20: 10uF; CP_EIA-6032-28_Kemet-C_HandSolder
C12, C15, C18, C21: 100uF; CP_EIA-7343-31_Kemet-D_HandSolder
ESP1: ESP32-S3; YD-ESP32
G1: GY-GPS6MV2
I1: MPU-9250
L1: TOF400C
RAD1: HLK-LD2410C
TP8, TP9, TP10, TP11: TP_GND; TestPoint_THTPad_D1.5mm_Drill0.7mm
TP12: TP_RADTX; TestPoint_THTPad_D1.5mm_Drill0.7mm
TP13: TP_RADRX; TestPoint_THTPad_D1.5mm_Drill0.7mm
TP14: TP_GPSRX; TestPoint_THTPad_D1.5mm_Drill0.7mm
TP15: TP_GPSTX; TestPoint_THTPad_D1.5mm_Drill0.7mm
TP16: TP_SCL; TestPoint_THTPad_D1.5mm_Drill0.7mm
TP17: TP_SDA; TestPoint_THTPad_D1.5mm_Drill0.7mm

Connections:
+3V3: A1.2 (VCC), B1.1 (VCC), B1.5 (CSB), C13.1, C14.1, C15.1, I1.1 (VCC), I1.9 (NCS), L1.1 (VIN); also elsewhere on the board
+5V: C10.1, C11.1, C12.1, C16.1, C17.1, C18.1, C19.1, C20.1, C21.1, ESP1.21 (5V_in), G1.1 (VCC), RAD1.5 (VCC); also elsewhere on the board
/GPS_RX: ESP1.28 (GPIO47), G1.2 (RX), TP15.1
/GPS_TX: ESP1.27 (GPIO21), G1.3 (TX), TP14.1
/IRQ_MP9250: ESP1.4 (GPIO4), I1.8 (INT)
/IRQ_RAD1: ESP1.9 (GPIO16), RAD1.3 (OUT)
/IRQ_TFO400: ESP1.16 (GPIO10), L1.5 (INT)
/NRF_CE: A1.3 (CE), ESP1.40 (GPIO2)
/NRF_CSN: A1.4 (CSN), ESP1.39 (GPIO42/MTMS)
/NRF_IRQ: A1.8 (IRQ), ESP1.35 (GPIO38)
/NRF_MISO: A1.7 (MISO), ESP1.37 (GPIO40/MTDO)
/NRF_MOSI: A1.6 (MOSI), ESP1.38 (GPIO41/MTDI)
/NRF_SCK: A1.5 (SCK), ESP1.36 (GPIO39/MTCK)
/ON_TFO400: ESP1.17 (GPIO11), L1.6 (SHUT)
/RADAR_RX: ESP1.11 (GPIO18), RAD1.2 (UART_RX), TP13.1
/RADAR_TX: ESP1.10 (GPIO17), RAD1.1 (UART_TX), TP12.1
/SCL: B1.3 (SCL), ESP1.15 (GPIO9), I1.3 (SCL), L1.4 (SCL), TP16.1
/SDA: B1.4 (SDA), ESP1.12 (GPIO8), I1.4 (SDA), L1.3 (SDA), TP17.1
GND: A1.1 (GND), B1.2 (GND), B1.6 (SDO), C10.2, C11.2, C12.2, C13.2, C14.2, C15.2, C16.2, C17.2, C18.2, C19.2, C20.2, C21.2, ESP1.22 (GND), ESP1.23 (GND), ESP1.24 (GND), ESP1.44 (GND), G1.4 (GND), G1.SH1 (SHIELD), I1.2 (GND), I1.7 (AD0), L1.2 (GND), RAD1.4 (GND), TP8.1, TP9.1, TP10.1, TP11.1; also elsewhere on the board

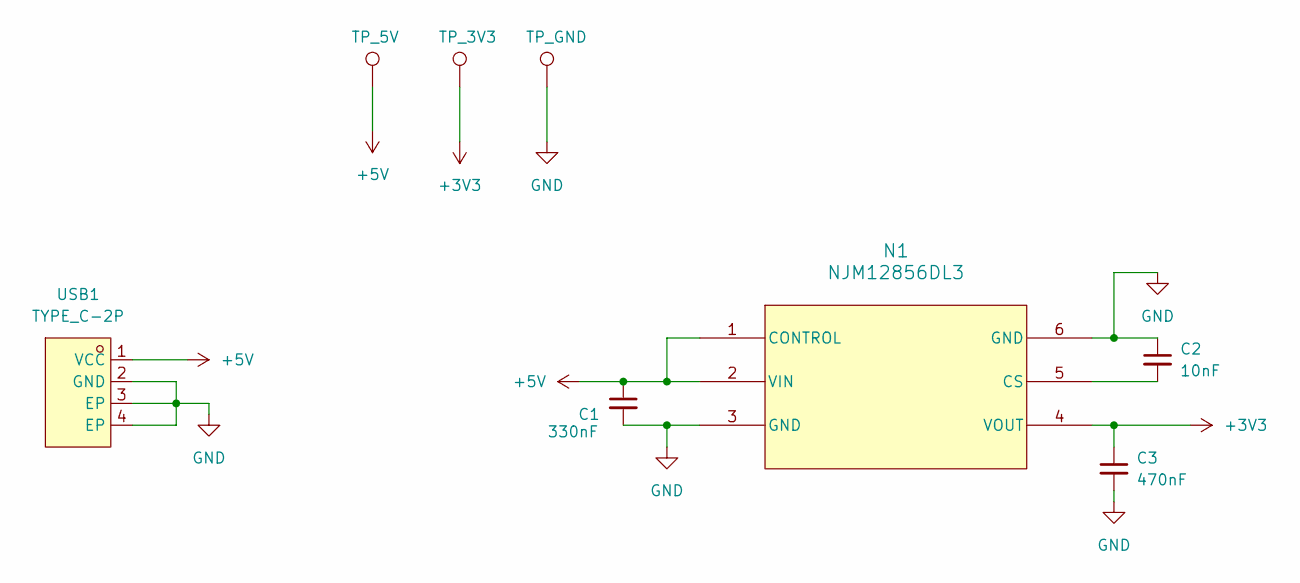
[picture p86: schematic power_management.kicad_sch]

Parts:
C1: 330nF; C_1206_3216Metric_Pad1.33x1.80mm_HandSolder
C2: 10nF; C_1206_3216Metric_Pad1.33x1.80mm_HandSolder
C3: 470nF; C_1812_4532Metric_Pad1.57x3.40mm_HandSolder
N1: NJM12856DL3
TP1: TP_5V; TestPoint_Pad_2.0x2.0mm
TP2: TP_3V3; TestPoint_Pad_2.0x2.0mm
TP3: TP_GND; TestPoint_Pad_2.0x2.0mm
USB1: TYPE_C-2P

Connections:
+3V3: C3.1, N1.4 (VOUT), TP2.1; also elsewhere on the board
+5V: C1.1, N1.1 (CONTROL), N1.2 (VIN), TP1.1, USB1.1 (VCC); also elsewhere on the board
GND: C1.2, C2.1, C3.2, N1.3 (GND), N1.6 (GND), TP3.1, USB1.2 (GND), USB1.3 (EP), USB1.4 (EP); also elsewhere on the board
unnamed: C2.2, N1.5 (CS)

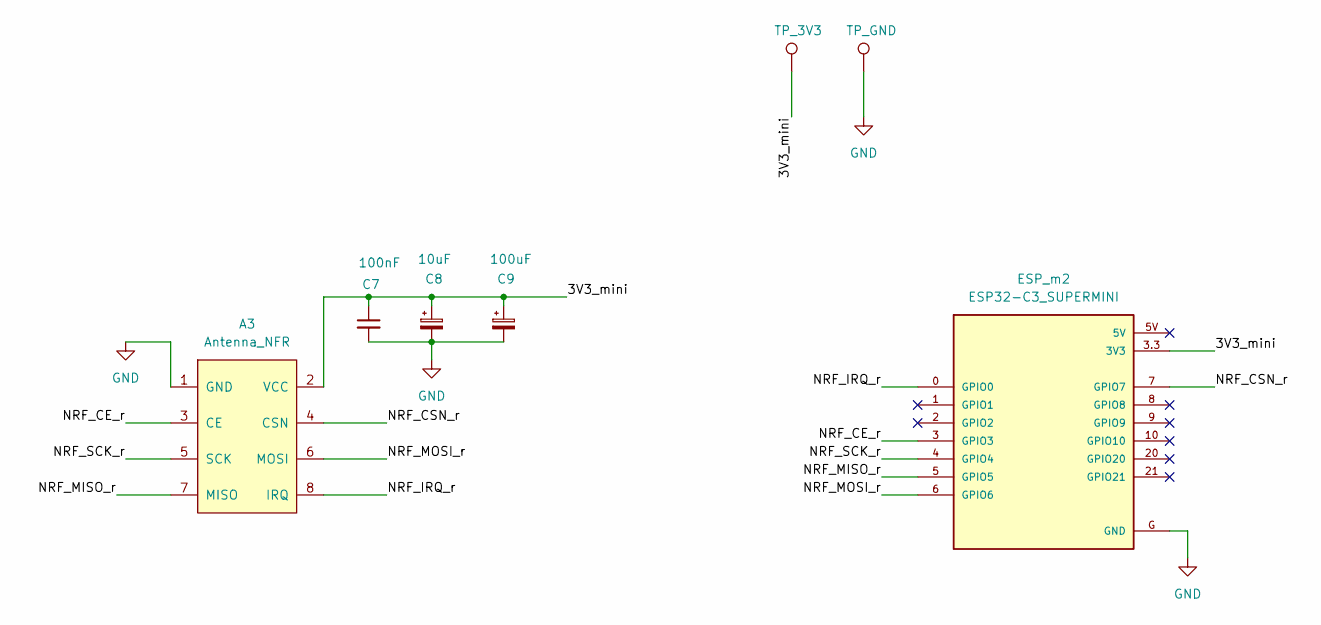
[picture p87: schematic reciever2.kicad_sch]

Parts:
A3: Antenna_NFR; NFR24L01_RX
C7: 100nF; C_1206_3216Metric_Pad1.33x1.80mm_HandSolder
C8: 10uF; CP_EIA-7343-31_Kemet-D_HandSolder
C9: 100uF; CP_EIA-7343-31_Kemet-D_HandSolder
ESP_m2: ESP32-C3_SUPERMINI
TP4: TP_3V3; TestPoint_Pad_2.0x2.0mm
TP5: TP_GND; TestPoint_Pad_2.0x2.0mm

Connections:
/Reciever 2/3V3_mini: A3.2 (VCC), C7.1, C8.1, C9.1, ESP_m2.3.3 (3V3), TP4.1
/Reciever 2/NRF_CE_r: A3.3 (CE), ESP_m2.3 (GPIO3)
/Reciever 2/NRF_CSN_r: A3.4 (CSN), ESP_m2.7 (GPIO7)
/Reciever 2/NRF_IRQ_r: A3.8 (IRQ), ESP_m2.0 (GPIO0)
/Reciever 2/NRF_MISO_r: A3.7 (MISO), ESP_m2.5 (GPIO5)
/Reciever 2/NRF_MOSI_r: A3.6 (MOSI), ESP_m2.6 (GPIO6)
/Reciever 2/NRF_SCK_r: A3.5 (SCK), ESP_m2.4 (GPIO4)
GND: A3.1 (GND), C7.2, C8.2, C9.2, ESP_m2.G (GND), TP5.1; also elsewhere on the board

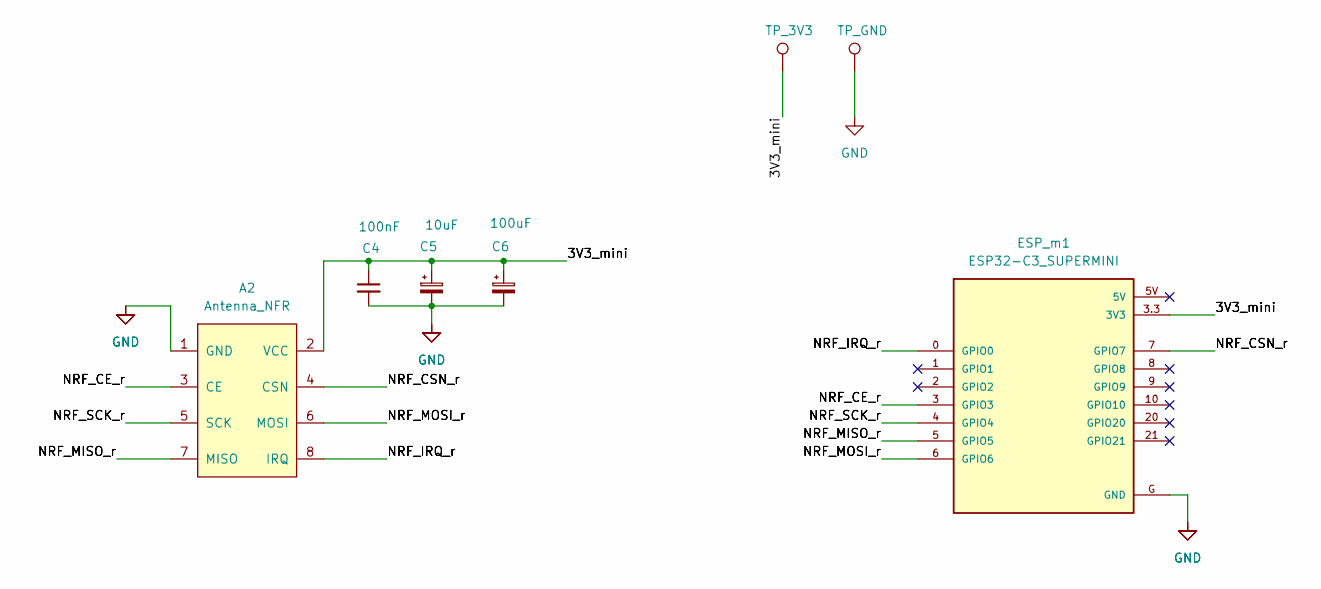
[picture p88: schematic reciever.kicad_sch]

Parts:
A2: Antenna_NFR; NFR24L01_RX
C4: 100nF; C_1206_3216Metric_Pad1.33x1.80mm_HandSolder
C5: 10uF; CP_EIA-7343-31_Kemet-D_HandSolder
C6: 100uF; CP_EIA-7343-31_Kemet-D_HandSolder
ESP_m1: ESP32-C3_SUPERMINI
TP6: TP_3V3; TestPoint_Pad_2.0x2.0mm
TP7: TP_GND; TestPoint_Pad_2.0x2.0mm

Connections:
/Reciever/3V3_mini: A2.2 (VCC), C4.1, C5.1, C6.1, ESP_m1.3.3 (3V3), TP6.1
/Reciever/NRF_CE_r: A2.3 (CE), ESP_m1.3 (GPIO3)
/Reciever/NRF_CSN_r: A2.4 (CSN), ESP_m1.7 (GPIO7)
/Reciever/NRF_IRQ_r: A2.8 (IRQ), ESP_m1.0 (GPIO0)
/Reciever/NRF_MISO_r: A2.7 (MISO), ESP_m1.5 (GPIO5)
/Reciever/NRF_MOSI_r: A2.6 (MOSI), ESP_m1.6 (GPIO6)
/Reciever/NRF_SCK_r: A2.5 (SCK), ESP_m1.4 (GPIO4)
GND: A2.1 (GND), C4.2, C5.2, C6.2, ESP_m1.G (GND), TP7.1; also elsewhere on the board

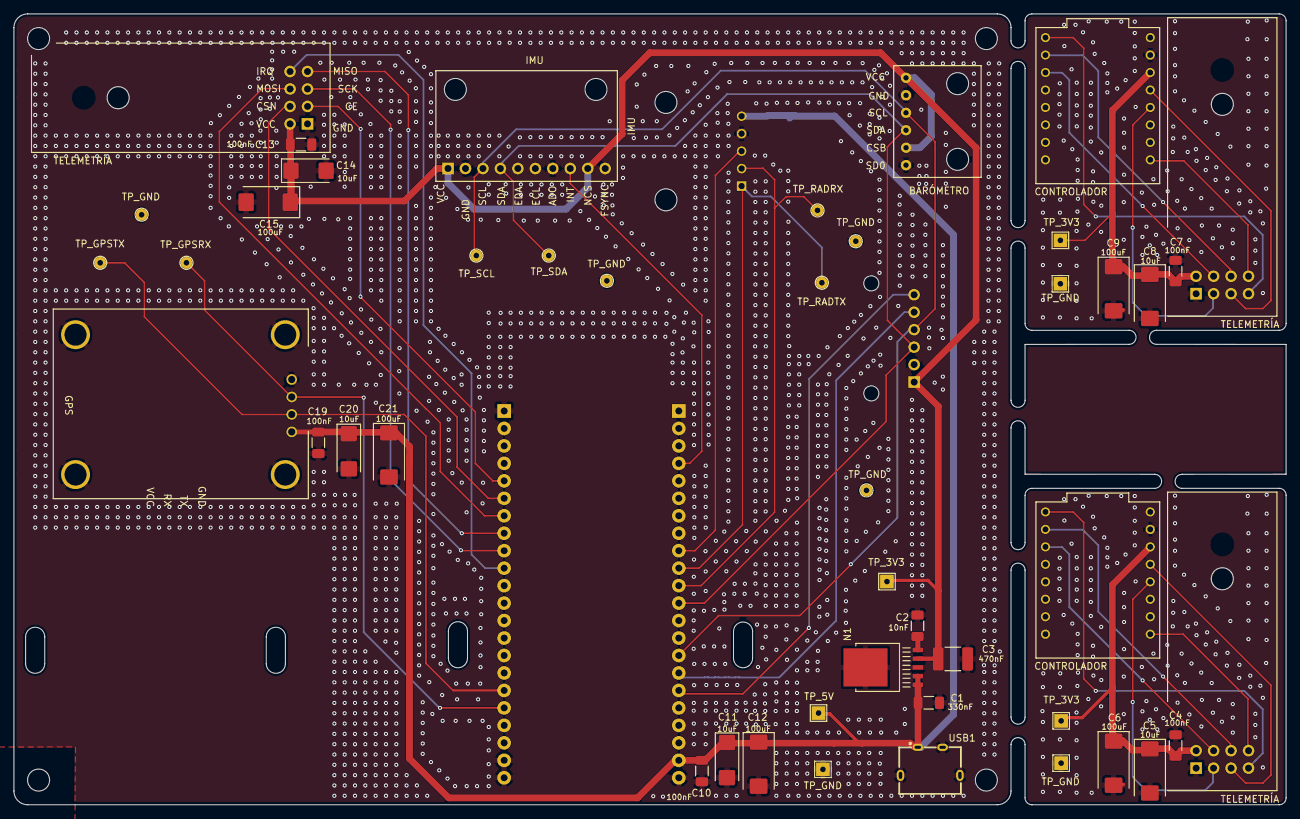
[picture p89: board PCB.kicad_pcb from above]

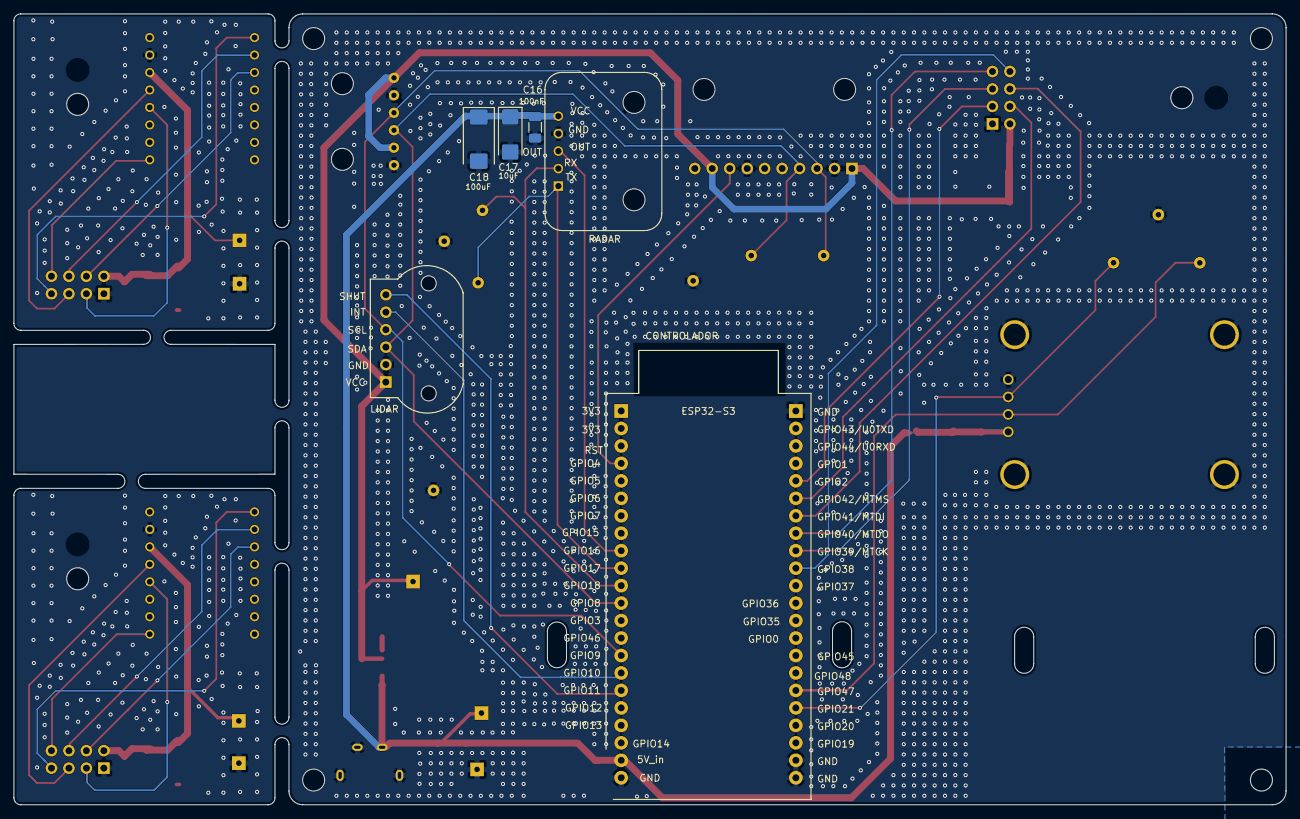
[picture p90: board PCB.kicad_pcb from below]

Board: 2 copper layers, 185.0 x 115.0 mm, 55 parts (6 on the bottom side), 34 nets.

Other parts of the board:
Agujero: -; Agujero
Agujero#2, Agujero#3, Agujero#4: -; Agujero
