arnaumora/TFG-Plataforma-Instrumentacion-Avionica/LATEX/Memoria/Figures/real_reciever_pcb.jpeg

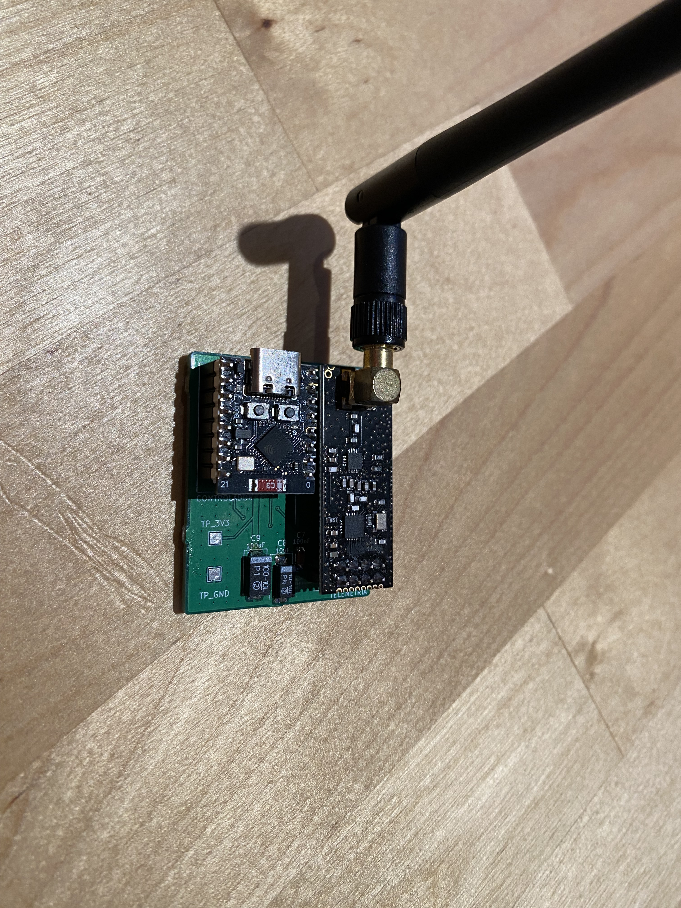
[picture p6: LATEX/Memoria/Figures/real_reciever_pcb.jpeg]
LATEX/Memoria/Figures/real_reciever_pcb.jpeg
