arnaumora/TFG-Plataforma-Instrumentacion-Avionica/LATEX/Memoria/Figures/multi_26.jpeg

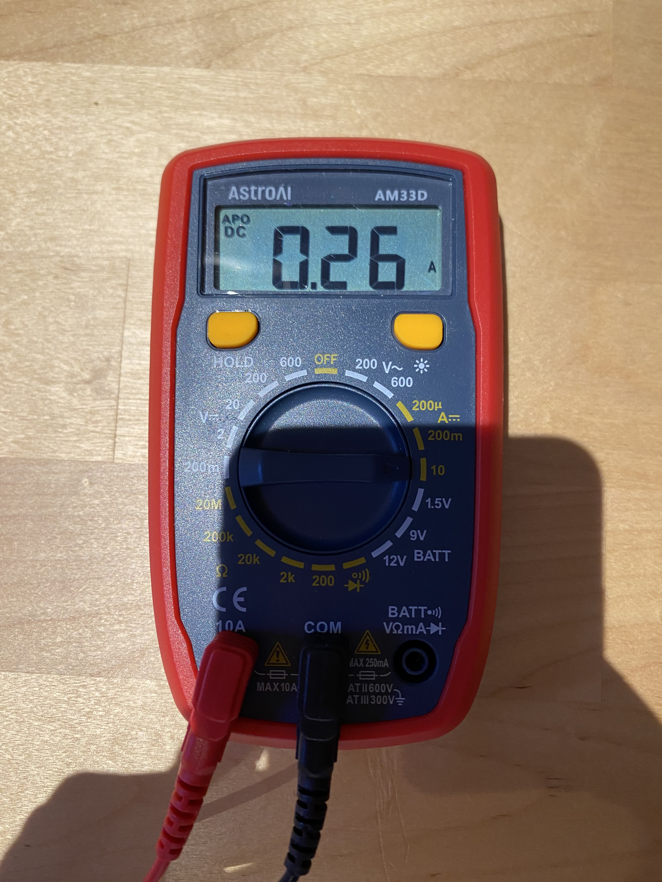
[picture p72: LATEX/Memoria/Figures/multi_26.jpeg]
LATEX/Memoria/Figures/multi_26.jpeg
